petermaerki/puenterswis_heizung_2023_git/README.md

# puenterswis_heizung_2023_git
Puenterswis Heizungsersatz

- [Erfahrungsbericht](./erfahrung_doku/readme.md)
