petermaerki/puenterswis_heizung_2023_git/hardware_zentral/zentral_waermezaehler/readme.txt

https://www.relay.de/produkte/m-bus-master/masterfamilien-w60
