petermaerki/puenterswis_heizung_2023_git/erfahrung_doku/brenner_startzeit/readme.md

# Brenner Startzeit
## Brenner kalt
Puent
12:57 Anforderung an PE1, FA1_TEMP_C ist 24.7C
13:47 PE1 ist warm, die UW Pumpe beginnt zu pumpen.

Vom Moment der Anforderung bis die Pumpe UW anläuft sind 50 Minuten vergangen. Das ist lang.

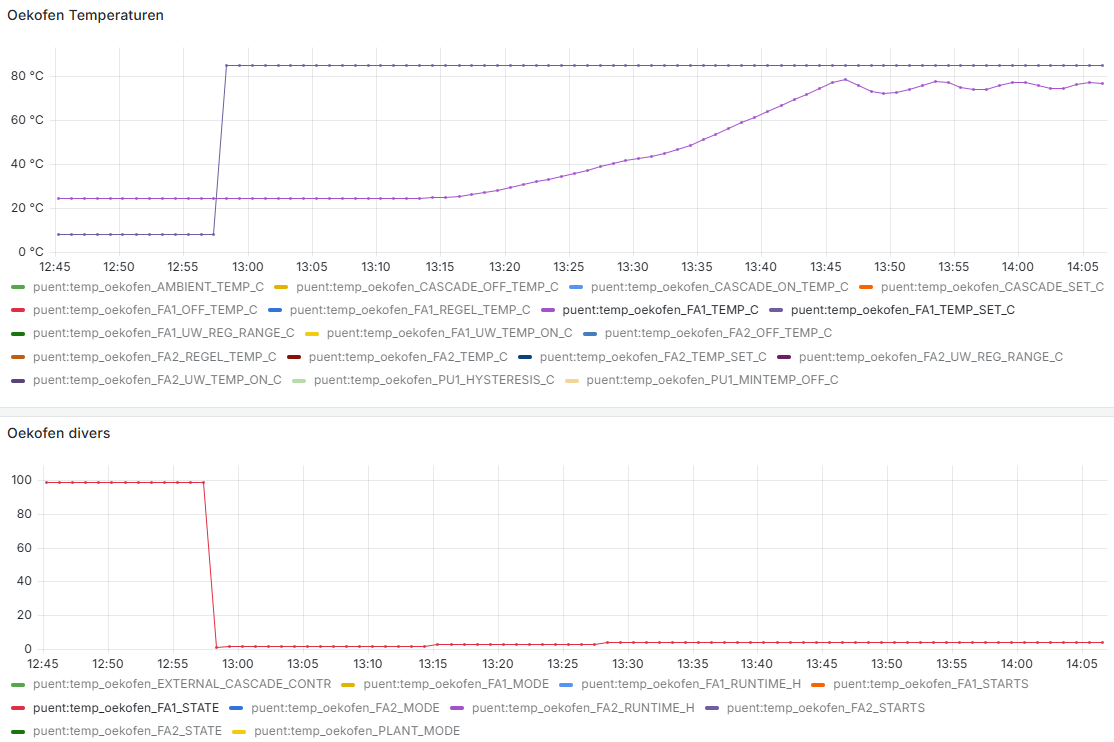
[picture p9: erfahrung_doku/brenner_startzeit/images/brenner_startzeit.png]


http://maerki.com:3000/d/da82d5b6-3fd8-4534-80e5-da1155c11310/uebersicht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

## Brenner bereits warm

Wenn der Brenner bereits warm ist geht es deutlich schneller. z.B. 15 Minuten.
