petermaerki/puenterswis_heizung_2023_git/hardware_zentral/zentral_divers/luefter_ventilator/readme.txt

Luefter klein Bochseln in Loch 150mm

https://cad.onshape.com/documents/6e2a7e5c45c3894bcfb6e976/w/bbece052b184f4fff4f783f4/e/188e28d2e62834fa74d1faa5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

reichelt
Artikel-Nr.: SUN EEC0382B2-0
Axiallüfter, 120x120x38mm, 24V, 197m³/h, 44dBA

grosser Durchmesser 250 mm

https://cad.onshape.com/documents/b72cdd9233a7a05eaaff3341/w/239dae5a9b473663ab37328b/e/b62adbd5fe74eb1d6516e262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
