petermaerki/puenterswis_heizung_2023_git/hardware_dezentral/pcb_kicad/production_v1.0/readme.md

# Upload to JLCPCB

J1: Verschieben
J2: Verschieben
SW1: 90Grad Gegenuhr
U1: 90Grad Uhr
Q1: 180Grad
U2: 180Grad

# Errors to be fixed

C1 ist
alt: C515689, Package 1210
neu: C2897622, Package 1206

Error
The below parts won't be assembled due to data missing.
J1,J2,HOLDER1 designators don't exist in the BOM file.
