petermaerki/puenterswis_heizung_2023_git/hardware_zentral/zentral_steuerung/waveshare/SKU_25739_8-ch_relais_B/README.md

https://www.waveshare.com/modbus-rtu-relay-b.htm

https://www.waveshare.com/wiki/Modbus_RTU_Relay
