petermaerki/puenterswis_heizung_2023_git/software/software-zero/requirements_win.txt

# Auf Windows wird zusätzlich benötigt für zentral\controller_mischventil_test.py

matplotlib
pyqt5
