petermaerki/puenterswis_heizung_2023_git/hardware_dezentral/pcb_kicad/production_v1.0/notes_C7_entfernt.txt

Peter Maerki 2024-03-10_00_15_38

C7 bei allen Leiterplatten ausgeloetet.
Vertraegt sich nicht mit Waveshare Devices welche nur aktiv 1 machen und das 0 passiv mit dem Biasing Network.
