petermaerki/puenterswis_heizung_2023_git/software/software-dezentral/readme_umodbus.md

# MODBUS

| PC | Sensor/Actor | Comment |
| - | - | - |
| Client | Server | new |
| Master | Slave | old |
|  | Host | bad |

## We use these two versions:

* micropython modbus v2.3.7
https://github.com/hmaerki/fork_micropython-modbus/tree/bugfix/on_get_cb-returnvalue-swallowed
https://github.com/hmaerki/fork_micropython-modbus/tree/improve-uart_read_frame
 ->  brainelectronics/micropython-modbus

  * These files have been copied to `micropython/umodbus`

      https://github.com/GimmickNG/pycopy-modbus/tree/mpmodbus-compatibility

      This is a pull request for
https://github.com/brainelectronics/micropython-modbus/pull/56

### Links

* https://www.youtube.com/watch?v=goskYrT9-v4
* https://www.youtube.com/watch?v=BXMauNF7mpU
* https://github.com/brainelectronics/micropython-modbus
* https://pypi.org/project/micropython-modbus/

https://buildmedia.readthedocs.org/media/pdf/pymodbus/latest/pymodbus.pdf

https://www.youtube.com/watch?v=IdTUvQ7X6h8
https://github.com/brainelectronics/micropython-modbus/issues/7

https://de.aliexpress.com/item/1005006139334276.html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

## Documentation

https://micropython-modbus.readthedocs.io/en/latest/umodbus.html#module-umodbus.serial

 * ModbusRTU (client)
   * pins (List[Union[int, Pin], Union[int, Pin]]) – The pins as list [TX, RX]
   * ctrl_pin (int) – The control pin
   * uart_id (int) – The ID of the used UART
 * Serial (server?)

## Hardware

https://micropython-modbus.readthedocs.io/en/latest/EXAMPLES.html#rtu

`RP2 needs "rtu_pins = (Pin(4), Pin(5))" whereas ESP32 can use any pin the following example is for an ESP32`

https://datasheets.raspberrypi.com/pico/Pico-R3-A4-Pinout.pdf
| RX/TX | RP2 | rp2040 | uart_id |
| - | - | - | - |
| TX | Pin(0) | GP0 | 0 |
| RX | Pin(1) | GP1 | 0 |
| TX | Pin(4) | GP2 | 1 |
| RX | Pin(5) | GP3 | 1 |
