petermaerki/puenterswis_heizung_2023_git/software/software-dezentral/rp2_firmware/firmware.md

# Micropython Firmware dezentral

## Actual Firmware

* https://github.com/hmaerki/fork_micropython/blob/hmaerki/XTAL/README_hans.md
* Commit `b18ff701a6b8dee7b2870293053510fd61314032`
* MicroPython v1.22.2-4.gf1d21e75a.dirty on 2024-02-25; Raspberry Pi Pico (slow XTAL) with RP2040
