petermaerki/puenterswis_heizung_2023_git/software/software-zero/doc_collected/pgp.md

# kleopatra

https://github.com/saturneric/GpgFrontend

 * gpg --fingerprint
 * gpg --list-keys
 * gpg --list-secret-keys
