petermaerki/puenterswis_heizung_2023_git/software/software-zero/doc_collected/serial_console.md

# Serial Console

[Enabling Serial Console on Raspberry Pi Zero W](
https://c2plabs.com/blog/2019/04/23/enable-serial-console-on-raspberry-pi-zero-w/)
