petermaerki/puenterswis_heizung_2023_git/hardware_zentral/belimo_waermezaehler_mischer/20240315a_mischventil_abschaetzung.pdf

Belimo Mischventil, Abschätzung

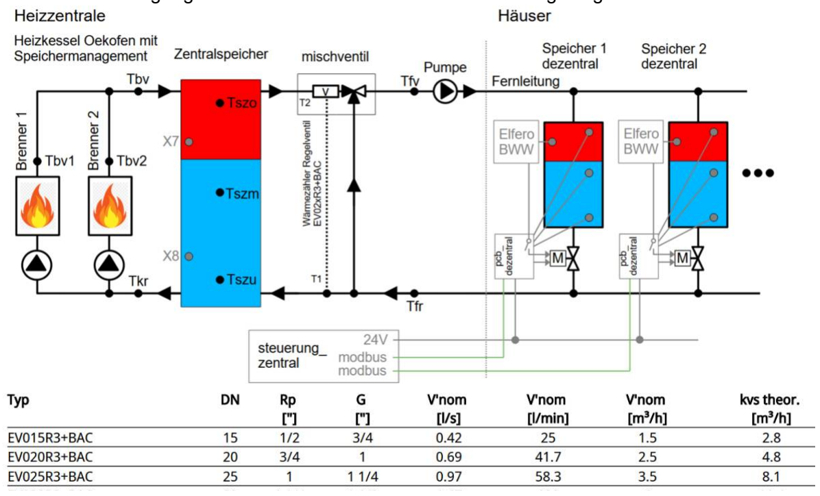
[picture p12: figure]

Pünterswis | Bochslenwis
Typ | EV025R3+BAC EV020R3+BAC
Durchmesser DN25 | DN20
kvs | 8.1 | 4.8 m^3/h
V’nom | 3.5 | 2.5 m^3/h
Fluss beim Laden alle Häuser, Nominalfluss | 2.3 | 1.7 m^3/h
Druckabfall Mischventil @ Nominalfluss | 0.081 | 0.119 bar

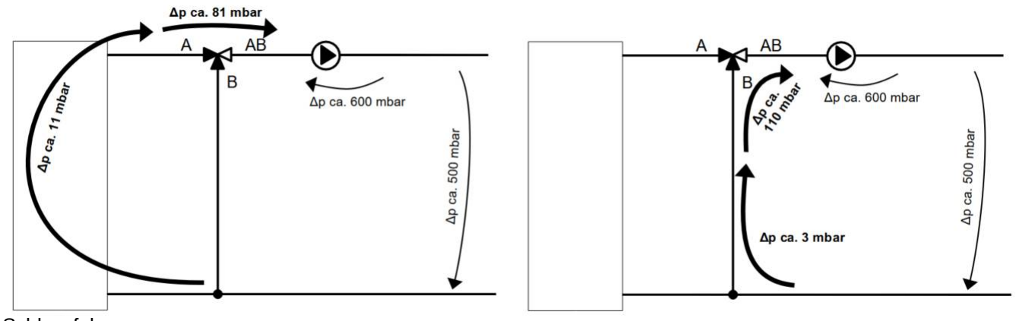
[picture p13: figure]

Dokument | 20240315a_evaluation_typ_gitignore | Peter Märki

Idee: Beimischschaltung für Vorlauftemperaturregelung für die Fernleitung zu den Häusern. Zentrale Steuerung regelt die Position vom EV Ventil: Positionsregelung.

Der Volumenstrom wird durch die Pumpe, die Fernleitung und die Drosseln in den Häusern vorgegeben. Das Mischventil soll lediglich das Mischverhältniss beeinflussen.

Der Druckabfall über den Pufferspeicher und im Bypass-Weg soll deutlich geringer sein als jener über dem Mischventil.

Beispiel Pünterswis
Mischventil A-AB voll offen, Position 90°

Beispiel Pünterswis
Mischventil B-AB voll offen, Position 0°

Schlussfolgerung:
Der Druckabfall über dem Mischer ist mit ca. 0.1 bar deutlich grösser als der Druckabfall in Pufferspeicher oder Bypass-Weg welcher im Bereich 0.01 bar liegt. Das sollte sich gut regeln lassen. Wichtig: grosse Querschnitte und kurze Leitungen zum Speicher.

Falls nur einzelne Häuser geladen werden, so ist der Fluss kleiner. Bei einem einzelnen Haus fliessen noch ca. 0.2 m^3/h. Mit so einem kleinen Fluss könnte die Strömung im Mischventil laminar werden. Allenfalls lässt ich die Temperatur dann nicht mehr sauber regeln.
