petermaerki/puenterswis_heizung_2023_git/hardware_dezentral/dezentral_elfero/20240917a_elfero_schaltpunkte.ods

Sheet: elfero regler dezentral abklaerungen tests
Unterstationen Regler Elfero
2023-08-03 | Entscheid für Umbau
 | Sensor BWW beschriften mit «BWW Warmwasser Klemme 32»
 | Sensor BK entfernen. Fixwiderstand 1100 Ohm auf Klemmen GND und 28.
2023-08-03 | Peter Schär und Peter Märki gehen zu Elfero nach Meisterschwanden.
 | Es hat zwei Testboxen, da kann ein Temperaturregler eingesteckt werden.
 | Teils Trimmer sind marode, teils Kontakte lottern.
 | Nach ca. 5 Stunden kommen wir zur Erkenntnis: Wir verstehen alle nicht
 | wie die beiden Temperatursensoren verknüpft sind.
 | Der Kesselsonsor sollte eigentlich an einen Kessel. Wir haben keinen Kessel und bei uns ist er am Speicher eingesteckt
 | Kessel und Warmwasser Logik sind irgendwie verknüpft
 | Kessellogik spielt mit:
 | Par | 151 | 70 | C
 | Par | 140 | 20 | K
 | wenn BWW kalt so schaltet die Sache bei 70C aus und 70-20C ein. Unklar.
 | Der Warmwassersensor BWW spielt mit:
 | Par | 190 | 45 | C | Warmwasser soll, oberer limit
 | Eingestellte Temperatur für Warmwasser mit der Bedienung vom Endbenutzer
 | Par | 191 | 10 | K
 | Falls der BK Sensor gut gewählt ist, so schaltet es BWW bei 45-10/2 ein und bei 45+10/2 aus.
 | Falls der BK zu hoch oder zu tief ist, schaltet es anders. Wir finden nicht von was das abhängt.
 | Es wäre schön eine einfacher Logik zu haben. Edin experimentiert und schaltet diverses aus und ein, er scheitert.
 | Wir versuchen die Sache einfacher zu machen indem wir den BK Fühler auf eine fixe Temperatur legen.
 | BK |  | BK
 | Festwertwiderstand |  | Angezeigt C
 | 1000 |  | 25 |  | komisch
 | 1050 |  | 31 |  | komisch
 | 1070 |  | 33 |  | hier funktioniert der BW Sensor wie erwartet
 | 1130 |  | 41 |  | hier funktioniert der BW Sensor wie erwartet
 |  |  | 47 |  | komisch
 | 1100 |  | 37 |  | Festwiderstand wahl
 | Wir entscheiden uns: wir ersetzen den BK Sensor durch einen Festwertwiderstand von 1130 Ohm entspricht 41C. Besser 1100 Ohm da Standard.
 | Jetzt verhält sich die Warmwasser BK wir erwartet. Die Sache ist einfacher da nur noch Sensor BWW.
 | Versuche:
 |  | (Par 190) | WW soll | Par 191 | Varieren BW Temperatur
 |  | limite |  |  | ein bei C | aus bei C
 |  | '(55) | 55 | 10 | 50 | 60
 |  | (35) | 35 | 10 | 30 | 40
 |  | '(35) | 35 | 4 | 33 | 37
 | Wir können mit der WW soll und Par 191 die Schaltemperaturen wählen, das ist ok.
 |  |  |  |  |  |  |  |  | Notizen…
 |  |  |  |  | Testgerät |  |  |  | glaube
 |  |  |  |  |  |  |  |  | nicht
 |  |  |  |  |  |  |  |  | alles
2023-07-15
 | Peter Schär und Peter Märki experimentieren mit der Heizung von Peter Schär, Zelglistrasse 48
 | Elfero RDO244?
 | Es gibt zwei Temperatursensoren für den Speicher. Deren Temperatur kann man anschauen:
 | Elfero, «Pfeil nach unten» bis Service, jetzt «Nr» bis 1 oder 21
 |  |  |  |  |  | Elfero |  | Elfero Bezeichnung
 | Sensor oben, etwa dort wo Fernleitung rein kommt |  |  |  |  | Service | 1 | Warmwasser_1 |  | BWW | B58 | Klemme 32
 | Sensor mitte, etwa 20 cm tiefer als sensor oben |  |  |  |  | Service | 21 | Kesseltemperatur |  | BK | B57 | Klemme 28
 |  |  |  |  |  |  |  |  | oben
 |  |  |  |  |  |  |  |  | mitte
 | Experimente, durch Herausziehen der Sensoren
 | Sensor | Sensor
 | oben | mitte | ventil blau | anzeige
 | kalt | kalt | offen | Brenner «1, 2»
 |  | kalt |  |  |  | oben wärmt auf, bei über 50C macht Ventil zu, Anzeige erlischt
 | warm | kalt | zu | -
 |  | kalt |  |  |  | oben raus, kühlt ab, bei unter 40C macht ventil auf
 |  | kalt | offen | Brenner «1, 2»
 | kalt | kalt | offen | Brenner «1, 2»
 | kalt | warm | offen | Brenner «1, 2» |  | mitte rein, passiert nichts
 |  | warm |  |  |  | oben rein, bei über 50C macht Ventil zu, Anzeige erlischt
 | warm | warm | zu | -
 | kalt | warm | zu | - |  | oben raus, passiert nichts
 | kalt |  |  |  |  | mitte raus, bei 21 unter 50C geht ventil auf
 | kalt | kalt | offen | Brenner «1, 2»
 | Schlussfolgerung
 |  | Wenn mitte genügend kalt, so wird mit dem oberen das Ventil auf und zu gemacht und Brenner «1,2» gesteuert.
 |  | Ich verstehe die Logik noch nicht wirklich
 |  | oben unter 40C: ventil auf
 |  | oben über 50C: ventil zu
 | Einstellungen bei Peter Schär
 |  | Par | 140 | Schaltdifferenz der Brennerstufe 1 |  |  |  | 20 | K
 |  | Par | 141 | Schaltdifferenz der Umschaltung Stufe 2 |  |  |  | 10 | K
 |  | Par | 142 | Minimale Einschaltverzögerung STufe 2 |  |  |  | 0 | min
 |  | Par | 190 | Maximalbegrenzung Warmwasser-Solltemperatur |  |  |  | 45 | C
 |  |  | (höher kann der Benutzer nicht gehen?)
 |  | Par | 191 | Schaltdifferenz Warmwasser |  |  |  | 10 | K
 | Warmwasser Solltemperatur Benutzerebene
 |  | (vermutlich auf das bei Par 190 eingestellte maximum eingestellt) |  |  |  |  |  | 45 | C
 |  | Schaltschwellen
 |  |  | Warmwasser Solltemperatur plus ½ Schaltdifferenz Par_191
 |  |  |  |  |  | Heizung ein bei |  | 50 | C
 |  |  | Warmwasser Solltemperatur minus ½ Schaltdifferenz Par_191
 |  |  |  |  |  | Heizung aus bei |  | 40 | C

Sheet: elfero einstellungen 2024
Unterstationen Regler Elfero
2024-06-05 | Einstellungen vorzunehmen bei allen Häusern
 | Parameter 190 legt die maximale Warmwasser Solltemperatur fest.
 | Aktive Schaltschwellen gemäss «Warmwasser Solltemperatur Benutzerebene»
 | Vorgehen
 | Fachmannebene: zu Service mit Pfeil, dann «No» und «+» für 5 s gedrückt halten.
 | Parameter 190 muss auf |  | 55 | sein
 | Parameter 191 muss auf |  | 10 | sein
 | Pfeil nach unten bis |  |  | Solltemperatur Wasser
 | Einstellen der Solltemperaturen mit No und + -
 | Hintergrund: auch in der Nacht und auch bei Frostschutz soll der Speicher für das Brauchwasser warm sein.
 | Info, Bedeutung
 | Hintergrund: Die Ladung soll immer gleich erfolgen.
 | Ausstecken 220V und wieder einstecken (hatte es, dass es erst nach einem Neustart korrekt funktioniert).
 | Standard Raumtemperaturen einstellen |  |  |  |  | Einstellen:
 |  |  |  |  |  | 1 | 5
 |  |  |  |  |  | 2 | 15
 |  |  |  |  |  | 3 | 20
 |  | Diese Temperaturen haben einen Einfluss ab welcher Aussentemperatur die Pumpe zu laufen beginnt.
 | BWW kalt, kleiner 50C |  | BWW heiß, wärmer als 60C
 | Blaues Ventil offen |  | Blaues Ventil zu
Tests mit Ausbaustufe E1
 | Test der Funktion, Start durch Druck auf die Testtaste auf pcb_dezentral |  |  |  |  |  |  | Ohmmeter
 |  |  |  |  |  |  |  | Pin 5 und 6
 | BWW |  |  | Relais Automatik |  | Relais valve_open | blaues ventil soll | soll
 | kalt (< 50) | Taste drücken | 40 Sekunden | 0 | (→ Manuell) | 0 | offen | geschlossen
 | kalt (< 50) |  | 40 Sekunden | 1 | (-> Automatik) | 0 | zu | geschlossen
 | kalt (< 50) |  | 40 Sekunden | 1 | (-> Automatik) | 1 | offen | geschlossen
 | warm(> 60) | Taste drücken | 40 Sekunden | 0 | (→ Manuell) | 0 | zu | offen
 | warm(> 60) |  | 40 Sekunden | 1 | (-> Automatik) | 0 | zu | offen
 | warm(> 60) |  | 40 Sekunden | 1 | (-> Automatik) | 1 | offen | offen
 | Testen ob Anforderung auf Elfero 5 und 6 mit Ohmmeter
