petermaerki/puenterswis_heizung_2023_git/hardware_zentral/zentral_temperatursensoren/20240707a_beschriftung_zentral_temperatursensoren_13.ods

zentral_temperatursensoren Modbus 13: Messung von Temperaturen bei den Brennern. Messung von Temperaturen in der Heizzentrale. pcb_dezentral mit ds18b20 Sensoren. 24V Versorgung von steuerung_zentral Verbindung zu steuerung_zentral über Modbus. LED rot:TX und blau:RX. Nichts ändern! 2024 Peter Märki 0764772290, Peter Schär 0786326934
zentral_temperatursensoren Modbus 13: Messung von Temperaturen bei den Brennern. Messung von Temperaturen in der Heizzentrale. pcb_dezentral mit ds18b20 Sensoren. 24V Versorgung von steuerung_zentral Verbindung zu steuerung_zentral über Modbus. LED rot:TX und blau:RX. Nichts ändern! 2024 Peter Märki 0764772290, Peter Schär 0786326934
