petermaerki/puenterswis_heizung_2023_git/hardware_dezentral/dezentral_beschriftung/20240519a_beschriftung_verteilerboxen_fernleitung.ods

Schlaufbox: Fernleitung zur Heizzentrale 6 Adernpaare, max 24V | Schlaufbox: Fernleitung zur Heizzentrale 6 Adernpaare, max 24V
Schlaufbox: Fernleitung zur Heizzentrale 6 Adernpaare, max 24V | Schlaufbox: Fernleitung zur Heizzentrale 6 Adernpaare, max 24V
Schlaufbox: Fernleitung zur Heizzentrale 6 Adernpaare, max 24V | Schlaufbox: Fernleitung zur Heizzentrale 6 Adernpaare, max 24V
Schlaufbox: Fernleitung zur Heizzentrale 6 Adernpaare, max 24V | Schlaufbox: Fernleitung zur Heizzentrale 6 Adernpaare, max 24V
Schlaufbox: Fernleitung zur Heizzentrale 6 Adernpaare, max 24V | Schlaufbox: Fernleitung zur Heizzentrale 6 Adernpaare, max 24V
Schlaufbox: Fernleitung zur Heizzentrale 6 Adernpaare, max 24V | Schlaufbox: Fernleitung zur Heizzentrale 6 Adernpaare, max 24V
Schlaufbox: Fernleitung zur Heizzentrale 6 Adernpaare, max 24V | Schlaufbox: Fernleitung zur Heizzentrale 6 Adernpaare, max 24V
Schlaufbox: Fernleitung zur Heizzentrale 6 Adernpaare, max 24V | Schlaufbox: Fernleitung zur Heizzentrale 6 Adernpaare, max 24V
Schlaufbox: Fernleitung zur Heizzentrale 6 Adernpaare, max 24V | Schlaufbox: Fernleitung zur Heizzentrale 6 Adernpaare, max 24V
Schlaufbox: Fernleitung zur Heizzentrale 6 Adernpaare, max 24V | Schlaufbox: Fernleitung zur Heizzentrale 6 Adernpaare, max 24V
Schlaufbox: Fernleitung zur Heizzentrale 6 Adernpaare, max 24V | Schlaufbox: Fernleitung zur Heizzentrale 6 Adernpaare, max 24V
Schlaufbox: Fernleitung zur Heizzentrale 6 Adernpaare, max 24V | Schlaufbox: Fernleitung zur Heizzentrale 6 Adernpaare, max 24V
