petermaerki/puenterswis_heizung_2023_git/hardware_zentral/belimo_waermezaehler_mischer/20240506a_spannung_zu_winkel.ods

Belimo Wärmezähler Evaluation, Fluss, Druckabfall, Regelung
Puent | fluss max |  | 2.3 | m^3/h
Bochs | fluss max |  | 1.656 | m^3/h
Puent | Leistung max |  | 67 | kW
Bochs | Leistung max |  | 49 | kW
Belimo BAC
belimo_EV..R3_BAC_datasheet_de-ch
belimo_notes-for-project-planning_3-way-energy-valves_de-ch.pdf
Ich interpretiere «minimaler Druckabfall» als Druckabfall bei Ventil voll offen und gewünschtem Fluss.
 |  |  | Aus Diagramm |  | Gemaess Formel, passt
 |  |  | Druckabfall Mischventil
 | fluss max |  | DN20 | DN25 | DN15 | DN20 | DN25
Puent | 2.3 | m^3/h | 0.20 | 0.07 | 0.67 | 0.23 | 0.08 | bar
Bochs | 1.656 | m^3/h | 0.10 | 0.04 | 0.35 | 0.12 | 0.04 | bar
Ein Haus | 0.15 | m^3/h |  |  | 0.0029 | 0.0010 | 0.0003 | bar
Annahme: Wir belassen die Drosseln und den Volumenstrom wie es ist (2023).
 | Beispiel Pumpe Puent |  | ModulA 40-6 220 RED
 |  |  |  |  | Maximaldruck
 |  |  |  |  | 60000 | Pa
 |  |  |  |  | 0.6 | bar
 |  |  |  |  | Heute eingestellt auf 0.5 bar.
Bei maximalem Heizbedarf muss genügend Wärme transportiert werden.
Die Nominalflusswerte müssen erreicht werden.
 |  | Ist mir unklar. Kann ich minimal 25% von V’nom einstellen?
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
