petermaerki/puenterswis_heizung_2023_git/hardware_dezentral/haeuser_spezial/13/20240707a_vergleich_varianten.ods

 | Variante zusätzliche Pumpe in Haus 13 | Variante zusätzliche Pumpe in Haus 13 | Variante mit Pumpe zentral
 | Pumpe pumpt in reguläre Richtung | Pumpe pumpt gegen reguläre Richtung
Vorteil | Solaranlage überhitzt nicht mehr | Solaranlage überhitzt nicht mehr | Solaranlage überhitzt nicht mehr
Zähler | Wärmezähler funktioniert sicher | Wärmezähler funktioniert verm. nicht | Wärmezähler funktioniert sicher
Installation | Installation Pumpe | Installation Pumpe | keine
 | Ansteuerung Pumpe | Ansteuerung Pumpe
 | Risiko Pumpe läuft mit, Verhalten? | Risiko Pumpe läuft mit, Verhalten?
 | Pumpt vermutlich im wesentlichen nur zur Zentrale | Pumpt vermutlich im wesentlichen nur zur Zentrale
 | Fernleitung wird bis zur Zentrale heiß 2 kW Verlust beim Laden Initial Leitungen wärmen | Fernleitung wird bis zur Zentrale heiß 2 kW Verlust beim Laden Initial Leitungen wärmen | Fernleitung wird bis zur Zentrale heiß 2 kW Verlust beim Laden Initial Leitungen wärmen
Laden zentralen Speicher, unklar ob das geht |  |  | Unklar: Kann oberen Teil (950 Liter) von Zentralen Speicher laden falls dieser nicht schon heiß ist.
Laden dezentrale Speicher |  |  | Regel: falls Haus 13 zu heiß: blaues ventil H13 auf Mischventil zu (klein Fluss zentraler Speicher) Pumpe ein falls TFv grösser 55C: Häuser zuschalten (einfach wäre: gerade alle 7 guten)
 |  |  | allenfalls bringt H13 genügend Wärme weg alleine mit dem Aufwärmen der Fernleitung. Nutzen Haus 13, wenig Nutzen MEG. Unfair Wärmeabrechnung, Korrekturbuchung.
