petermaerki/puenterswis_heizung_2023_git/hardware_dezentral/dezentral_beschriftung/elfero/20240412a_beschriftung_kebeletiketten.ods

Temperatursensor BA Witterungsfühler Aussenwand, Elfero | Temperatursensor BV Vorlauffühler Bodenheizung, Elfero | Temp.sensor BWW Warmwasserfühler Speicher, Elfero | zur Fernleitung zur Heizzentrale max 24V | Wärmezähler Techem Fernleitung | steuerung_dezentral zu elfero 230V | elfero zu ventil blau 230V | Fernleitung zur Heizzentrale 6 Adernpaare, max 24V
Temperatursensor BA Witterungsfühler Aussenwand, Elfero | Temperatursensor BV Vorlauffühler Bodenheizung, Elfero | Temp.sensor BWW Warmwasserfühler Speicher, Elfero | zur Fernleitung zur Heizzentrale max 24V | Wärmezähler Techem Fernleitung | steuerung_dezentral zu elfero 230V | elfero zu ventil blau 230V | Fernleitung zur Heizzentrale 6 Adernpaare, max 24V
Temperatursensor BA Witterungsfühler Aussenwand, Elfero | Temperatursensor BV Vorlauffühler Bodenheizung, Elfero | Temp.sensor BWW Warmwasserfühler Speicher, Elfero | zur Fernleitung zur Heizzentrale max 24V | Wärmezähler Techem Fernleitung | steuerung_dezentral zu elfero 230V | elfero zu ventil blau 230V | Fernleitung zur Heizzentrale 6 Adernpaare, max 24V
Temperatursensor BA Witterungsfühler Aussenwand, Elfero | Temperatursensor BV Vorlauffühler Bodenheizung, Elfero | Temp.sensor BWW Warmwasserfühler Speicher, Elfero | zur Fernleitung zur Heizzentrale max 24V | Wärmezähler Techem Fernleitung | steuerung_dezentral zu elfero 230V | elfero zu ventil blau 230V | Fernleitung zur Heizzentrale 6 Adernpaare, max 24V
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
Temperatursensor BA Witterungsfühler Aussenwand, Elfero | Temperatursensor BV Vorlauffühler Bodenheizung, Elfero | Temp.sensor BWW Warmwasserfühler Speicher, Elfero | zur Fernleitung zur Heizzentrale max 24V | Wärmezähler Techem Fernleitung | steuerung_dezentral zu elfero 230V | elfero zu ventil blau 230V | Fernleitung zur Heizzentrale 6 Adernpaare, max 24V
Temperatursensor BA Witterungsfühler Aussenwand, Elfero | Temperatursensor BV Vorlauffühler Bodenheizung, Elfero | Temp.sensor BWW Warmwasserfühler Speicher, Elfero | zur Fernleitung zur Heizzentrale max 24V | Wärmezähler Techem Fernleitung | steuerung_dezentral zu elfero 230V | elfero zu ventil blau 230V | Fernleitung zur Heizzentrale 6 Adernpaare, max 24V
Temperatursensor BA Witterungsfühler Aussenwand, Elfero | Temperatursensor BV Vorlauffühler Bodenheizung, Elfero | Temp.sensor BWW Warmwasserfühler Speicher, Elfero | zur Fernleitung zur Heizzentrale max 24V | Wärmezähler Techem Fernleitung | steuerung_dezentral zu elfero 230V | elfero zu ventil blau 230V | Fernleitung zur Heizzentrale 6 Adernpaare, max 24V
Temperatursensor BA Witterungsfühler Aussenwand, Elfero | Temperatursensor BV Vorlauffühler Bodenheizung, Elfero | Temp.sensor BWW Warmwasserfühler Speicher, Elfero | zur Fernleitung zur Heizzentrale max 24V | Wärmezähler Techem Fernleitung | steuerung_dezentral zu elfero 230V | elfero zu ventil blau 230V | Fernleitung zur Heizzentrale 6 Adernpaare, max 24V
