petermaerki/puenterswis_heizung_2023_git/hardware_zentral/zentral_steuerung/raspberry_pi_4_b_pinout_configuration/pinout.ods

https://www.raspberrypi.com/documentation/computers/raspberry-pi.html
Pin 40 | GPIO |  | Function | I2C | SPI0 | SPI1 | Serial | PWM
1 |  |  | 3.3V power
2 |  |  | 5V power
3 | GPIO_2 | pull-up fix |  | SDA |  |  |  |  | GPIO4 als onewire
4 |  |  | 5V power
5 | GPIO_3 | pull-up fix |  | SCL
6 |  |  | 0V
7 | GPIO_4 | GPCLK0
8 | GPIO_14 |  |  |  |  |  | TXD
9 |  |  | 0V
10 | GPIO_15 |  |  |  |  |  | RXD
11 | GPIO_17 |  |  |  |  | CE1
12 | GPIO_18 | PCM_CLK |  |  |  | CE0 |  | hardware PWM possible
13 | GPIO_27
14 |  |  | 0V
15 | GPIO_22
16 | GPIO_23
17 |  |  | 3.3V power
18 | GPIO_24
19 | GPIO_10 |  |  |  | MOSI
20 |  |  | 0V
21 | GPIO_9 |  |  |  | MISO
22 | GPIO_25
23 | GPIO_11 |  |  |  | SCLK
24 | GPIO_8 |  |  |  | CE0
25 |  |  | 0V
26 | GPIO_7 |  |  |  | CE1
27 | GPIO_0 | ID_SD
28 | GPIO_1 | ID_SC
29 | GPIO_5
30 |  |  | 0V
31 | GPIO_6
32 | GPIO_12 | PWM0 |  |  |  |  |  | hardware PWM possible
33 | GPIO_13 | PWM1 |  |  |  |  |  | hardware PWM possible
34 |  |  | 0V
35 | GPIO_19 | PCM_FS |  |  |  | MISO |  | hardware PWM possible
36 | GPIO_16 |  |  |  |  | CE2
37 | GPIO_26
38 | GPIO_20 | PCM_DIN |  |  |  | MOSI
39 |  |  | 0V
40 | GPIO_21 | PCM_DOUT |  |  |  | SCLK
GPIO | 3.3V logik
 | pull_up or pull_down per sw
 | Software PWM on all pins
