petermaerki/puenterswis_heizung_2023_git/hardware_zentral/zentral_steuerung/stromverbrauch/20231119a_stromverbrauch.ods

 |  | ganz grob |  |  | A | V | W | W
pcb_dezentral
 |  | pico |  |  | 0.03 | 5 | 0.15
 |  | RS485 |  |  | 0.0416666666666667 | 6 | 0.25
 |  | Schaltregler | 0.7 |  | 0.0238095238095238 | 24 |  | 0.571428571428572
 |  | Relais
 |  | Finder 46.61.9.024.0040 |  | automatik | 0.02 | 24 |  | 0.48
 |  | Finder 46.61.9.024.0040 |  | valve | 0.02 | 24 |  | 0.48
 |  |  |  |  |  |  | Total | 1.53142857142857
 |  | Total Strom pro Haus |  |  | 0.0638095238095238 | 24
Häuser pro Kabel |  | 4 |  |  |  |  |  | 6.12571428571429
 |  | Strom |  |  | 0.255238095238095 | 24
 |  |  |  | Sicherung dimmensionieren auf 0.5 A, das Brennt noch nicht.
Häuser |  | 16 |  |  | 1.021 |  | Beispiel 1. Etappe da groesser
Zentrale | pcb_dezentral | 4 |  |  | 0.0952380952380953
Regelkugelhahn |  |  |  |  | 0.190
Relaimodul, unklar Daumen in Luft |  |  |  |  | 0.1
Switch Ethernet, unklar Daumen in Luft |  |  |  |  | 0.03
pi 2 w |  |  |  |  | 0.0416666666666667
 |  |  |  | Total | 1.478 | A
RP pi 2w auch ab 24V? |  | https://www.pidramble.com/wiki/benchmarks/power-consumption
 |  | braucht ca 1W, könnte also auch locker an 24v laufen.
Braucht Zentral Netzgerät mit doppeltem Strom, wahl |  |  |  | Faktor | 1.5
 |  |  |  |  | A | V |  | W
 | Vorschlag Strom Netzgerät |  |  |  | 2.21678571428571 | 24 |  | 53.2028571428571
