petermaerki/puenterswis_heizung_2023_git/erfahrung_doku/impressionen/readme.md

# Impressionen

Ein Teil der Steuerung: pcb_dezentral (Eigenentwicklung) mit RP2040 und Micropython. Erfassen von Temperaturen, Steuern von Relais und kommunizieren per Modbus.

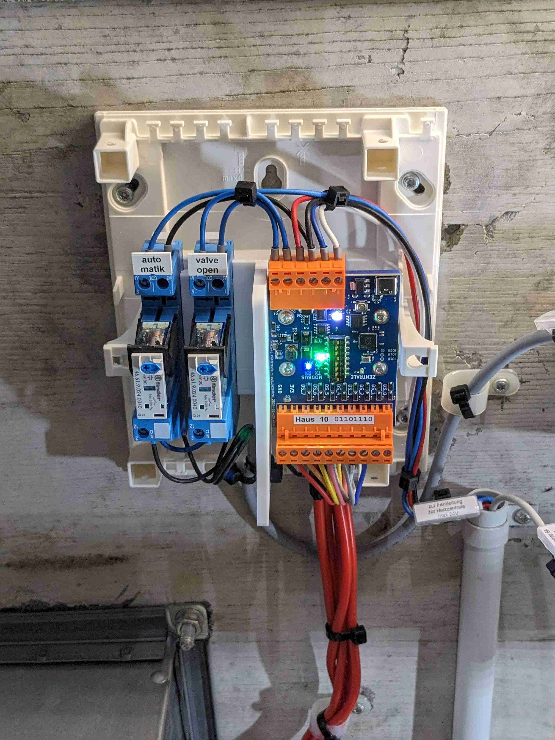
[picture p41: erfahrung_doku/impressionen/images/20240605_155812.jpg]


Bestehende Heizregler dezentral.

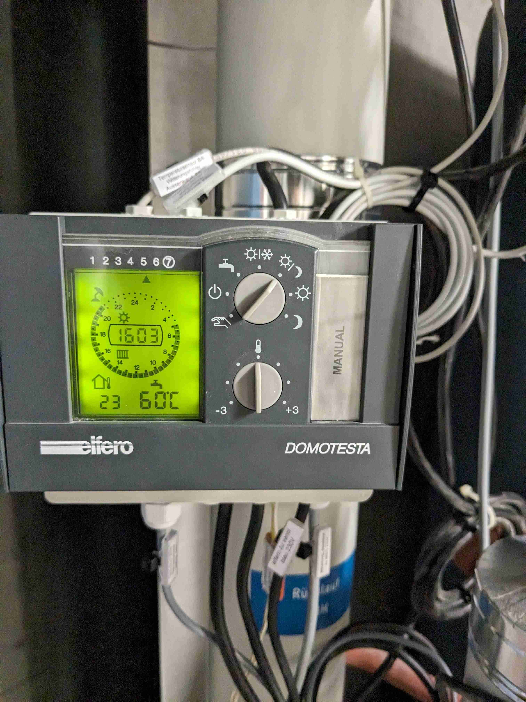
[picture p42: erfahrung_doku/impressionen/images/20240614_155023.jpg]

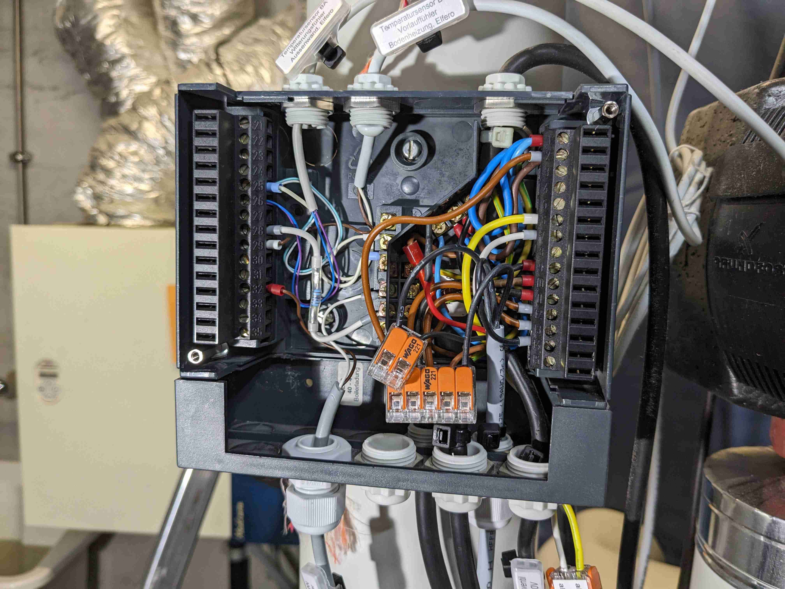
[picture p43: erfahrung_doku/impressionen/images/20240607_101846.jpg]


Verkabelung der Siedlung, viele Kabel, viele Verbindungen

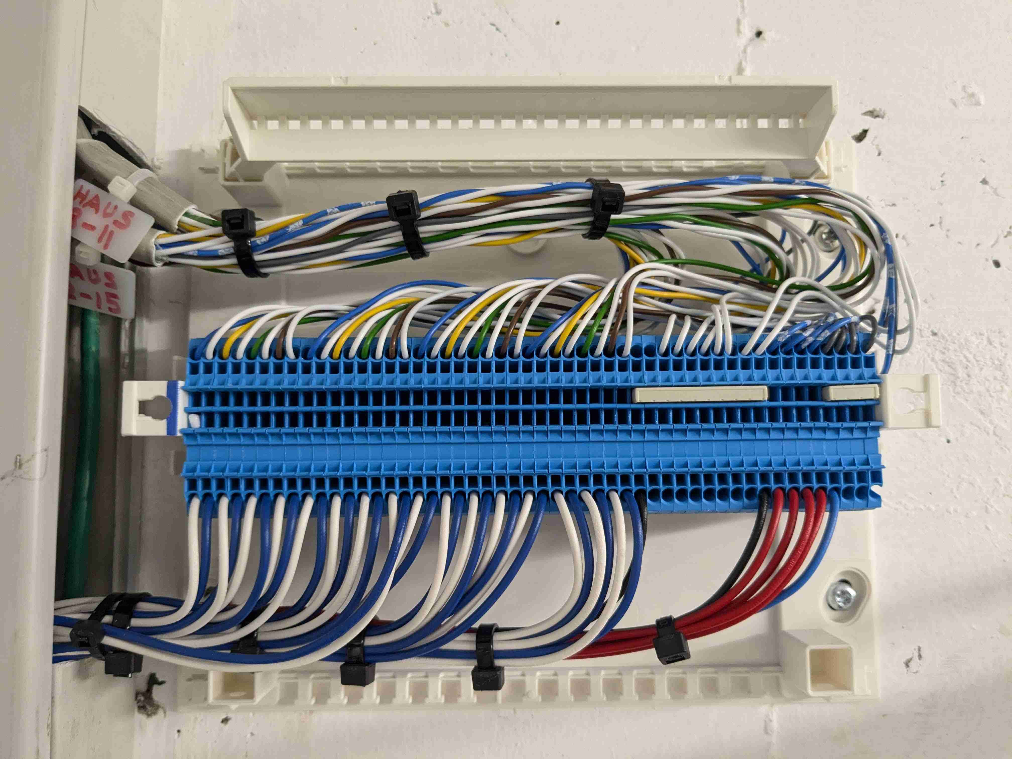
[picture p44: erfahrung_doku/impressionen/images/20240907_103643.jpg]


Dezentrale Speicher mit zusätzlichen Sensoren DS18B20

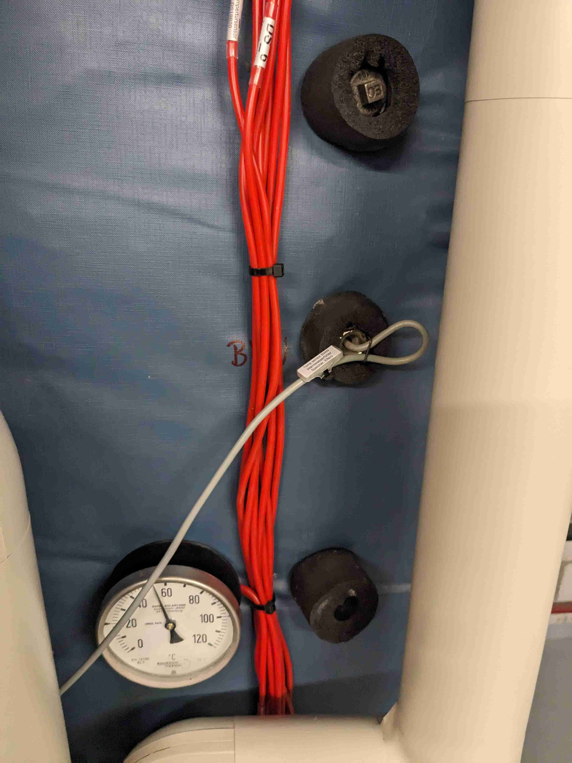
[picture p45: erfahrung_doku/impressionen/images/20240612_170802.jpg]


Sensoren geklebt am zentralen Pufferspeicher

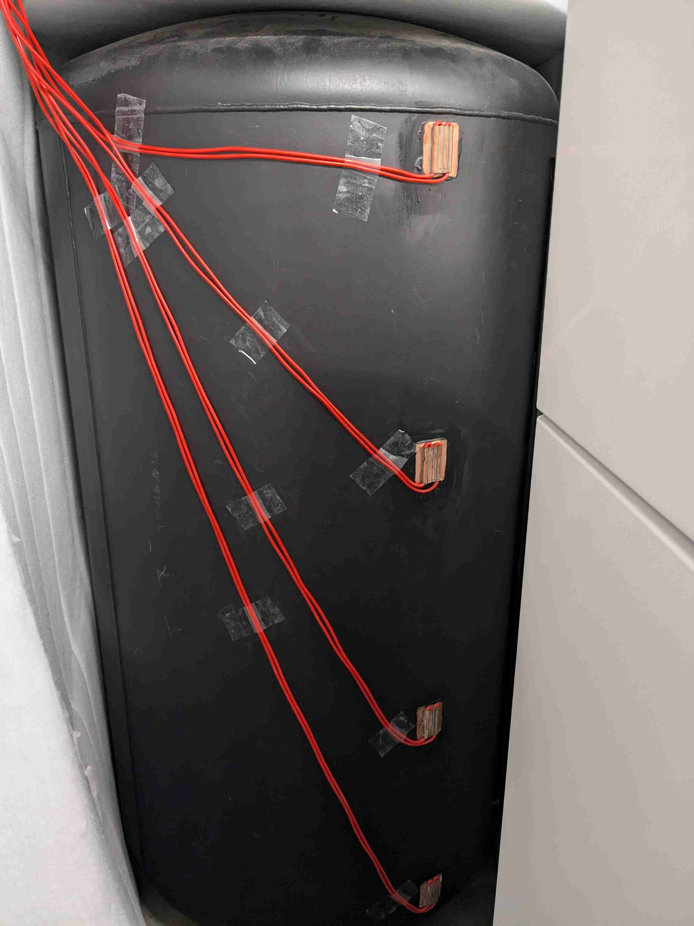
[picture p46: erfahrung_doku/impressionen/images/20240825_102801.jpg]

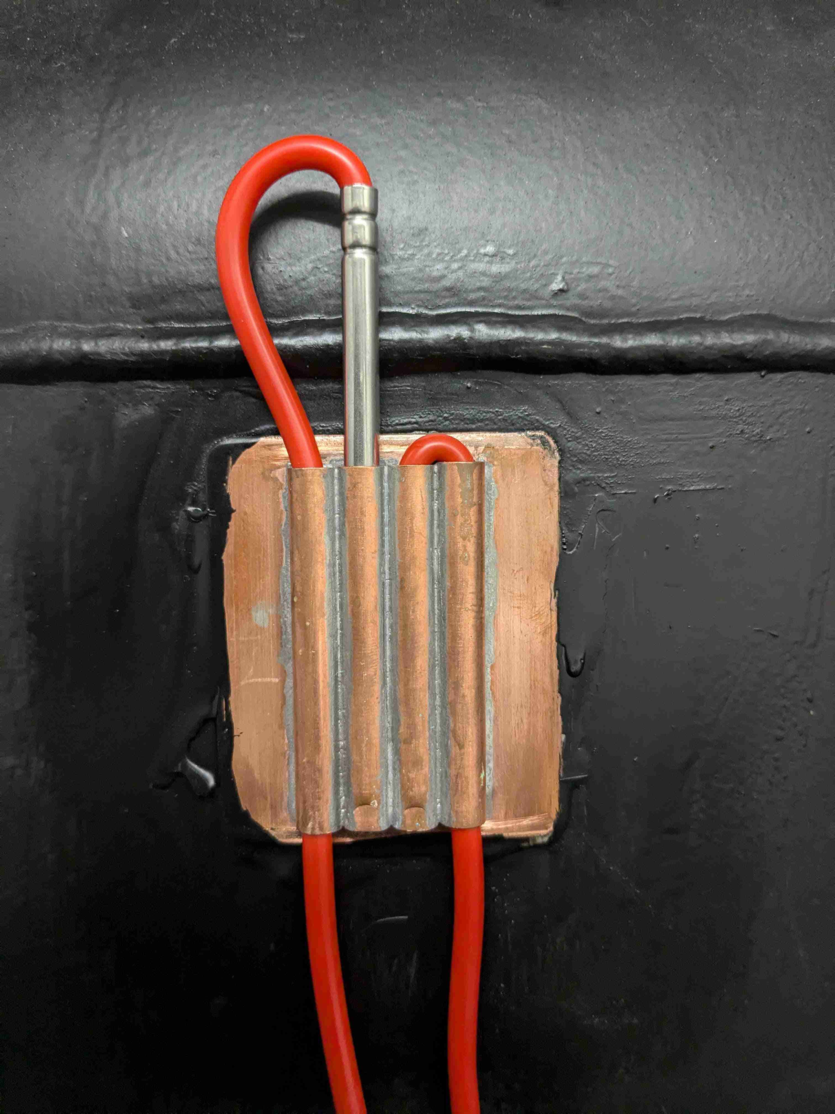
[picture p47: erfahrung_doku/impressionen/images/20240825_101207.jpg]


Notheizung, Mischventil, Wärmezähler, Fernleitungspumpe im Bau, noch nicht isoliert.

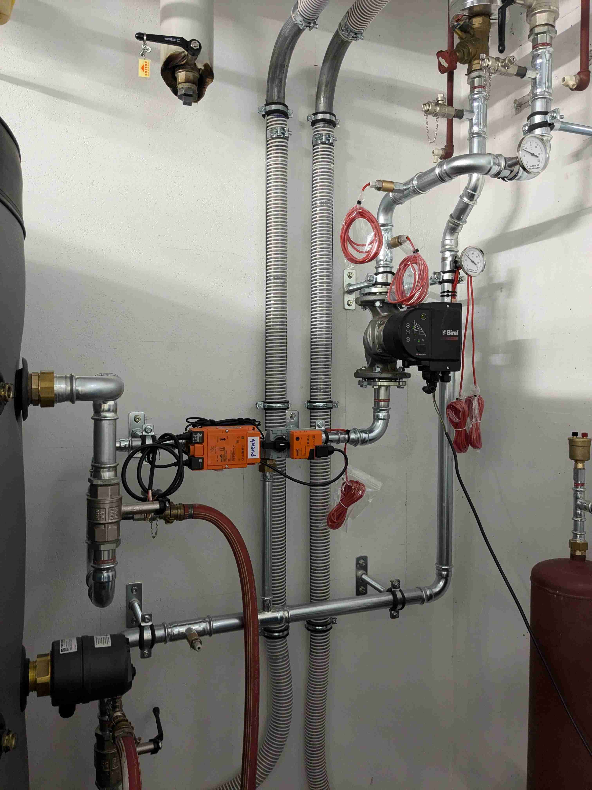
[picture p48: erfahrung_doku/impressionen/images/20240901_174543.jpg]


Brennteller neu

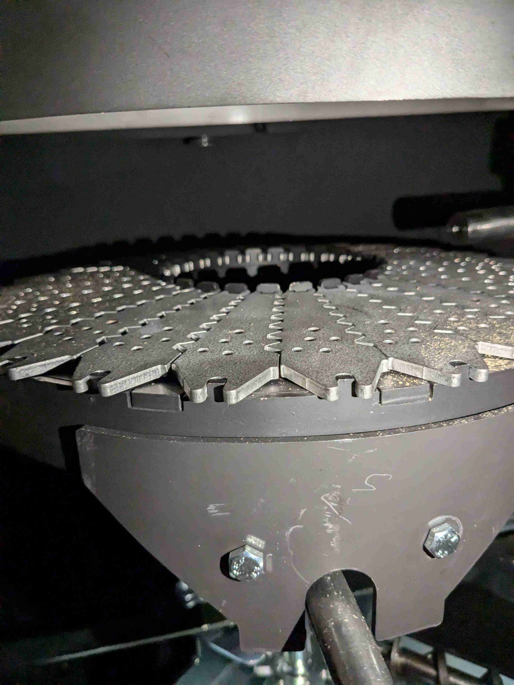
[picture p49: erfahrung_doku/impressionen/images/20240901_180650.jpg]

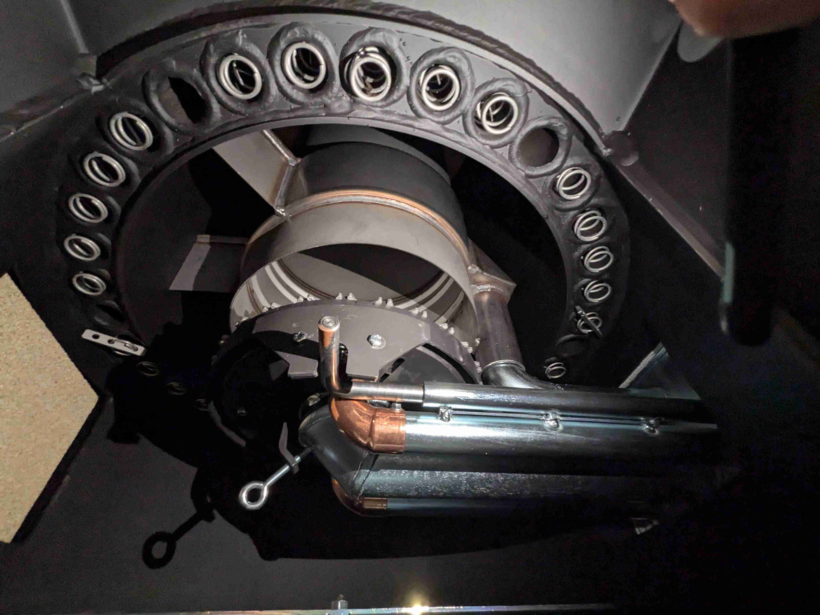
[picture p50: erfahrung_doku/impressionen/images/20240901_180716.jpg]


Erster Brand (initial etwas viel Pellets auf dem Brennteller)

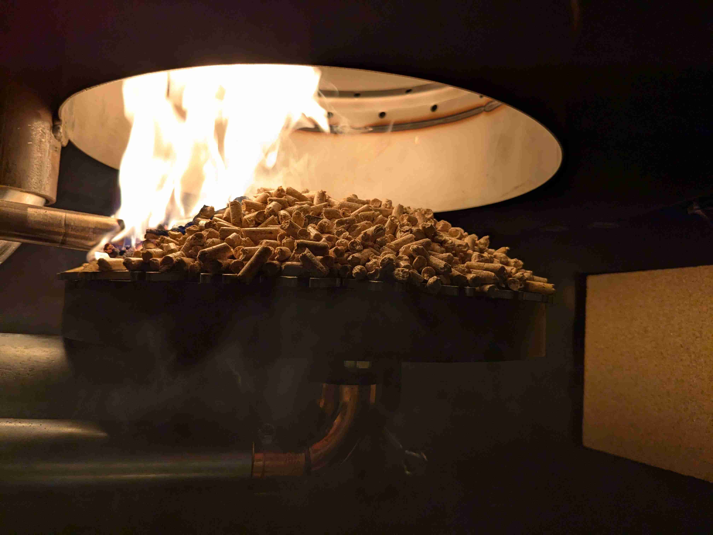
[picture p51: erfahrung_doku/impressionen/images/20240923_094151138.jpg]

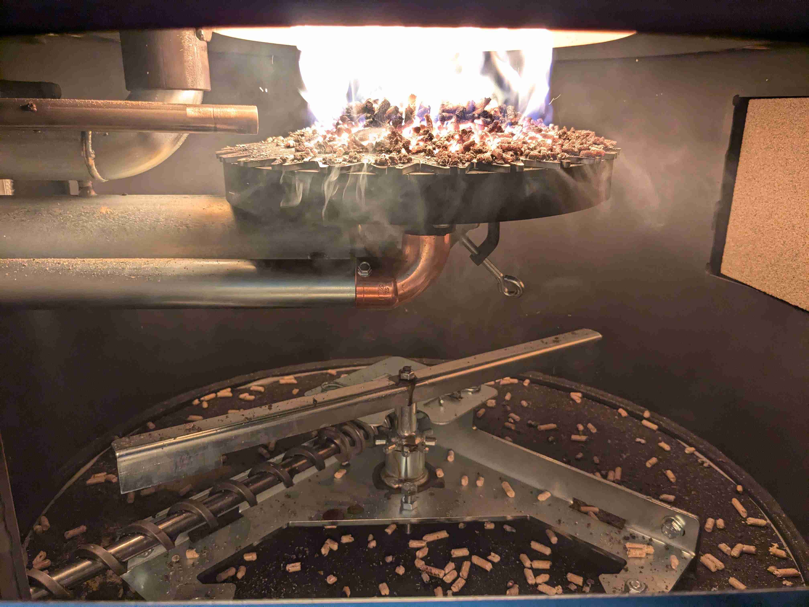
[picture p52: erfahrung_doku/impressionen/images/20240923_100241590.jpg]


Pelletsbunker

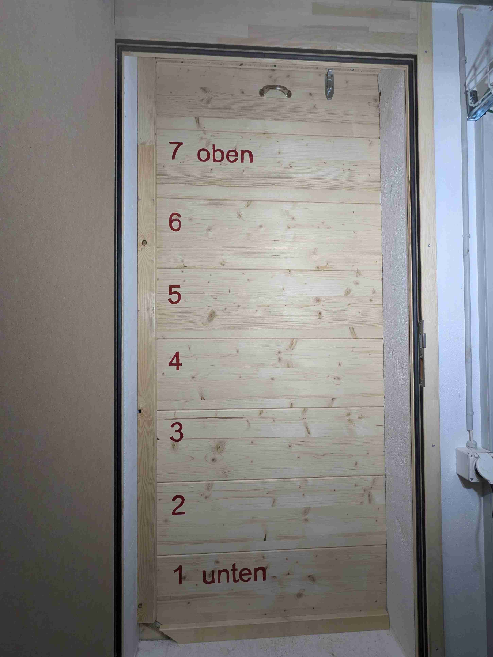
[picture p53: erfahrung_doku/impressionen/images/20240920_142544.jpg]

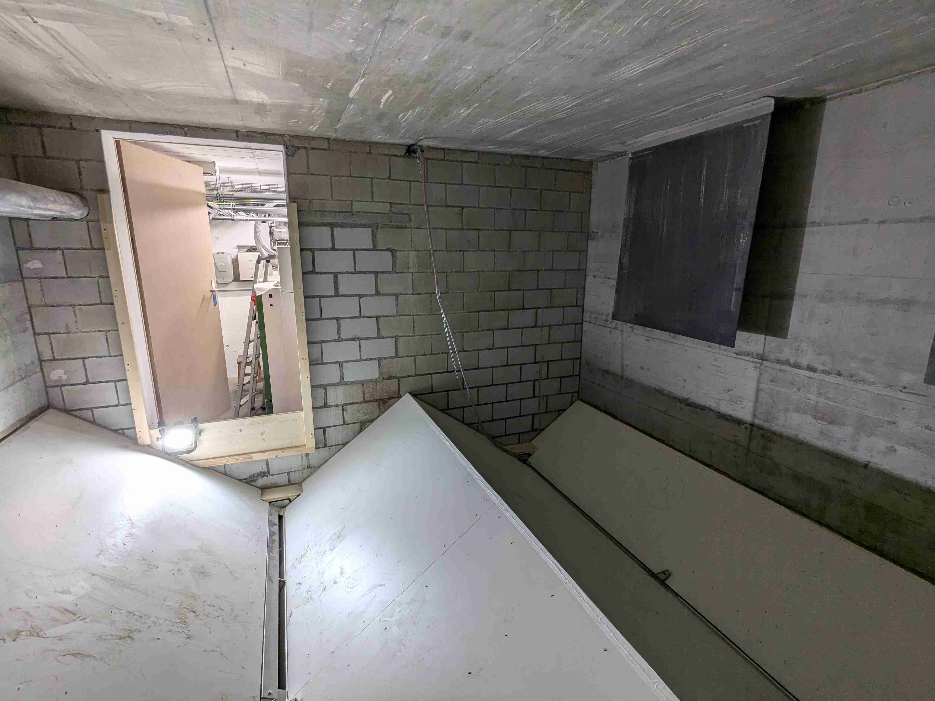
[picture p54: erfahrung_doku/impressionen/images/20240920_180817.jpg]

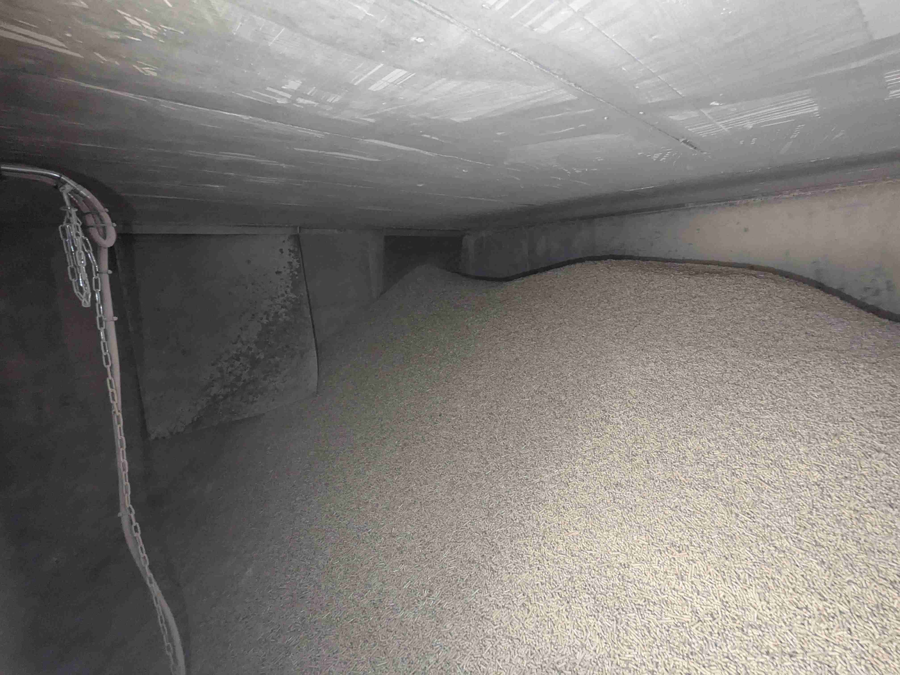
[picture p55: erfahrung_doku/impressionen/images/20240926_082835350.jpg]

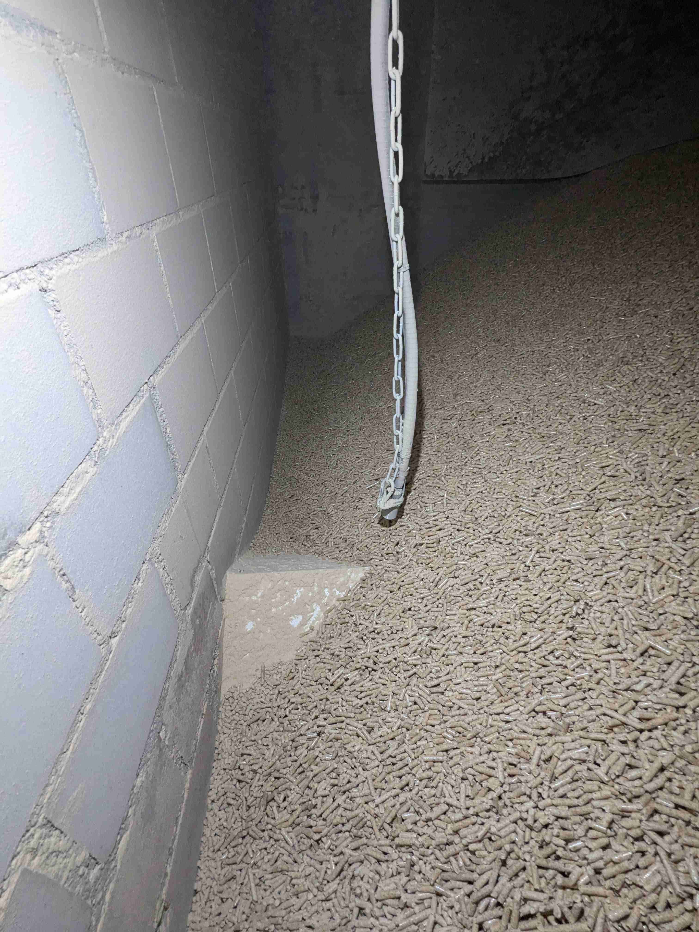
[picture p56: erfahrung_doku/impressionen/images/pellets.jpg]


Fernleitungspumpe und Mischventil

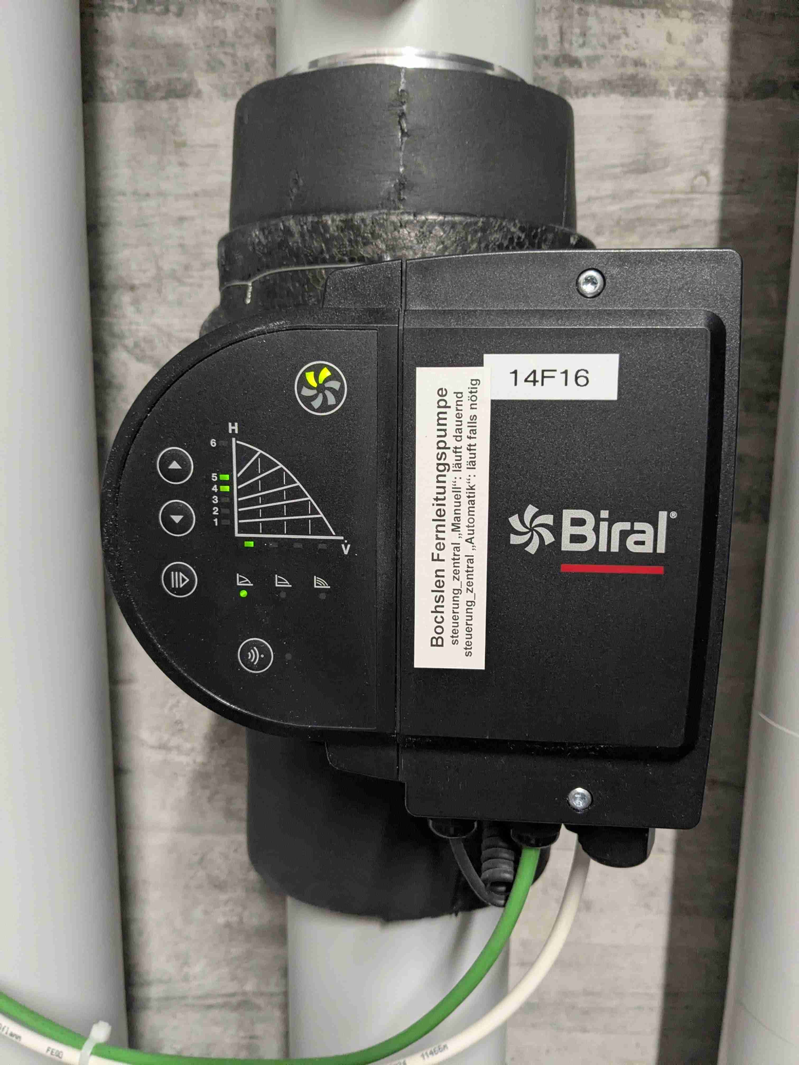
[picture p57: erfahrung_doku/impressionen/images/20241025_173034.jpg]

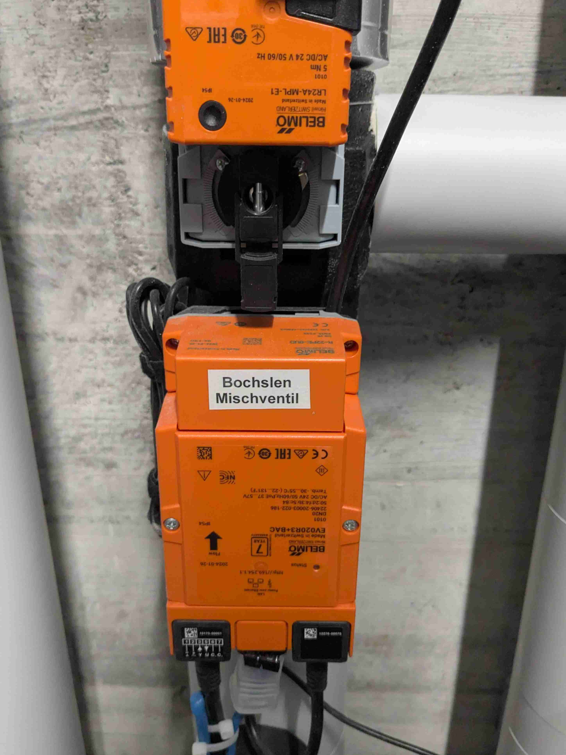
[picture p58: erfahrung_doku/impressionen/images/20241025_173037.jpg]


Isolation

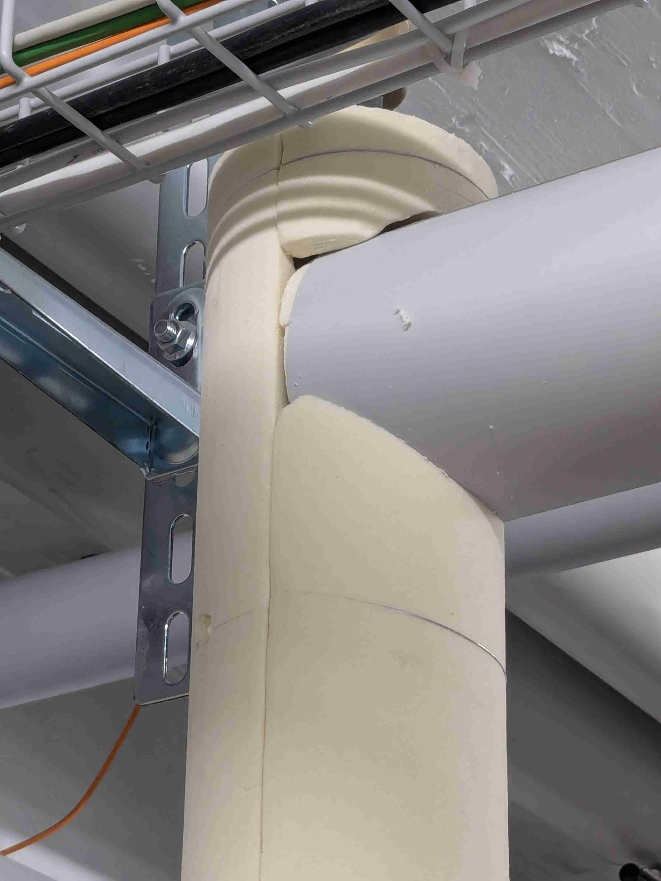
[picture p59: erfahrung_doku/impressionen/images/20240924_220246561.jpg]


Heizzentrale

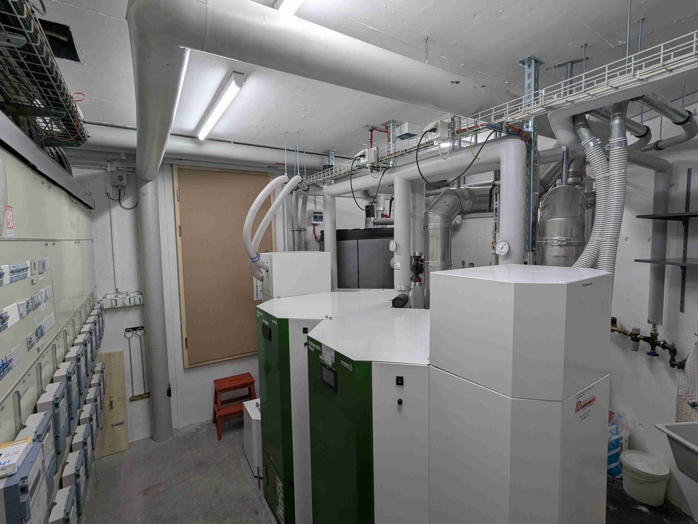
[picture p60: erfahrung_doku/impressionen/images/20241025_170356.jpg]


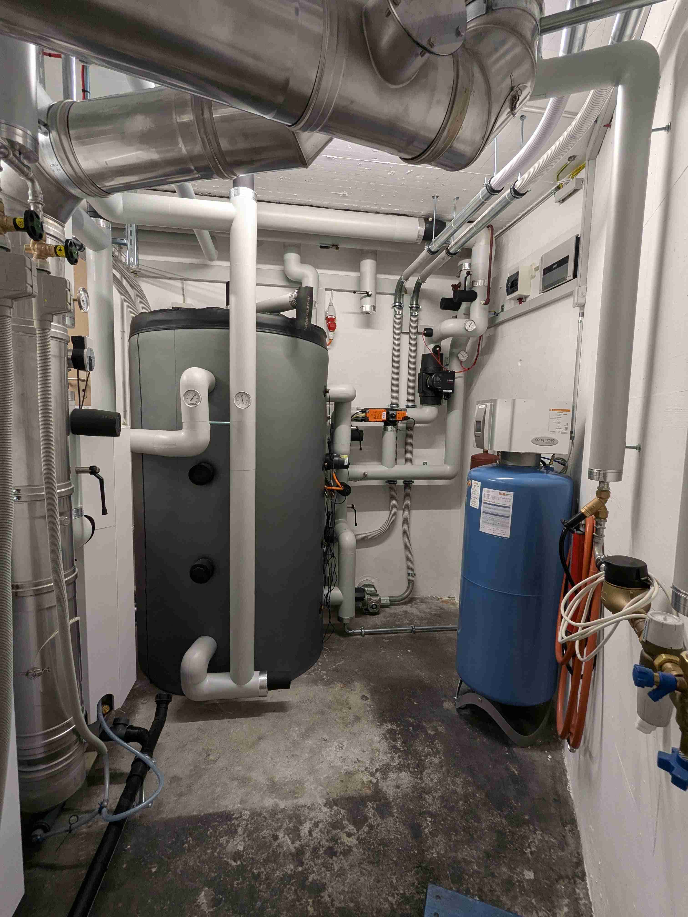
[picture p61: erfahrung_doku/impressionen/images/20241003_203341.jpg]


Kamin, ein Brenner auf 100%

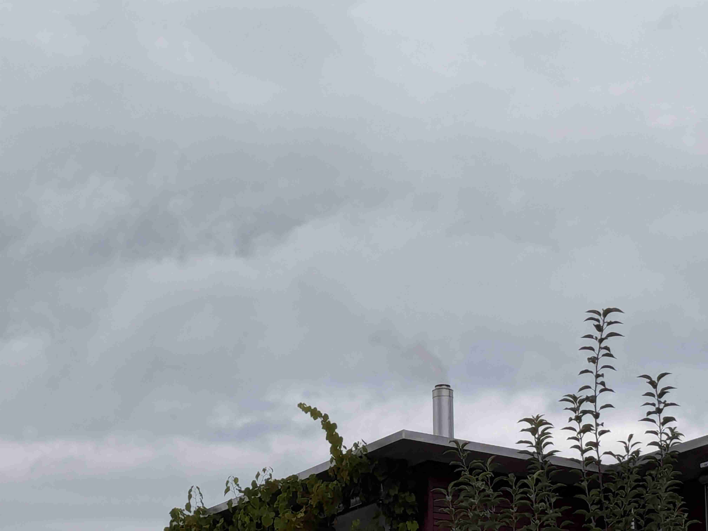
[picture p62: erfahrung_doku/impressionen/images/20240924_110531425.jpg]

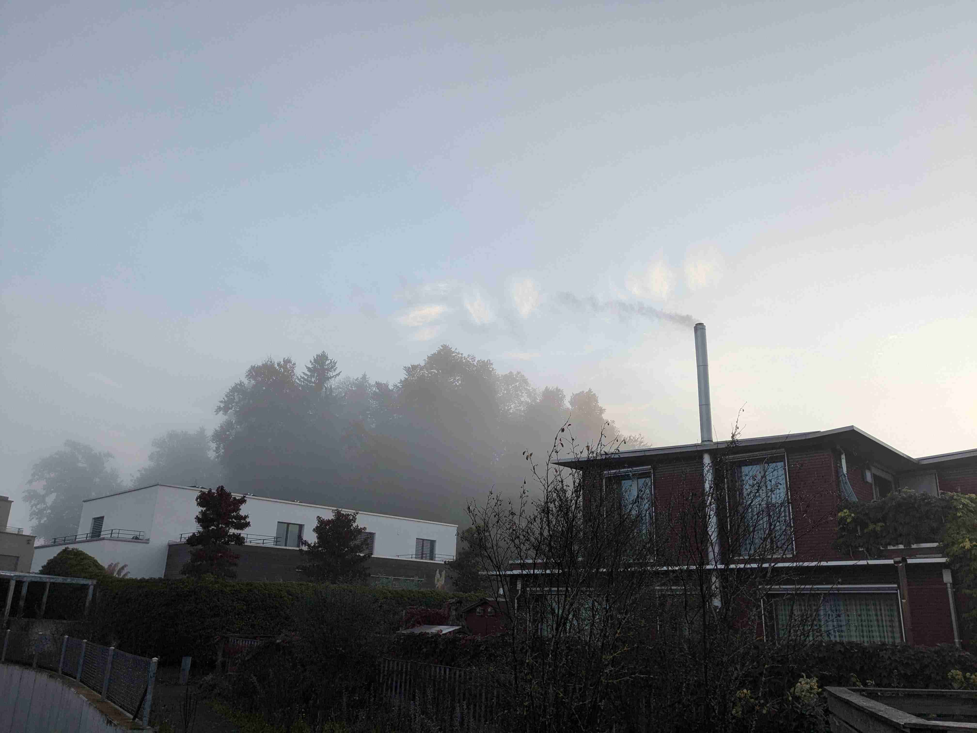
[picture p63: erfahrung_doku/impressionen/images/20241014_075807.jpg]
