petermaerki/puenterswis_heizung_2023_git/erfahrung_doku/betrieb_manuell/readme.md

# Mode Manuell für zwei Tage

Puent und Bochs laufen für zwei Tage auf Manuell.
Sensor TPO ist ganz oben im Speicher, TPM ganz unten.

Oekofen Puffer1
- Daueranforderung Puffertemp min Ein 65C
- Daueranforderung Puffertemp min Aus 65C

Brennerstarts
- Puent 3 pro Tag
- Bochs 2.5 pro Tag

Leistung Wärmezähler ca.
- Puent 9 kW
- Bochs 7 kW

## Diskussion
Alles wie erwartet. Obwohl TPM ganz unten montiert ist, wird nie ein dezentraler Speicher zu kalt, immer über 20% Ladung individuell.

Es braucht dann einige Stunden bis der zentrale Speicher an Ladung zunimmt. In dieser Zeit wird aber immer Energie an die dezentralen Speicher geliefert, deren Ladung sinkt in dieser Zeit nicht. Perfekt.

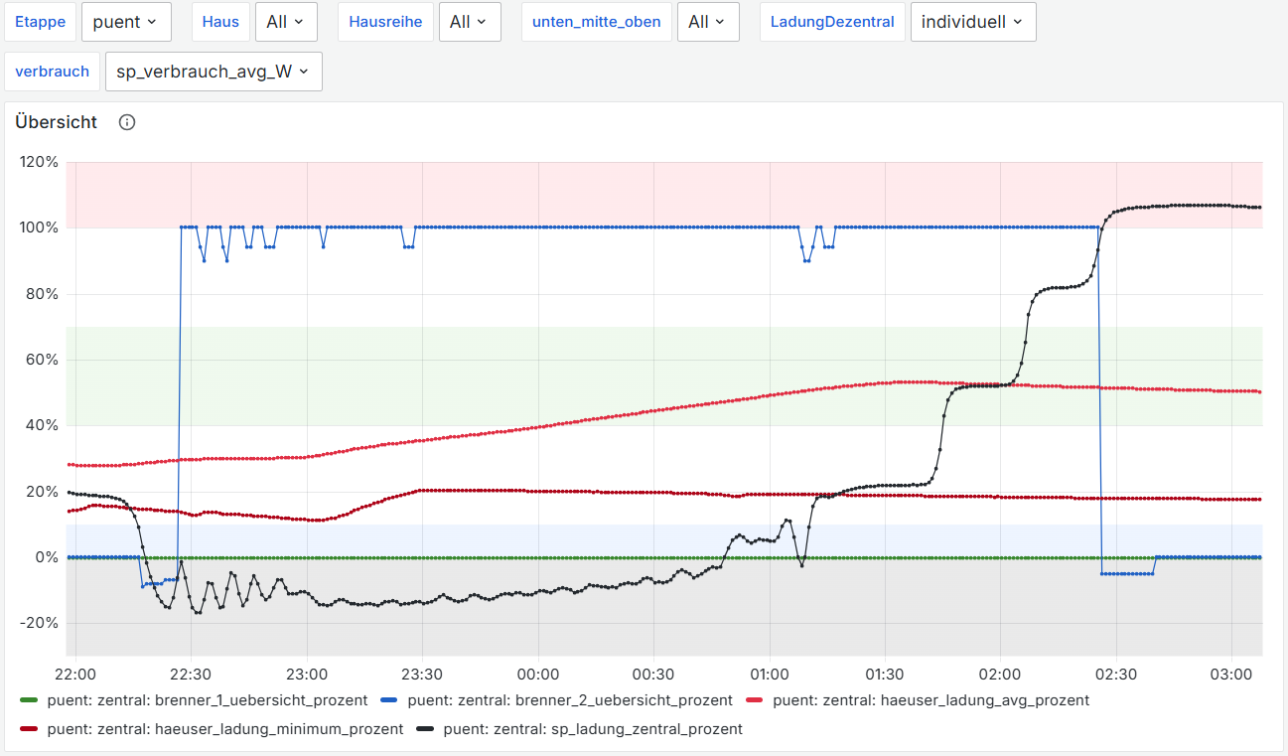
[picture p68: erfahrung_doku/betrieb_manuell/images/puent_zentaler_speicher_leer_uebersicht.png]


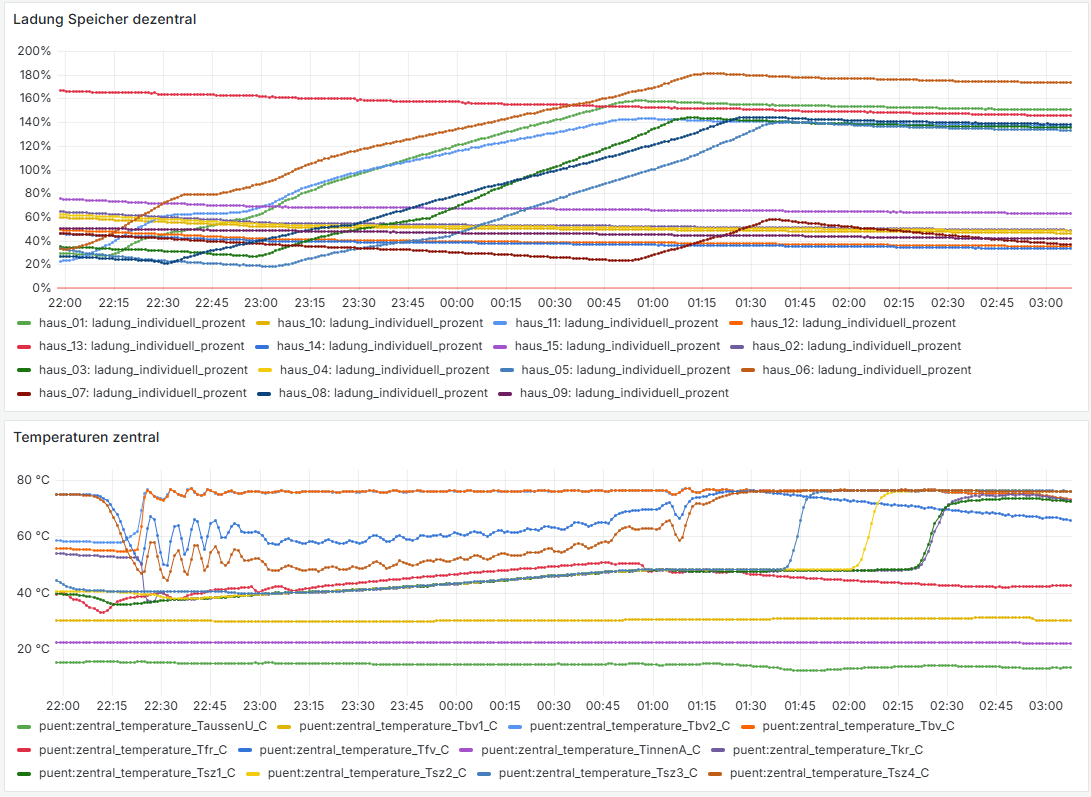
[picture p69: erfahrung_doku/betrieb_manuell/images/puent_dezentral.png]


Link auf Grafana

http://maerki.com:3000/d/da82d5b6-3fd8-4534-80e5-da1155c11310/uebersicht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

Screenshots Grafana

Puent

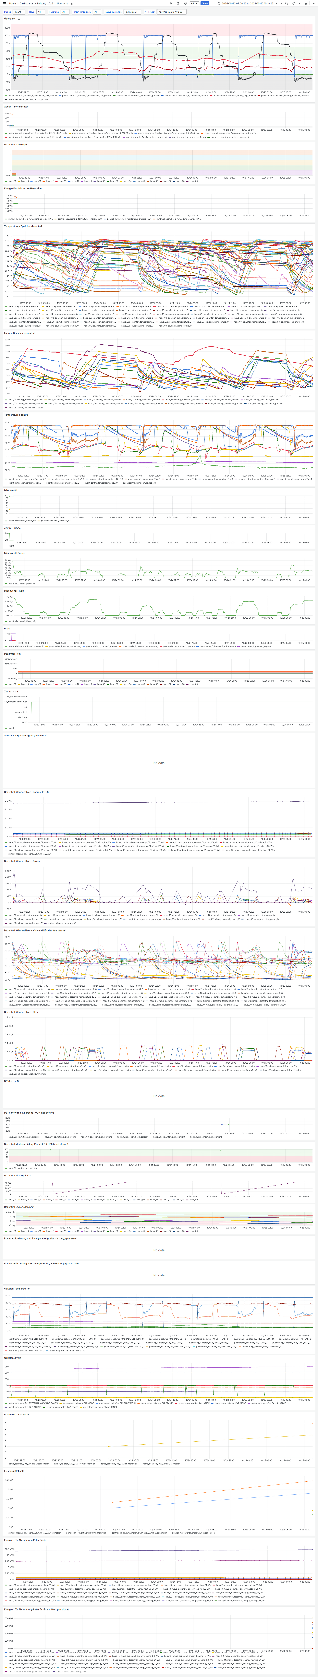
[picture p70: erfahrung_doku/betrieb_manuell/images/puent_manuell_2_tage_20241025.png]


Bochs
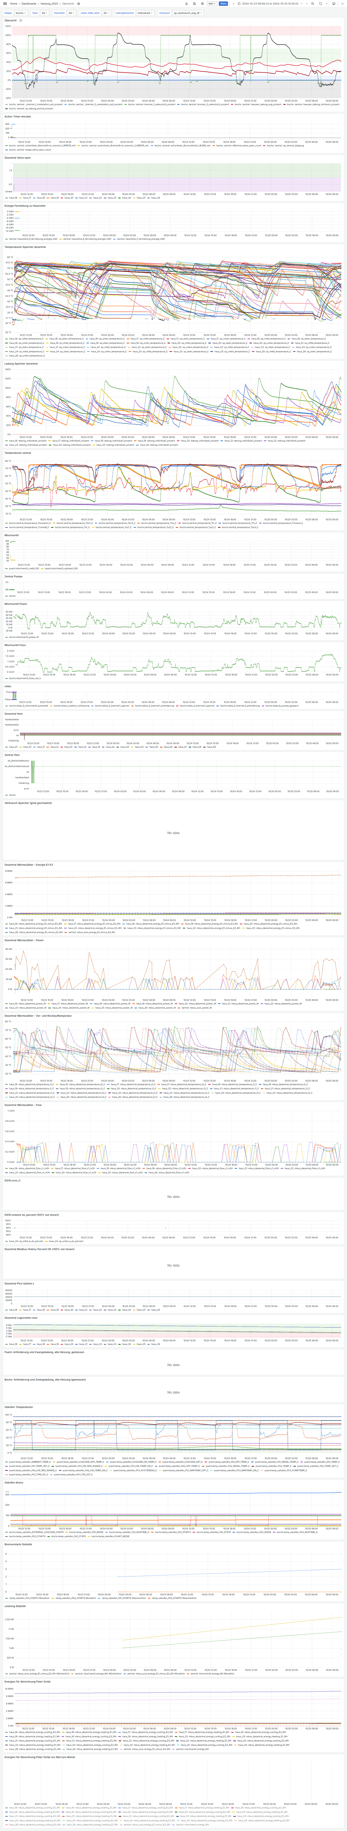
[picture p71: erfahrung_doku/betrieb_manuell/images/bochs_manuell_2_tage_20241025.png]


Die Leistung eines Brenners ist nominal 36 kW (gedrosselt durch Verschliessen von Rohren im Kessel? PESK41 könnte ohne Drosselung 41 kW). Es gibt Zeiten wo der zentrale Speicher längere Zeit leer ist, die Leistung kann dann beim Mischventil abgelesen werden. Hier finde ich Werte von:
- 31 kW
- 33 kW

Passt recht gut.
