petermaerki/puenterswis_heizung_2023_git/hardware_zentral/zentral_hydraulik/pufferspeicher/20240929a_zentral_pufferspeicher.pdf

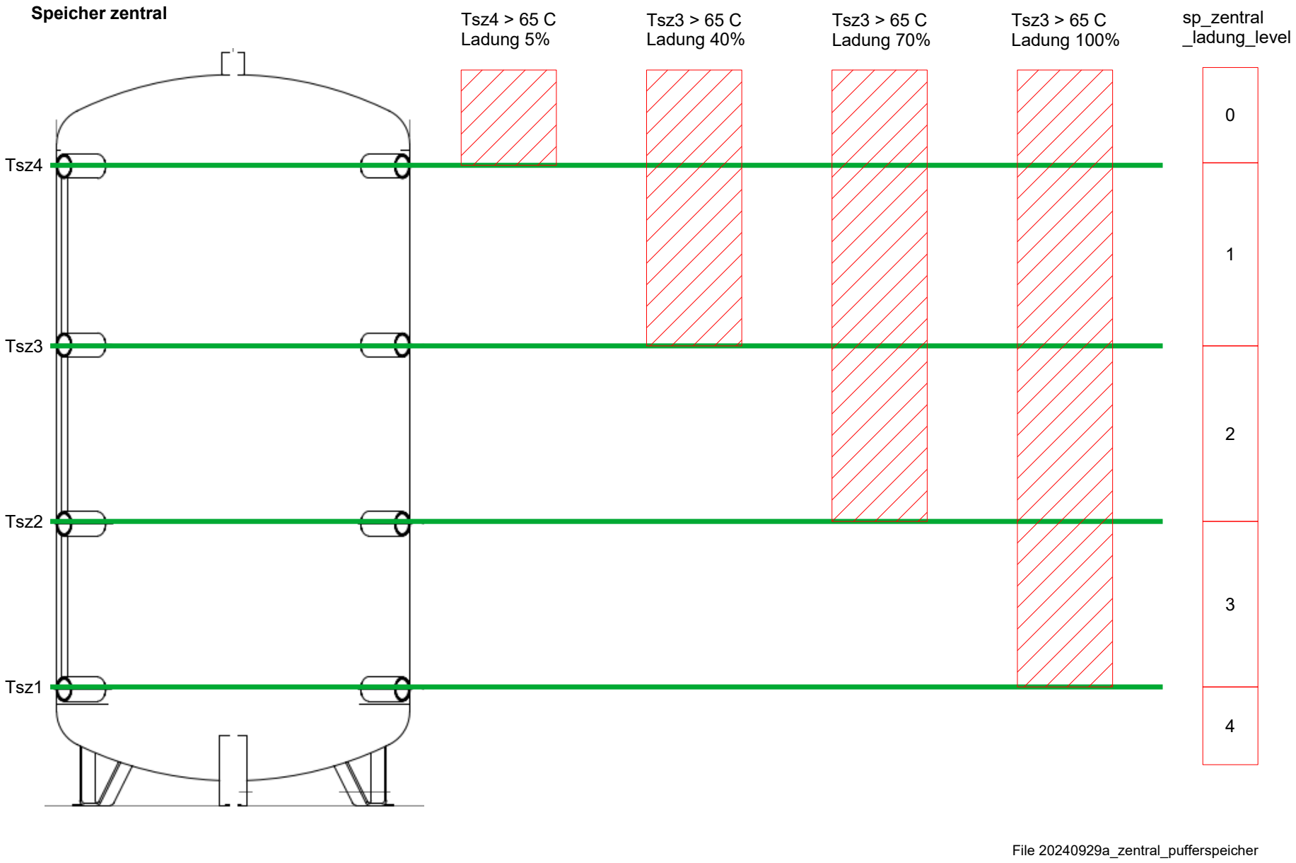
[picture p72: figure]
File 20240929a_zentral_pufferspeicher; Speicher zentral; Tsz4; Tsz3; Tsz2; Tsz1; Tsz4 > 65 C Ladung 5%; Tsz3 > 65 C Ladung 40%; Tsz3 > 65 C Ladung 70%; Tsz3 > 65 C Ladung 100%; sp_zentral _ladung_level
