petermaerki/puenterswis_heizung_2023_git/hardware_zentral/zentral_kabelverteiler/20240910a_wago_durchgangsklemen_beschriftung.ods

Hausreihe | Kabel | Signal | (Ader) |  | Brücke | Haus | Haus | Klemme | puent | bochs
D | R | 485_D+ | 1 | el_bl_ws_blau |  | 1 | 16 | K 1 | DR485_D+_haus_1_el_bl_ws_blau | DR485_D+_haus_16_el_bl_ws_blau
D | R | 485_D- | 2 | el_bl_ws_weiss |  | 1 | 16 | K 2 | DR485_D-_haus_1_el_bl_ws_weiss | DR485_D-_haus_16_el_bl_ws_weiss
D | S | 485_D+ | 3 | el_ge_ws_gelb |  | 2 | 17 | K 3 | DS485_D+_haus_2_el_ge_ws_gelb | DS485_D+_haus_17_el_ge_ws_gelb
D | S | 485_D- | 4 | el_ge_ws_weiss |  | 2 | 17 | K 4 | DS485_D-_haus_2_el_ge_ws_weiss | DS485_D-_haus_17_el_ge_ws_weiss
D | T | 485_D+ | 5 | el_gn_ws_gruen |  | 3 | 18 | K 5 | DT485_D+_haus_3_el_gn_ws_gruen | DT485_D+_haus_18_el_gn_ws_gruen
D | T | 485_D- | 6 | el_gn_ws_weiss |  | 3 | 18 | K 6 | DT485_D-_haus_3_el_gn_ws_weiss | DT485_D-_haus_18_el_gn_ws_weiss
D | U | 485_D+ | 7 | el_bn_ws_braun |  | 4 | 19 | K 7 | DU485_D+_haus_4_el_bn_ws_braun | DU485_D+_haus_19_el_bn_ws_braun
D | U | 485_D- | 8 | el_bn_ws_weiss |  | 4 | 19 | K 8 | DU485_D-_haus_4_el_bn_ws_weiss | DU485_D-_haus_19_el_bn_ws_weiss
E | R | 485_D+ | 1 | el_bl_ws_blau |  | 5 | 20 | K 9 | ER485_D+_haus_5_el_bl_ws_blau | ER485_D+_haus_20_el_bl_ws_blau
E | R | 485_D- | 2 | el_bl_ws_weiss |  | 5 | 20 | K 10 | ER485_D-_haus_5_el_bl_ws_weiss | ER485_D-_haus_20_el_bl_ws_weiss
E | S | 485_D+ | 3 | el_ge_ws_gelb |  | 6 | 21 | K 11 | ES485_D+_haus_6_el_ge_ws_gelb | ES485_D+_haus_21_el_ge_ws_gelb
E | S | 485_D- | 4 | el_ge_ws_weiss |  | 6 | 21 | K 12 | ES485_D-_haus_6_el_ge_ws_weiss | ES485_D-_haus_21_el_ge_ws_weiss
E | T | 485_D+ | 5 | el_gn_ws_gruen |  | 7 | 22 | K 13 | ET485_D+_haus_7_el_gn_ws_gruen | ET485_D+_haus_22_el_gn_ws_gruen
E | T | 485_D- | 6 | el_gn_ws_weiss |  | 7 | 22 | K 14 | ET485_D-_haus_7_el_gn_ws_weiss | ET485_D-_haus_22_el_gn_ws_weiss
E | U | 485_D+ | 7 | el_bn_ws_braun |  | x |  | K 15 | EU485_D+_haus_x_el_bn_ws_braun | EU485_D+_haus_x_el_bn_ws_braun
E | U | 485_D- | 8 | el_bn_ws_weiss |  | x |  | K 16 | EU485_D-_haus_x_el_bn_ws_weiss | EU485_D-_haus_x_el_bn_ws_weiss
F | R | 485_D+ | 1 | el_bl_ws_blau |  | 8 | 23 | K 17 | FR485_D+_haus_8_el_bl_ws_blau | FR485_D+_haus_23_el_bl_ws_blau
F | R | 485_D- | 2 | el_bl_ws_weiss |  | 8 | 23 | K 18 | FR485_D-_haus_8_el_bl_ws_weiss | FR485_D-_haus_23_el_bl_ws_weiss
F | S | 485_D+ | 3 | el_ge_ws_gelb |  | 9 | 24 | K 19 | FS485_D+_haus_9_el_ge_ws_gelb | FS485_D+_haus_24_el_ge_ws_gelb
F | S | 485_D- | 4 | el_ge_ws_weiss |  | 9 | 24 | K 20 | FS485_D-_haus_9_el_ge_ws_weiss | FS485_D-_haus_24_el_ge_ws_weiss
F | T | 485_D+ | 5 | el_gn_ws_gruen |  | 10 | 25 | K 21 | FT485_D+_haus_10_el_gn_ws_gruen | FT485_D+_haus_25_el_gn_ws_gruen
F | T | 485_D- | 6 | el_gn_ws_weiss |  | 10 | 25 | K 22 | FT485_D-_haus_10_el_gn_ws_weiss | FT485_D-_haus_25_el_gn_ws_weiss
F | U | 485_D+ | 7 | el_bn_ws_braun |  | 11 | 26 | K 23 | FU485_D+_haus_11_el_bn_ws_braun | FU485_D+_haus_26_el_bn_ws_braun
F | U | 485_D- | 8 | el_bn_ws_weiss |  | 11 | 26 | K 24 | FU485_D-_haus_11_el_bn_ws_weiss | FU485_D-_haus_26_el_bn_ws_weiss
G | R | 485_D+ | 1 | el_bl_ws_blau |  | 12 |  | K 25 | GR485_D+_haus_12_el_bl_ws_blau | nicht belegt
G | R | 485_D- | 2 | el_bl_ws_weiss |  | 12 |  | K 26 | GR485_D-_haus_12_el_bl_ws_weiss | nicht belegt
G | S | 485_D+ | 3 | el_ge_ws_gelb |  | 13 |  | K 27 | GS485_D+_haus_13_el_ge_ws_gelb | nicht belegt
G | S | 485_D- | 4 | el_ge_ws_weiss |  | 13 |  | K 28 | GS485_D-_haus_13_el_ge_ws_weiss | nicht belegt
G | T | 485_D+ | 5 | el_gn_ws_gruen |  | 14 |  | K 29 | GT485_D+_haus_14_el_gn_ws_gruen | nicht belegt
G | T | 485_D- | 6 | el_gn_ws_weiss |  | 14 |  | K 30 | GT485_D-_haus_14_el_gn_ws_weiss | nicht belegt
G | U | 485_D+ | 7 | el_bn_ws_braun |  | 15 |  | K 31 | GU485_D+_haus_15_el_bn_ws_braun | nicht belegt
G | U | 485_D- | 8 | el_bn_ws_weiss |  | 15 |  | K 32 | GU485_D-_haus_15_el_bn_ws_weiss | nicht belegt
 |  |  |  |  |  |  |  | K 33 | D485_0V reserve | D485_0V reserve
 |  |  |  |  |  |  |  | K 34 | D485_0V reserve | D485_0V reserve
D |  | 485_0V | 10 | el_gr_ws_weiss | 8 | x | x | K 35 | D485_0V_haus_x_el_gr_ws_weiss | D485_0V_haus_x_el_gr_ws_weiss
D |  | 485_0V | 12 | el_blws_ws_weiss | 8 | x | x | K 36 | D485_0V_haus_x_el_blws_ws_weiss | D485_0V_haus_x_el_blws_ws_weiss
E |  | 485_0V | 10 | el_gr_ws_weiss | 8 | x | x | K 37 | E485_0V_haus_x_el_gr_ws_weiss | E485_0V_haus_x_el_gr_ws_weiss
E |  | 485_0V | 12 | el_blws_ws_weiss | 8 | x | x | K 38 | E485_0V_haus_x_el_blws_ws_weiss | E485_0V_haus_x_el_blws_ws_weiss
F |  | 485_0V | 10 | el_gr_ws_weiss | 8 | x | x | K 39 | F485_0V_haus_x_el_gr_ws_weiss | F485_0V_haus_x_el_gr_ws_weiss
F |  | 485_0V | 12 | el_blws_ws_weiss | 8 | x | x | K 40 | F485_0V_haus_x_el_blws_ws_weiss | F485_0V_haus_x_el_blws_ws_weiss
G |  | 485_0V | 10 | el_gr_ws_weiss | 8 | x |  | K 41 | G485_0V_haus_x_el_gr_ws_weiss | nicht belegt 0V
G |  | 485_0V | 12 | el_blws_ws_weiss | 8 | x |  | K 42 | G485_0V_haus_x_el_blws_ws_weiss | nicht belegt 0V
D |  | 486_24V | 11 | el_blws_ws_blauws |  | x | x | K 43 | D486_24V_haus_x_el_blws_ws_blauws | D486_24V_haus_x_el_blws_ws_blauws
E |  | 486_24V | 11 | el_blws_ws_blauws |  | x | x | K 44 | E486_24V_haus_x_el_blws_ws_blauws | E486_24V_haus_x_el_blws_ws_blauws
F |  | 486_24V | 11 | el_blws_ws_blauws |  | x | x | K 45 | F486_24V_haus_x_el_blws_ws_blauws | F486_24V_haus_x_el_blws_ws_blauws
G |  | 486_24V | 11 | el_blws_ws_blauws |  | x |  | K 46 | G486_24V_haus_x_el_blws_ws_blauws | nicht belegt
D |  | automatik | 9 | el_gr_ws_grau | 4 | x | x | K 47 | Dautomatik_haus_x_el_gr_ws_grau | Dautomatik_haus_x_el_gr_ws_grau
E |  | automatik | 9 | el_gr_ws_grau | 4 | x | x | K 48 | Eautomatik_haus_x_el_gr_ws_grau | Eautomatik_haus_x_el_gr_ws_grau
F |  | automatik | 9 | el_gr_ws_grau | 4 | x | x | K 49 | Fautomatik_haus_x_el_gr_ws_grau | Fautomatik_haus_x_el_gr_ws_grau
G |  | automatik | 9 | el_gr_ws_grau | 4 | x |  | K 50 | Gautomatik_haus_x_el_gr_ws_grau | nicht belegt
