petermaerki/puenterswis_heizung_2023_git/hardware_zentral/zentral_temperatursensoren/20240825a_beschriftung_temperatursensoren_zentral.ods

Tsz1 Tempertursensor DS18B20 | Tsz1 Tempertursensor DS18B20 | Tsz1 Tempertursensor DS18B20 | Tsz1 Tempertursensor DS18B20 | Tsz1 Tempertursensor DS18B20 | Tsz1 Tempertursensor DS18B20
Tsz2 Tempertursensor DS18B20 | Tsz2 Tempertursensor DS18B20 | Tsz2 Tempertursensor DS18B20 | Tsz2 Tempertursensor DS18B20 | Tsz2 Tempertursensor DS18B20 | Tsz2 Tempertursensor DS18B20
Tsz3 Tempertursensor DS18B20 | Tsz3 Tempertursensor DS18B20 | Tsz3 Tempertursensor DS18B20 | Tsz3 Tempertursensor DS18B20 | Tsz3 Tempertursensor DS18B20 | Tsz3 Tempertursensor DS18B20
Tsz4 Tempertursensor DS18B20 | Tsz4 Tempertursensor DS18B20 | Tsz4 Tempertursensor DS18B20 | Tsz4 Tempertursensor DS18B20 | Tsz4 Tempertursensor DS18B20 | Tsz4 Tempertursensor DS18B20
Tfv Tempertursensor DS18B20 | Tfv Tempertursensor DS18B20 | Tfv Tempertursensor DS18B20 | Tfv Tempertursensor DS18B20 | Tfv Tempertursensor DS18B20 | Tfv Tempertursensor DS18B20
Tfr Tempertursensor DS18B20 | Tfr Tempertursensor DS18B20 | Tfr Tempertursensor DS18B20 | Tfr Tempertursensor DS18B20 | Tfr Tempertursensor DS18B20 | Tfr Tempertursensor DS18B20
TaussenE Tempertursensor DS18B20 | TaussenE Tempertursensor DS18B20 | TaussenE Tempertursensor DS18B20 | TaussenE Tempertursensor DS18B20 | TaussenE Tempertursensor DS18B20 | TaussenE Tempertursensor DS18B20
TaussenU Tempertursensor DS18B20 | TaussenU Tempertursensor DS18B20 | TaussenU Tempertursensor DS18B20 | TaussenU Tempertursensor DS18B20 | TaussenU Tempertursensor DS18B20 | TaussenU Tempertursensor DS18B20
TinnenA Tempertursensor DS18B20 | TinnenA Tempertursensor DS18B20 | TinnenA Tempertursensor DS18B20 | TinnenA Tempertursensor DS18B20 | TinnenA Tempertursensor DS18B20 | TinnenA Tempertursensor DS18B20
TinnenB Tempertursensor DS18B20 | TinnenB Tempertursensor DS18B20 | TinnenB Tempertursensor DS18B20 | TinnenB Tempertursensor DS18B20 | TinnenB Tempertursensor DS18B20 | TinnenB Tempertursensor DS18B20
Tkr Tempertursensor DS18B20 | Tkr Tempertursensor DS18B20 | Tkr Tempertursensor DS18B20 | Tkr Tempertursensor DS18B20 | Tkr Tempertursensor DS18B20 | Tkr Tempertursensor DS18B20
Tbv1 Tempertursensor DS18B20 | Tbv1 Tempertursensor DS18B20 | Tbv1 Tempertursensor DS18B20 | Tbv1 Tempertursensor DS18B20 | Tbv1 Tempertursensor DS18B20 | Tbv1 Tempertursensor DS18B20
Tbv2 Tempertursensor DS18B20 | Tbv2 Tempertursensor DS18B20 | Tbv2 Tempertursensor DS18B20 | Tbv2 Tempertursensor DS18B20 | Tbv2 Tempertursensor DS18B20 | Tbv2 Tempertursensor DS18B20
Tbv Tempertursensor DS18B20 | Tbv Tempertursensor DS18B20 | Tbv Tempertursensor DS18B20 | Tbv Tempertursensor DS18B20 | Tbv Tempertursensor DS18B20 | Tbv Tempertursensor DS18B20
