petermaerki/puenterswis_heizung_2023_git/hardware_zentral/belimo_waermezaehler_mischer/20240414a_reaktionszeit_temperatur_abschaetzung.ods

Beispiel | nur ein Haus |  |  | 150 | l/h
 |  |  |  | 0.15 | m^3/h
 |  |  |  | 4.17E-5 | m^3/s
 | Rohrdurchmesser |  |  | 0.025 | m
 |  |  | Querschnitt | 4.91E-4 | m^2
 | Fliessgeschwindigkeit |  |  | 8.49E-2 | m/s
 | Distanz Kugelventil zu Tauchhülse |  |  | 0.1 | m
 |  | Totzeit |  | 0.85 | s
Laufzeit vom Moto vom Kugelventil
 |  |  | Winkel | 90 | °
 |  |  | Laufzeit | 90 | s
Reaktionszeit Tauchhülse mit Wärmeleitpaste |  |  |  | 10 | s
 | Zeitkonstante Temperaturfühler |  |  | 4 | s
