petermaerki/puenterswis_heizung_2023_git/hardware_dezentral/dezentral_beschriftung/20240225a_beschriftung_steuerung_dezentral_kleber_adressen.ods

Pünterswis | Haus | 1 | Waffenplatztrasse 14
Pünterswis | Haus | 2 | Waffenplatztrasse 16
Pünterswis | Haus | 3 | Waffenplatztrasse 18
Pünterswis | Haus | 4 | Waffenplatztrasse 20
Pünterswis | Haus | 5 | Waffenplatztrasse 22
Pünterswis | Haus | 6 | Waffenplatztrasse 24
Pünterswis | Haus | 7 | Waffenplatztrasse 26
Pünterswis | Haus | 8 | Zelglistrasse 40
Pünterswis | Haus | 9 | Zelglistrasse 42
Pünterswis | Haus | 10 | Zelglistrasse 44
Pünterswis | Haus | 11 | Zelglistrasse 46
Pünterswis | Haus | 12 | Zelglistrasse 47
Pünterswis | Haus | 13 | Zelglistrasse 49
Pünterswis | Haus | 14 | Zelglistrasse 51
Pünterswis | Haus | 15 | Zelglistrasse 53
Bochslen | Haus | 16 | Zelglistrasse 32
Bochslen | Haus | 17 | Zelglistrasse 34
Bochslen | Haus | 18 | Zelglistrasse 36
Bochslen | Haus | 19 | Zelglistrasse 38
Bochslen | Haus | 20 | Zelglistrasse 33
Bochslen | Haus | 21 | Zelglistrasse 35
Bochslen | Haus | 22 | Zelglistrasse 37
Bochslen | Haus | 23 | Zelglistrasse 39
Bochslen | Haus | 24 | Zelglistrasse 41
Bochslen | Haus | 25 | Zelglistrasse 43
Bochslen | Haus | 26 | Zelglistrasse 45
