petermaerki/puenterswis_heizung_2023_git/hardware_zentral/oekofen/verbrennung_nicht_sauber/20241015a_schlechte_verbrennung_versuche_modulation.ods

 | Die Brenner sind jetzt einige Wochen auf meistens 30% gelaufen. Kamin Schwarz, Ofentürchen Schwarz, Asche Braun Schwarz, krümelig. Lässt sich mit den Fingern fein zerreiben.
 | Kamintürchen: feiner, schwarzer Belag.
 | Stinkt beim Öffnen der Ofentüre.
2024-10-15
 |  | Puent | MIN | % | 60 | Bochs | MIN | % | 45
 |  | Asche im Brenner unten etwas weg gedrückt. |  |  |  | Asche im Brenner unten etwas weg gedrückt.
 |  | PE1 Kamin Türchen gewaschen
 |  | ging nicht mit modulieren, zuwarten
