petermaerki/puenterswis_heizung_2023_git/hardware_zentral/belimo_waermezaehler_mischer/totzeit/20240915a_messung_totzeit.ods

Sheet: Diskussion
Vor der Pumpe ist es nicht wesentlich schneller. Entscheid: Nach der Pumpe belassen.

Sheet: Tfv Tauchhuelse
s | s | stellwert 100 | Tfv_C
16085.8
16085.8 | 0 | 60 | 43.1
16088.6 | 2.80000000000109 | 60 | 42
16091.4 | 5.60000000000036 | 60 | 41.4
16094.2 | 8.40000000000146 | 60 | 40.5
16097 | 11.2000000000007 | 60 | 40.1
16099.8 | 14 | 60 | 40.1
16102.5 | 16.7000000000007 | 60 | 40.1
16105.3 | 19.5 | 60 | 40.1
16108.1 | 22.3000000000011 | 60 | 40.8
16110.9 | 25.1000000000004 | 60 | 41.2
16113.7 | 27.9000000000015 | 60 | 41.4
16116.4 | 30.6000000000004 | 60 | 41.8
16119.2 | 33.4000000000015 | 60 | 42
16122 | 36.2000000000007 | 60 | 42.2
16124.7 | 38.9000000000015 | 60 | 42.5
16127.5 | 41.7000000000007 | 60 | 42.7
16130.3 | 44.5 | 60 | 43.1
16133.1 | 47.3000000000011 | 60 | 43.6
16135.9 | 50.1000000000004 | 60 | 43.8
16138.6 | 52.8000000000011 | 60 | 44.2
16141.4 | 55.6000000000004 | 60 | 44.7
16144.2 | 58.4000000000015 | 60 | 44.9
16147 | 61.2000000000007 | 60 | 45.2
16149.7 | 63.9000000000015 | 60 | 45.4
16152.5 | 66.7000000000007 | 60 | 45.7
16155.3 | 69.5 | 60 | 45.9
16158.1 | 72.3000000000011 | 60 | 46.1
16160.9 | 75.1000000000004 | 60 | 46.3
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
