petermaerki/puenterswis_heizung_2023_git/hardware_dezentral/haeuser_spezial/13/20240707a_verluste_fernleitung_einspeisung.ods

Verlustleistung Fernleitung bei Einspeisung Solarwärme von Haus 13
Ganz grobe Abschätzung
 | Leitung | DN25
 | Wasser | 70 | C
 | Luft | 20 | C
 | Delta | 50 | C
 |  | 10.4 | W/m | 20230526_Rohrisolierung berechnen mit Wärmestrom und Temperaturverlauf.pdf
 | Rohrlänge Haus 1 zu Haus 13 |  |  | 200 | m | Daumenpeil
 | Verlust |  |  | 2080 | W
Leistung Solaranlage
 | Fläche |  | 8.5 | m²
 | Einstrahlung max |  | 1000 | W/m2
 | Wirkungsgrad |  | 0.75 |  | Daumenpeil
 |  |  | 6375 | W
Leistungsabgabe Beispiel
 | Haus 13 unten |  | 75 | C
 | Haus 13 Fernleitung |  | 55 | C
 | Fluss |  | 0.18 | m3/h
 |  |  | 0.00005 | m3/s
 |  |  | 0.05 | l/s
 | Wärmekap Wasser |  | 4190 | J / kg / K
 | Abgegebene Leistung |  | 4190 | W
 |  |  | Fluss ist eher zu klein. Drossel voll öffnen?
Sommer Wärmeverbrauch Beispiel
 | Anhand Abschätzung 20240707 Mittelwert |  |  | W
 |  |  | Haus | Verbrauch
 |  |  |  | W
 |  |  | 1 | 281
 |  |  | 2 | 433
 |  |  | 3 | 540
 |  |  | 4 | 323
 |  |  | 5 | 467
 |  |  | 6 | 305
 |  |  | 7 | 621
 |  |  | 8 | 780
 |  |  | 9 | 352
 |  |  | 10 | 418
 |  |  | 11 | 499
 |  |  | 12 | 476
 |  |  | 13 | 0
 |  |  | 14 | 406
 |  |  | 15 | 280
 | puent |  | Total | 6181 | W
