petermaerki/puenterswis_heizung_2023_git/hardware_dezentral/haeuser_spezial/18/20240418_pulsieren.ods

Verbrauch pulsiert. Was könnte das sein?
 |  | Start | 2024-04-17 22:36:00 |  | Delta
Peaks |  | Periode | 00:31:00
 | Delta |  | Faktor
2024-04-17 22:36:00 |  |  | 0 | 2024-04-17 22:36:00 | 00:00:00
2024-04-17 23:11:00 | 00:35:00 |  | 1 | 2024-04-17 23:07:00 | -00:04:00
2024-04-17 23:45:00 | 00:34:00 |  | 2 | 2024-04-17 23:38:00 | -00:07:00
2024-04-18 00:15:00 | 00:30:00 |  | 3 | 2024-04-18 00:09:00 | -00:06:00
2024-04-18 00:46:00 | 00:31:00 |  | 4 | 2024-04-18 00:40:00 | -00:06:00
2024-04-18 01:12:00 | 00:26:00 |  | 5 | 2024-04-18 01:11:00 | -00:01:00
2024-04-18 01:40:00 | 00:28:00 |  | 6 | 2024-04-18 01:42:00 | 00:02:00
2024-04-18 02:06:00 | 00:26:00 |  | 7 | 2024-04-18 02:13:00 | 00:07:00
2024-04-18 02:35:00 | 00:29:00 |  | 8 | 2024-04-18 02:44:00 | 00:09:00
2024-04-18 03:02:00 | 00:27:00 |  | 9 | 2024-04-18 03:15:00 | 00:13:00
2024-04-18 03:31:00 | 00:29:00 |  | 10 | 2024-04-18 03:46:00 | 00:15:00
2024-04-18 03:53:00 | 00:22:00 |  | 11 | 2024-04-18 04:17:00 | 00:24:00
2024-04-18 05:47:00 | 01:54:00 |  | 14 | 2024-04-18 05:50:00 | 00:03:00
2024-04-18 06:39:00 | 00:52:00 |  | 16 | 2024-04-18 06:52:00 | 00:13:00
2024-04-18 07:06:00 | 00:27:00 |  | 17 | 2024-04-18 07:23:00 | 00:17:00
2024-04-18 07:40:00 | 00:34:00 |  | 18 | 2024-04-18 07:54:00 | 00:14:00
2024-04-18 09:10:00 | 01:30:00 |  | 21 | 2024-04-18 09:27:00 | 00:17:00
 | -1089609:10:00
 | 00:00:00
 | 00:00:00
 |  | Mir scheint das ist nicht perfekt periodisch.
