petermaerki/puenterswis_heizung_2023_git/hardware_dezentral/dezentral_beschriftung/netzstecker/20240329a_beschriftung_netzstecker.ods

Nicht ausstecken! Bitte diesen Netzstecker nicht ausstecken, auch nicht während der Ferien. Für Service-Arbeiten, kürzer als eine Stunde, ist ein Unterbruch kein Problem. 2024 Peter Märki | Nicht ausstecken! Bitte diesen Netzstecker nicht ausstecken, auch nicht während der Ferien. Für Service-Arbeiten, kürzer als eine Stunde, ist ein Unterbruch kein Problem. 2024 Peter Märki | Nicht ausstecken! Bitte diesen Netzstecker nicht ausstecken, auch nicht während der Ferien. Für Service-Arbeiten, kürzer als eine Stunde, ist ein Unterbruch kein Problem. 2024 Peter Märki
Nicht ausstecken! Bitte diesen Netzstecker nicht ausstecken, auch nicht während der Ferien. Für Service-Arbeiten, kürzer als eine Stunde, ist ein Unterbruch kein Problem. 2024 Peter Märki | Nicht ausstecken! Bitte diesen Netzstecker nicht ausstecken, auch nicht während der Ferien. Für Service-Arbeiten, kürzer als eine Stunde, ist ein Unterbruch kein Problem. 2024 Peter Märki | Nicht ausstecken! Bitte diesen Netzstecker nicht ausstecken, auch nicht während der Ferien. Für Service-Arbeiten, kürzer als eine Stunde, ist ein Unterbruch kein Problem. 2024 Peter Märki
Nicht ausstecken! Bitte diesen Netzstecker nicht ausstecken, auch nicht während der Ferien. Für Service-Arbeiten, kürzer als eine Stunde, ist ein Unterbruch kein Problem. 2024 Peter Märki | Nicht ausstecken! Bitte diesen Netzstecker nicht ausstecken, auch nicht während der Ferien. Für Service-Arbeiten, kürzer als eine Stunde, ist ein Unterbruch kein Problem. 2024 Peter Märki | Nicht ausstecken! Bitte diesen Netzstecker nicht ausstecken, auch nicht während der Ferien. Für Service-Arbeiten, kürzer als eine Stunde, ist ein Unterbruch kein Problem. 2024 Peter Märki
Nicht ausstecken! Bitte diesen Netzstecker nicht ausstecken, auch nicht während der Ferien. Für Service-Arbeiten, kürzer als eine Stunde, ist ein Unterbruch kein Problem. 2024 Peter Märki | Nicht ausstecken! Bitte diesen Netzstecker nicht ausstecken, auch nicht während der Ferien. Für Service-Arbeiten, kürzer als eine Stunde, ist ein Unterbruch kein Problem. 2024 Peter Märki | Nicht ausstecken! Bitte diesen Netzstecker nicht ausstecken, auch nicht während der Ferien. Für Service-Arbeiten, kürzer als eine Stunde, ist ein Unterbruch kein Problem. 2024 Peter Märki
Nicht ausstecken! Bitte diesen Netzstecker nicht ausstecken, auch nicht während der Ferien. Für Service-Arbeiten, kürzer als eine Stunde, ist ein Unterbruch kein Problem. 2024 Peter Märki | Nicht ausstecken! Bitte diesen Netzstecker nicht ausstecken, auch nicht während der Ferien. Für Service-Arbeiten, kürzer als eine Stunde, ist ein Unterbruch kein Problem. 2024 Peter Märki | Nicht ausstecken! Bitte diesen Netzstecker nicht ausstecken, auch nicht während der Ferien. Für Service-Arbeiten, kürzer als eine Stunde, ist ein Unterbruch kein Problem. 2024 Peter Märki
