petermaerki/puenterswis_heizung_2023_git/hardware_zentral/zentral_steuerung/modbus/20240210a_modbus_adressen.ods

Modbus Adressen |  |  |  |  | ON | 0 1
Siedlung | Adresse |  | Hausreihe | Modbus | Modbus Bin
puent | Waffenplatzstr. | 14 | D | 101 | 01100101 | 1
puent | Waffenplatzstr. | 16 | D | 102 | 01100110 | 2
puent | Waffenplatzstr. | 18 | D | 103 | 01100111 | 3
puent | Waffenplatzstr. | 20 | D | 104 | 01101000 | 4
puent | Waffenplatzstr. | 22 | E | 105 | 01101001 | 5
puent | Waffenplatzstr. | 24 | E | 106 | 01101010 | 6
puent | Waffenplatzstr. | 26 | E | 107 | 01101011 | 7
puent | Zelglistrasse | 40 | F | 108 | 01101100 | 8
puent | Zelglistrasse | 42 | F | 109 | 01101101 | 9
puent | Zelglistrasse | 44 | F | 110 | 01101110 | 10
puent | Zelglistrasse | 46 | F | 111 | 01101111 | 11
puent | Zelglistrasse | 47 | G | 112 | 01110000 | 12
puent | Zelglistrasse | 49 | G | 113 | 01110001 | 13
puent | Zelglistrasse | 51 | G | 114 | 01110010 | 14
puent | Zelglistrasse | 53 | G | 115 | 01110011 | 15
bochs | Zelglistrasse | 32 | D | 116 | 01110100 | 16
bochs | Zelglistrasse | 34 | D | 117 | 01110101 | 17
bochs | Zelglistrasse | 36 | D | 118 | 01110110 | 18
bochs | Zelglistrasse | 38 | D | 119 | 01110111 | 19
bochs | Zelglistrasse | 33 | E | 120 | 01111000 | 20
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
