petermaerki/puenterswis_heizung_2023_git/hardware_dezentral/temperature_sensor/konfektion/20231229a_beschriftung_temperatursensoren.ods

DS_2 Tempertursensor DS18B20 | DS_3 Tempertursensor DS18B20 | DS_4 Tempertursensor DS18B20 | DS_5 Tempertursensor DS18B20 | DS_6 Tempertursensor DS18B20 | DS_7 Tempertursensor DS18B20
DS_2 Tempertursensor DS18B20 | DS_3 Tempertursensor DS18B20 | DS_4 Tempertursensor DS18B20 | DS_5 Tempertursensor DS18B20 | DS_6 Tempertursensor DS18B20 | DS_7 Tempertursensor DS18B20
DS_2 Tempertursensor DS18B20 | DS_3 Tempertursensor DS18B20 | DS_4 Tempertursensor DS18B20 | DS_5 Tempertursensor DS18B20 | DS_6 Tempertursensor DS18B20 | DS_7 Tempertursensor DS18B20
DS_2 Tempertursensor DS18B20 | DS_3 Tempertursensor DS18B20 | DS_4 Tempertursensor DS18B20 | DS_5 Tempertursensor DS18B20 | DS_6 Tempertursensor DS18B20 | DS_7 Tempertursensor DS18B20
DS_2 Tempertursensor DS18B20 | DS_3 Tempertursensor DS18B20 | DS_4 Tempertursensor DS18B20 | DS_5 Tempertursensor DS18B20 | DS_6 Tempertursensor DS18B20 | DS_7 Tempertursensor DS18B20
DS_2 Tempertursensor DS18B20 | DS_3 Tempertursensor DS18B20 | DS_4 Tempertursensor DS18B20 | DS_5 Tempertursensor DS18B20 | DS_6 Tempertursensor DS18B20 | DS_7 Tempertursensor DS18B20
DS_2 Tempertursensor DS18B20 | DS_3 Tempertursensor DS18B20 | DS_4 Tempertursensor DS18B20 | DS_5 Tempertursensor DS18B20 | DS_6 Tempertursensor DS18B20 | DS_7 Tempertursensor DS18B20
DS_2 Tempertursensor DS18B20 | DS_3 Tempertursensor DS18B20 | DS_4 Tempertursensor DS18B20 | DS_5 Tempertursensor DS18B20 | DS_6 Tempertursensor DS18B20 | DS_7 Tempertursensor DS18B20
DS_2 Tempertursensor DS18B20 | DS_3 Tempertursensor DS18B20 | DS_4 Tempertursensor DS18B20 | DS_5 Tempertursensor DS18B20 | DS_6 Tempertursensor DS18B20 | DS_7 Tempertursensor DS18B20
DS_2 Tempertursensor DS18B20 | DS_3 Tempertursensor DS18B20 | DS_4 Tempertursensor DS18B20 | DS_5 Tempertursensor DS18B20 | DS_6 Tempertursensor DS18B20 | DS_7 Tempertursensor DS18B20
DS_2 Tempertursensor DS18B20 | DS_3 Tempertursensor DS18B20 | DS_4 Tempertursensor DS18B20 | DS_5 Tempertursensor DS18B20 | DS_6 Tempertursensor DS18B20 | DS_7 Tempertursensor DS18B20
DS_2 Tempertursensor DS18B20 | DS_3 Tempertursensor DS18B20 | DS_4 Tempertursensor DS18B20 | DS_5 Tempertursensor DS18B20 | DS_6 Tempertursensor DS18B20 | DS_7 Tempertursensor DS18B20
DS_2 Tempertursensor DS18B20 | DS_3 Tempertursensor DS18B20 | DS_4 Tempertursensor DS18B20 | DS_5 Tempertursensor DS18B20 | DS_6 Tempertursensor DS18B20 | DS_7 Tempertursensor DS18B20
DS_2 Tempertursensor DS18B20 | DS_3 Tempertursensor DS18B20 | DS_4 Tempertursensor DS18B20 | DS_5 Tempertursensor DS18B20 | DS_6 Tempertursensor DS18B20 | DS_7 Tempertursensor DS18B20
DS_2 Tempertursensor DS18B20 | DS_3 Tempertursensor DS18B20 | DS_4 Tempertursensor DS18B20 | DS_5 Tempertursensor DS18B20 | DS_6 Tempertursensor DS18B20 | DS_7 Tempertursensor DS18B20
DS_2 Tempertursensor DS18B20 | DS_3 Tempertursensor DS18B20 | DS_4 Tempertursensor DS18B20 | DS_5 Tempertursensor DS18B20 | DS_6 Tempertursensor DS18B20 | DS_7 Tempertursensor DS18B20
