petermaerki/puenterswis_heizung_2023_git/hardware_dezentral/haeuser_spezial/18/20240419_periode_variabel.png

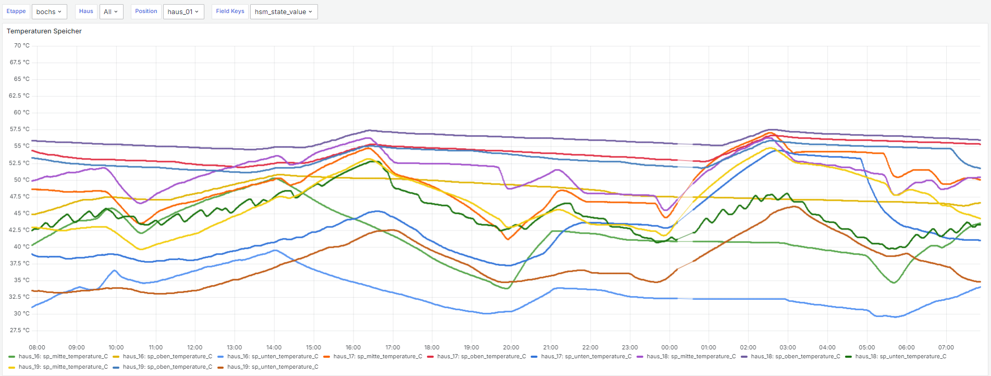
hardware_dezentral/haeuser_spezial/18/20240419_periode_variabel.png
