petermaerki/puenterswis_heizung_2023_git/hardware_dezentral/pcb_kicad/production_v1.0/doku/pcb_dezentral_layout_v1.0.png

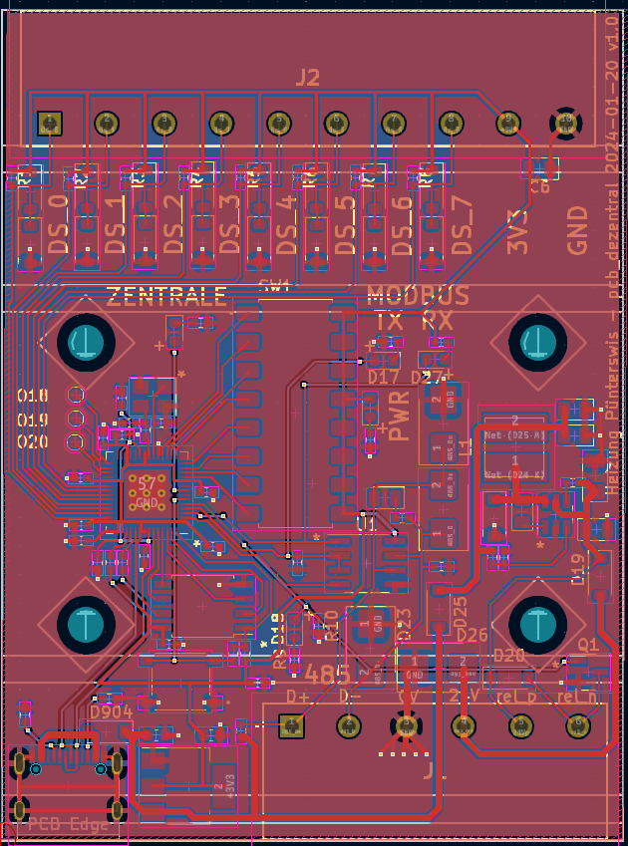
hardware_dezentral/pcb_kicad/production_v1.0/doku/pcb_dezentral_layout_v1.0.png
