petermaerki/puenterswis_heizung_2023_git/hardware_zentral/belimo_waermezaehler_mischer/20240310b_modbus_signals_example_ok.jpg

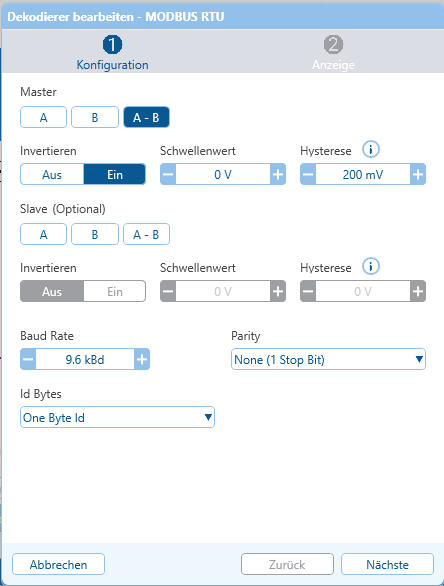
hardware_zentral/belimo_waermezaehler_mischer/20240310b_modbus_signals_example_ok.jpg
