petermaerki/puenterswis_heizung_2023_git/hardware_zentral/belimo_waermezaehler_mischer/20240705_inbetriebnahme_neue/sw version bochs neu cloud produkteinfo.png

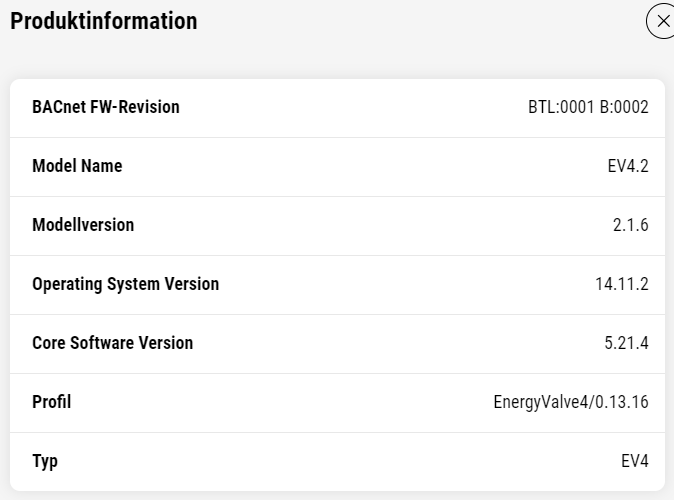
hardware_zentral/belimo_waermezaehler_mischer/20240705_inbetriebnahme_neue/sw version bochs neu cloud produkteinfo.png
