petermaerki/puenterswis_heizung_2023_git/hardware_zentral/oekofen/20241009_suction_original.png

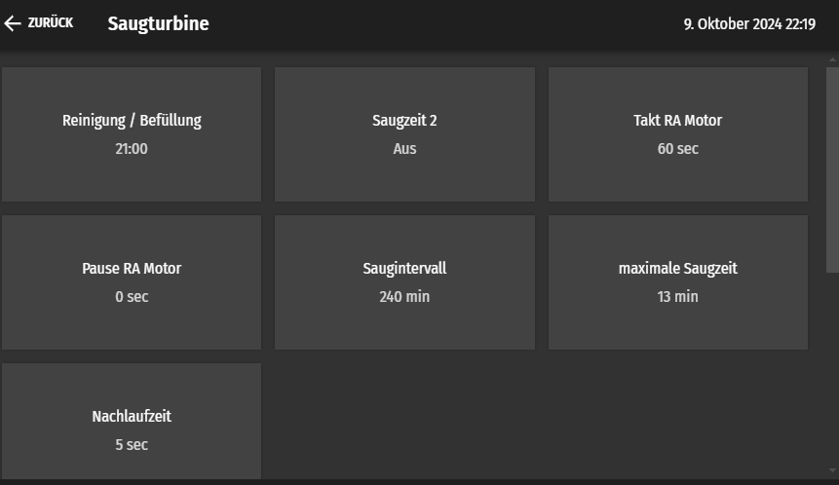
hardware_zentral/oekofen/20241009_suction_original.png
