petermaerki/puenterswis_heizung_2023_git/hardware_zentral/zentral_elektroheizeinsatz/abdeckung/Snap5.png

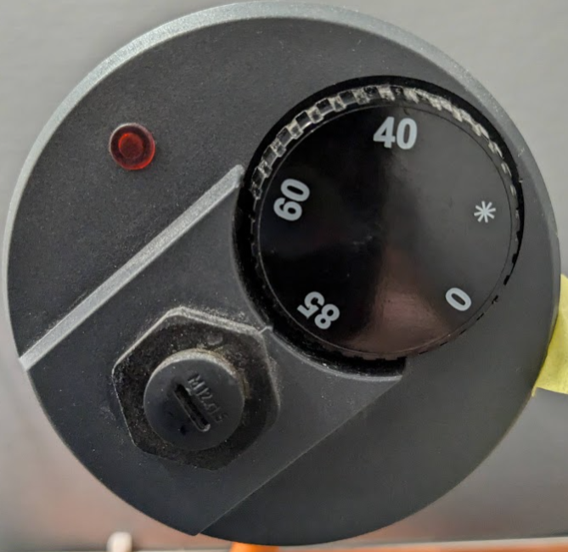
hardware_zentral/zentral_elektroheizeinsatz/abdeckung/Snap5.png
