petermaerki/puenterswis_heizung_2023_git/hardware_zentral/zentral_hydraulik/fluss_messung/20240920_bochs_grafana_beispiel_fluss.png

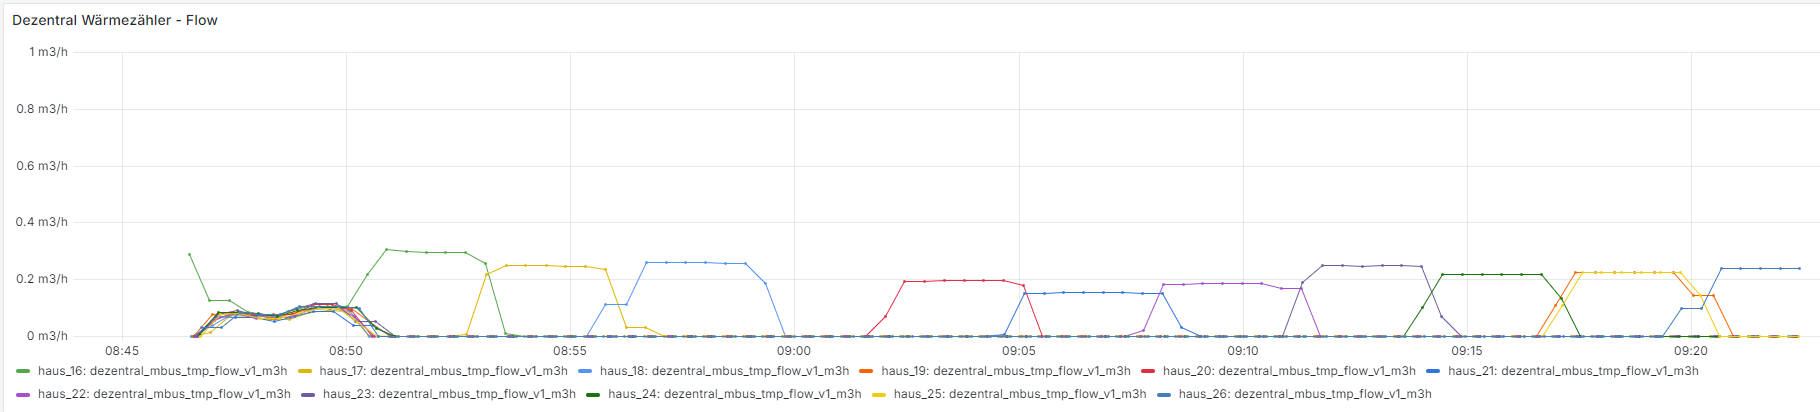
hardware_zentral/zentral_hydraulik/fluss_messung/20240920_bochs_grafana_beispiel_fluss.png
