petermaerki/puenterswis_heizung_2023_git/hardware_zentral/zentral_steuerung/waveshare/SKU_25739_8-ch_relais_B/20240310b_waiting_time_between_frames_to_short.jpg

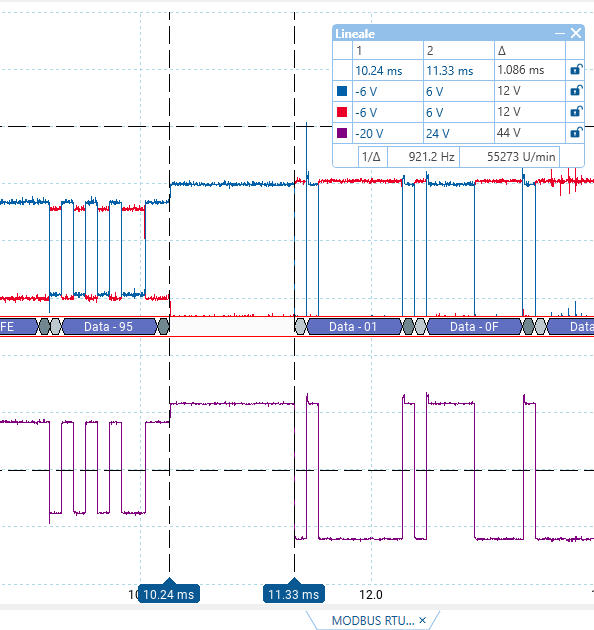
hardware_zentral/zentral_steuerung/waveshare/SKU_25739_8-ch_relais_B/20240310b_waiting_time_between_frames_to_short.jpg
