petermaerki/puenterswis_heizung_2023_git/hardware_zentral/zentral_steuerung/waveshare/SKU_26211_analog_0_10V_output_8CH/03_read_adress_control.png

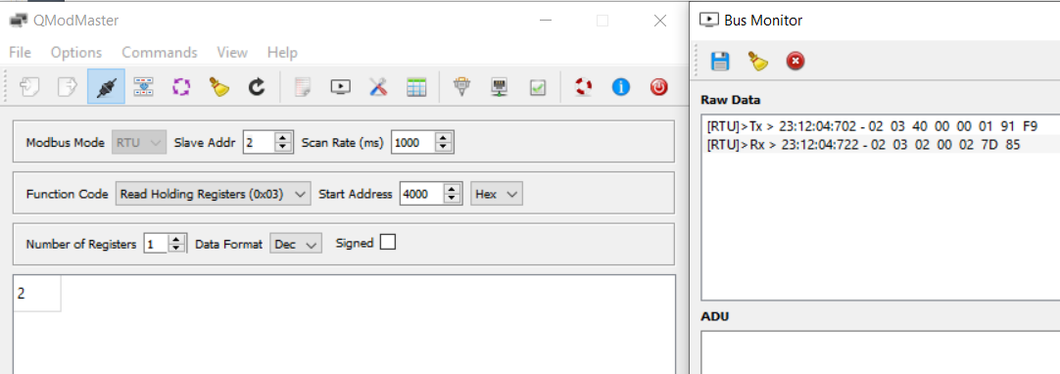
hardware_zentral/zentral_steuerung/waveshare/SKU_26211_analog_0_10V_output_8CH/03_read_adress_control.png
