petermaerki/puenterswis_heizung_2023_git/hardware_zentral/zentral_steuerung/waveshare/SKU_26211_analog_0_10V_output_8CH/20240310a_waiting_time_between_frames_to_short.jpg

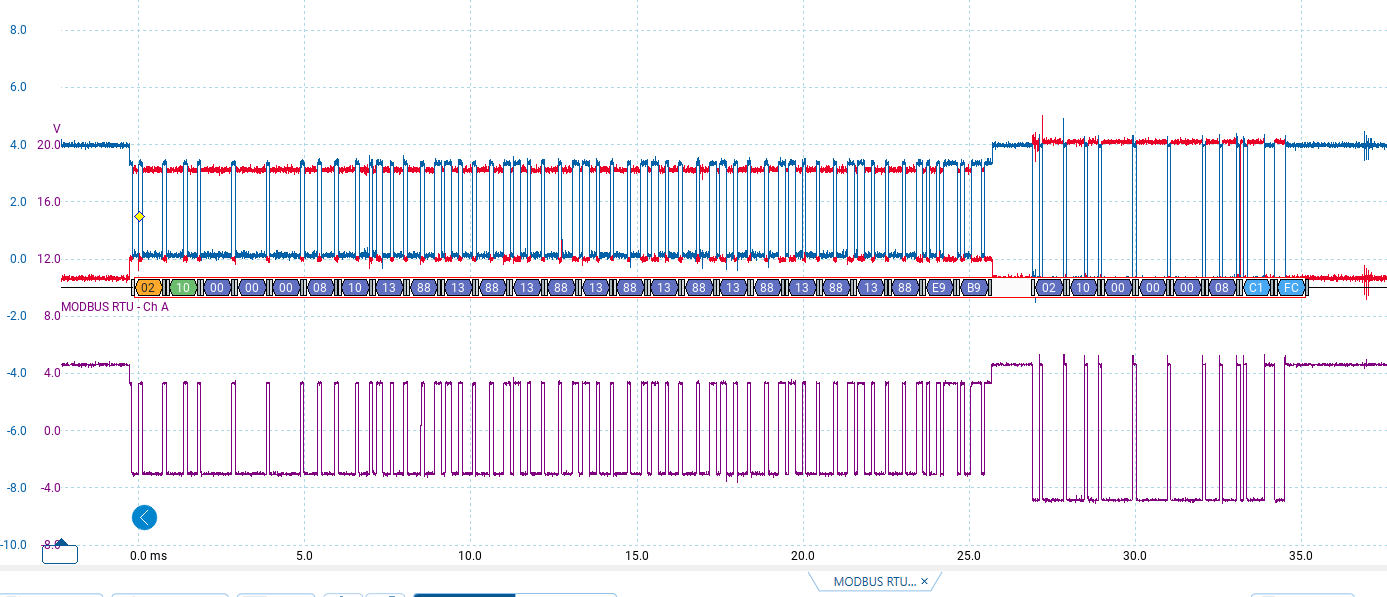
hardware_zentral/zentral_steuerung/waveshare/SKU_26211_analog_0_10V_output_8CH/20240310a_waiting_time_between_frames_to_short.jpg
