petermaerki/puenterswis_heizung_2023_git/hardware_zentral/zentral_waermezaehler/17253064795950.jpg

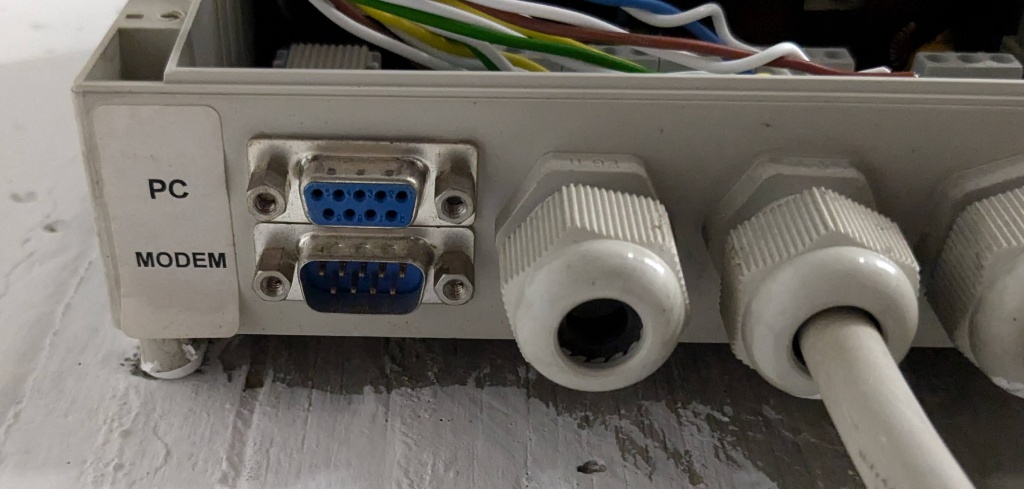
hardware_zentral/zentral_waermezaehler/17253064795950.jpg
