petermaerki/puenterswis_heizung_2023_git/siedlung/fernleitung_kabel/haus_bau_nummern.png

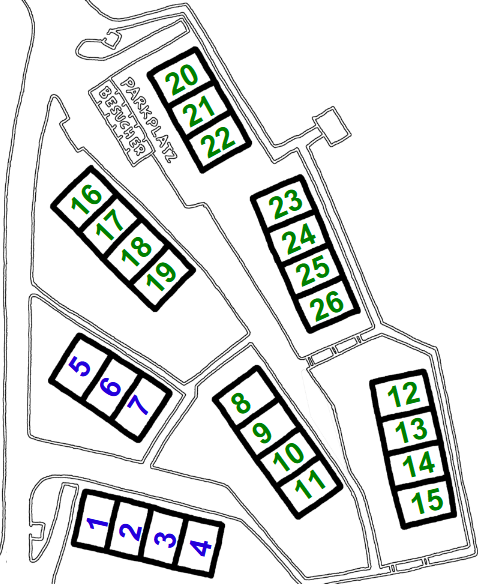
siedlung/fernleitung_kabel/haus_bau_nummern.png
