petermaerki/puenterswis_heizung_2023_git/siedlung/fernleitung_kabel/haus_bau_nummern_mit_leitungen.png

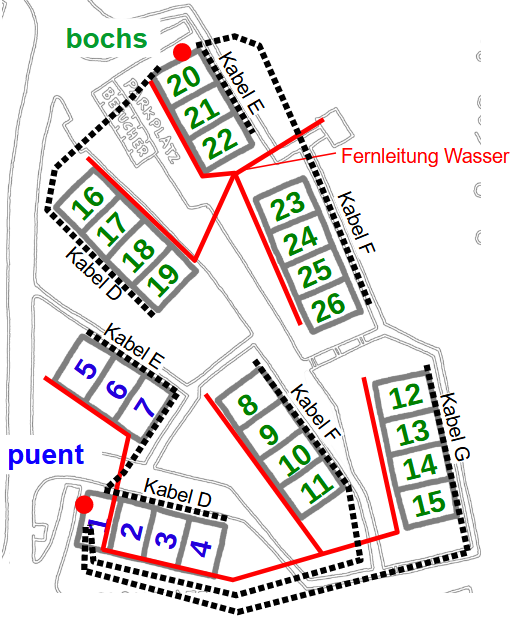
siedlung/fernleitung_kabel/haus_bau_nummern_mit_leitungen.png
