petermaerki/puenterswis_heizung_2023_git/siedlung/fernleitung_kabel/haus_bau_nummern_mit_leitungen_bochs.png

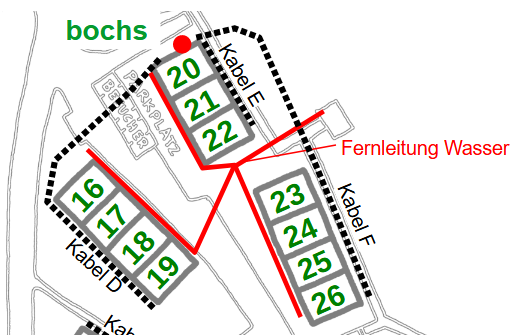
siedlung/fernleitung_kabel/haus_bau_nummern_mit_leitungen_bochs.png
