petermaerki/puenterswis_heizung_2023_git/siedlung/fernleitung_kabel/haus_bau_nummern_mit_leitungen_puent.png

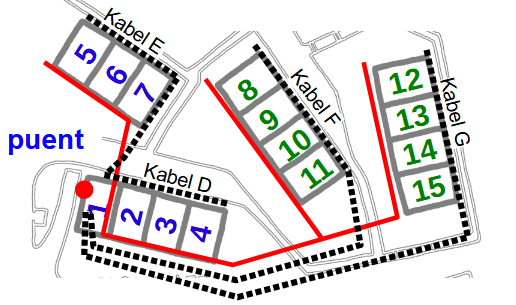
siedlung/fernleitung_kabel/haus_bau_nummern_mit_leitungen_puent.png
