petermaerki/puenterswis_heizung_2023_git/hardware_zentral/zentral_steuerung/modbus/20240117a_rs485_resistance_series_bias.ods

Abklaerungen zu Modbus
 | Ziel: ich möchte nicht, dass ein einzelner Kurzschluss bei einer Unterstation bei RS485 das ganze System zum erliegen bringt.
 | SP3485EN-L/TR |  | in der Unterstation
 |  | https://www.mouser.ch/datasheet/2/146/sp3485-1816391.pdf
 |  | Diff output voltage |  | 1.5 | V | @ 27 Ohm |  | 54 | Ohm | Datenblatt Parameters
 |  |  |  | 0.0277777777777778 | A
 | Beispiel: In serie zu jeder Leitung, also A und B, je ein Widerstand |  |  |  |  |  |  | 56 | Ohm
 |  |  | Beispiel am Ende Terminiert |  |  |  |  | 120 | Ohm
 |  |  | Wäre Spannung an der Terminierung |  |  |  |  | 0.775862068965517 | V | was weit über der 200mV Schwelle ist.
 | Waveshare | SKU: 24271 |  | ist mir unklar wie der genau funktioniert.
 |  | Part Number: RS485-HUB-8P |  | Sind SP485EE drin |  | hat auch 1.5V bei 54 Ohm Last
 | Bei einem Kabelkurzschluss bei einer Unterstation: |  |  |  |  |  |  | 1.55555555555556 | V | also deutlich über 200mV Schwelle. Vermutlich stört ein KS dann nicht.
 | Bei einer Verbingung von A oder B zu GND |  |  |  |  |  |  | 0.75 | V | auch ok
 | Ist mir alles nicht so klar. Ich denke aber ein 56 Ohm Widertand in Serie zu jeder Leitung sollte nicht stören.
 | Das Kuperkabel macht nur noch einige Ohm aus. Stört also auch nicht.
Abschlusswiderstand wegen Reflexion
 | Reflexion ist kein Problem weil die Baudrate so gering ist. Keine Abschlusswiderstände.
 | Variante AC termination |  |  |  | 1.00E-07 | As/V
 |  | R |  |  | 4700 | Ohm
 |  |  |  | Teilnehmer | 32 | Stück
 |  |  |  | Last | 146.875 | Ohm | wäre ok
Biasing | Definition vom Pegel falls niemand aktiv treibt. Hier sollte der Pegel nicht flattern.
 | Mir ist nicht klar was der Hub macht weil von Waveshare keine rechte Spezifikation.
 | Unit Load |  |  | 21000 | Ohm | unit Load
 | Hier sollte eine Spannungs grösser |  |  | 0.2 | V | mit Biasing erzeugt werden.
 | Spannungsabfall Biasing R Beispiel |  |  | 1 | V
 | maximaler Biaswiderstand grob |  |  | 105000 | Ohm
 | Wahl Biasing Widerstand |  |  | 10000 | Ohm
 | Falls alle Teilnehmer ein solches Biasing haben, dann gäbe das eine zu treibende Last von
 |  |  | Teilnehmer | 32 | Stück
 |  |  | Last | 312.5 | Ohm | und das ist kein Problem zu treiben. |  |  | Also auch wenn ich die Sache ohne Hub laufen lassen würde, so könnte die Last aller parallelen Teilnehmer getrieben werden.
 |  |  | https://www.st.com/resource/en/application_note/an1690-failsafe-biasing-for-st485eb-stmicroelectronics.pdf
 |  |  |  |  |  |  |  |  | Failsafe AC termination |  | 22 kOhm
Was hat es im Waveshare Hub:
Was hat es im Waveshare USB to RS485 4fach
Bei beiden gibt es ein Biasing mit 1k Ohm Widerständen. Es ist daher nicht nötig das auch beim pcb_dezentral zu machen.
Idee |  | Ich mache ein Netzwerk welches gut funktioniert falls alle Teilbnehmer hinter einem Hub sind oder auch falls alle parallel an einem Master sind.
 |  | Ra, A zu Supply |  |  |  | 10000 | Ohm
 |  | Rb, B zu GND |  |  |  | 10000 | Ohm
 |  | Zwischen A und B |  |  |  | 1.00E-07 | F
 |  |  |  |  |  | 4700 | Ohm
 |  |  |  | Zeitkonstante |  | 0.00047 | s
 |  | Beispiel alle parallel |  |  | Stück | 30
 |  |  |  |  | Impedanz ca. | 157 | Ohm | ok
 |  | Erhöht etwas die Störfestigkeit.
 |  | Würde auch funktionieren falls der Master gar kein Biasing hätte.
 |  | Würde auch funktionieren falls kein Hub verwendet würde.
 |  | Reduziert die Reflexionen im Vergleich zu gar keiner Terminierung.
Entscheid: Alle pcb_dezentral werden mit so einem Netzwerk versehen.
Keine zusätzliche 120 Ohm Terminierung.
