petermaerki/puenterswis_heizung_2023_git/hardware_dezentral/pcb_kicad/00_project_parts/bizcard/footprints/TS-1187A-B-A-B.step

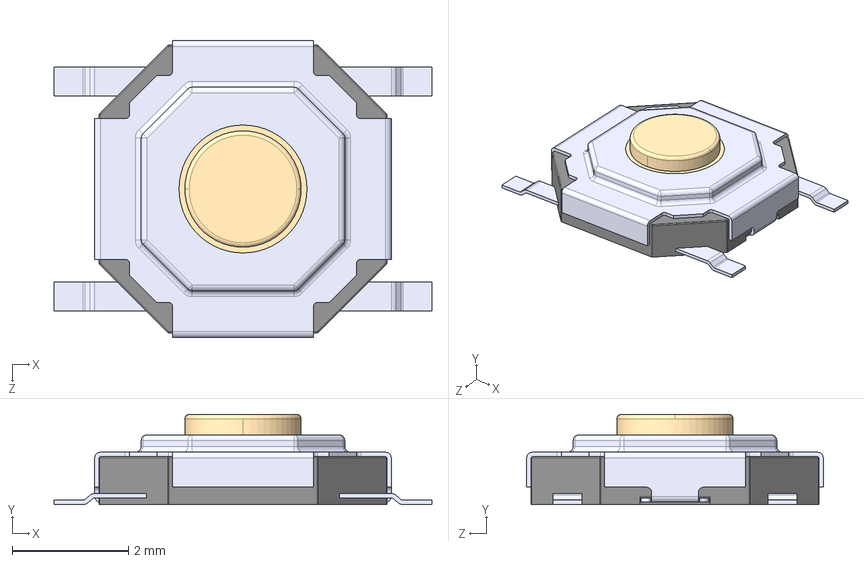
[picture p101: CAD file, 2023-11-20]
hardware_dezentral/pcb_kicad/00_project_parts/bizcard/footprints/TS-1187A-B-A-B.step
6.50 x 1.55 x 5.10 mm
