petermaerki/puenterswis_heizung_2023_git/hardware_dezentral/pcb_kicad/00_project_parts/din_rail_pcb_holder-DIN-rail-clip-adjustable.step

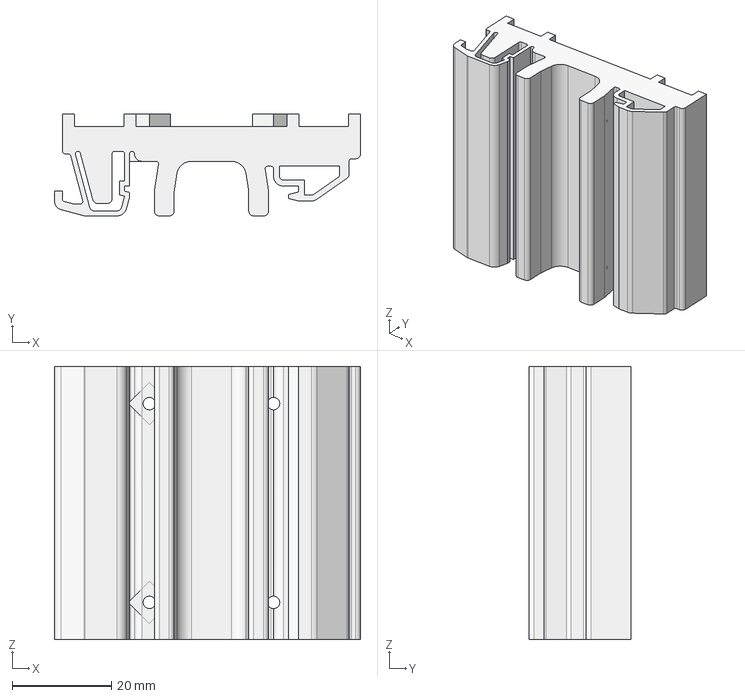
[picture p102: CAD file, 2023-11-22]
hardware_dezentral/pcb_kicad/00_project_parts/din_rail_pcb_holder-DIN-rail-clip-adjustable.step
61.6 x 20.5 x 55.0 mm
