petermaerki/puenterswis_heizung_2023_git/hardware_dezentral/pcb_kicad/00_project_parts/dip_switch/dip_switch_SPST16/dip_switch_SPST16.step

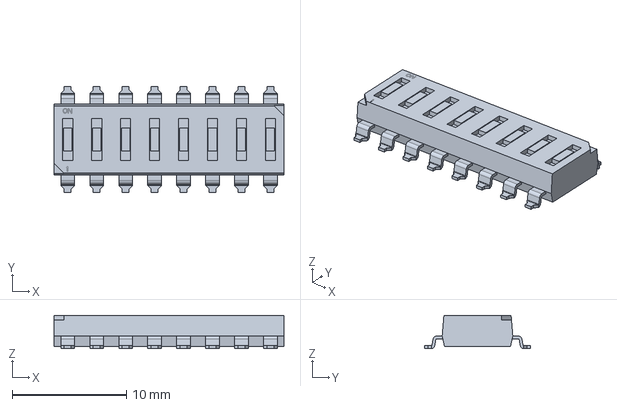
[picture p103: CAD file, 2023-11-25]
hardware_dezentral/pcb_kicad/00_project_parts/dip_switch/dip_switch_SPST16/dip_switch_SPST16.step
20.2 x 9.30 x 2.91 mm
