petermaerki/puenterswis_heizung_2023_git/hardware_dezentral/pcb_kicad/00_project_parts/pi_zero/AchimPieters/3D Models/Raspberry Pi Zero W.step

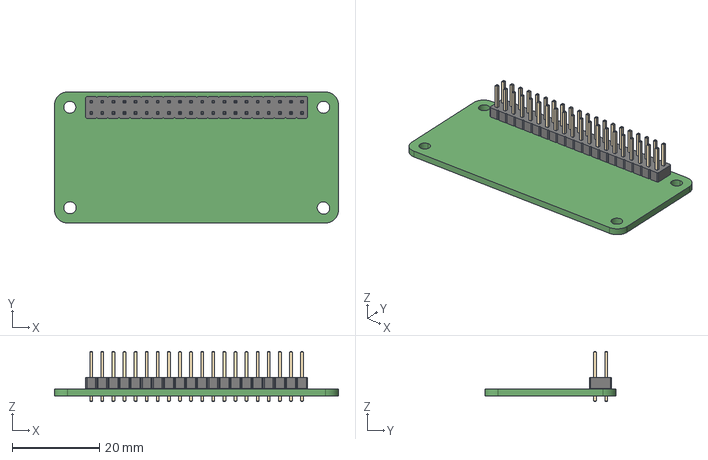
[picture p104: CAD file, 2023-11-20]
hardware_dezentral/pcb_kicad/00_project_parts/pi_zero/AchimPieters/3D Models/Raspberry Pi Zero W.step
65.0 x 30.0 x 11.5 mm
