petermaerki/puenterswis_heizung_2023_git/hardware_dezentral/pcb_kicad/00_project_parts/bizcard/footprints/TYPE-C-31-M-12--3DModel-STEP-56544.STEP

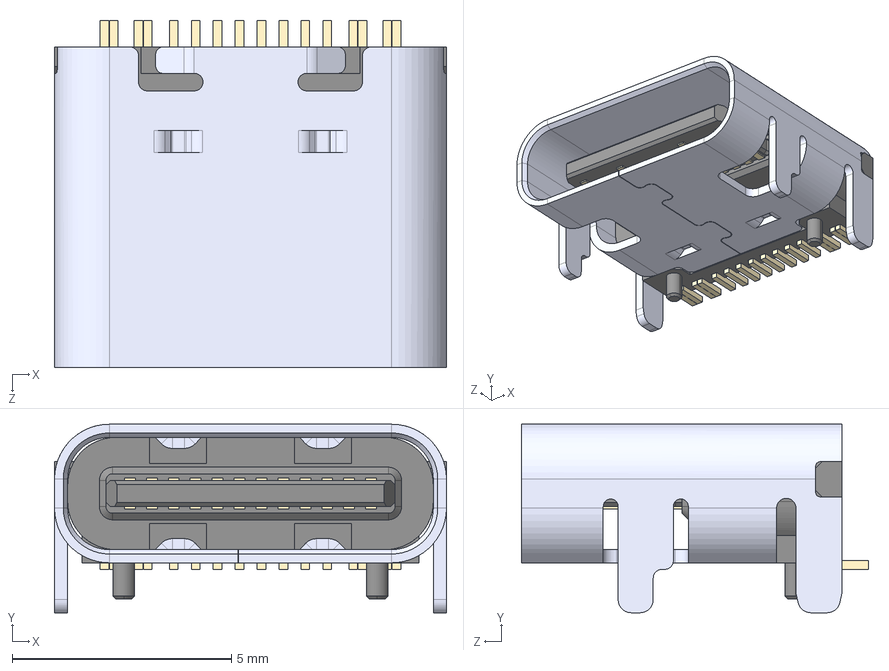
[picture p105: CAD file, 2023-11-20]
hardware_dezentral/pcb_kicad/00_project_parts/bizcard/footprints/TYPE-C-31-M-12--3DModel-STEP-56544.STEP
8.94 x 4.30 x 7.90 mm
