petermaerki/puenterswis_heizung_2023_git/hardware_dezentral/dezentral_beschriftung/netzstecker/20240218a_netzstecker_beschriftung.FCStd

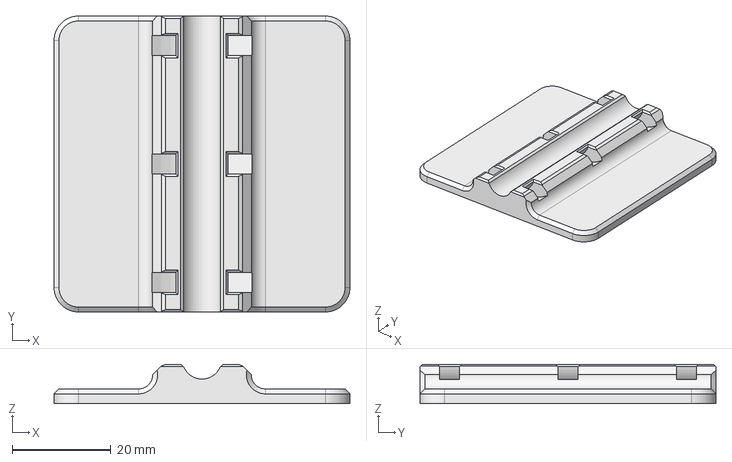
[picture p106: CAD file, 2024-03-10]
hardware_dezentral/dezentral_beschriftung/netzstecker/20240218a_netzstecker_beschriftung.FCStd
60.0 x 60.0 x 8.00 mm
