petermaerki/puenterswis_heizung_2023_git/hardware_dezentral/dezentral_din_rail_3d/din_rail_pcb_holder/20240212a_din_rail_pcb_holder.FCStd

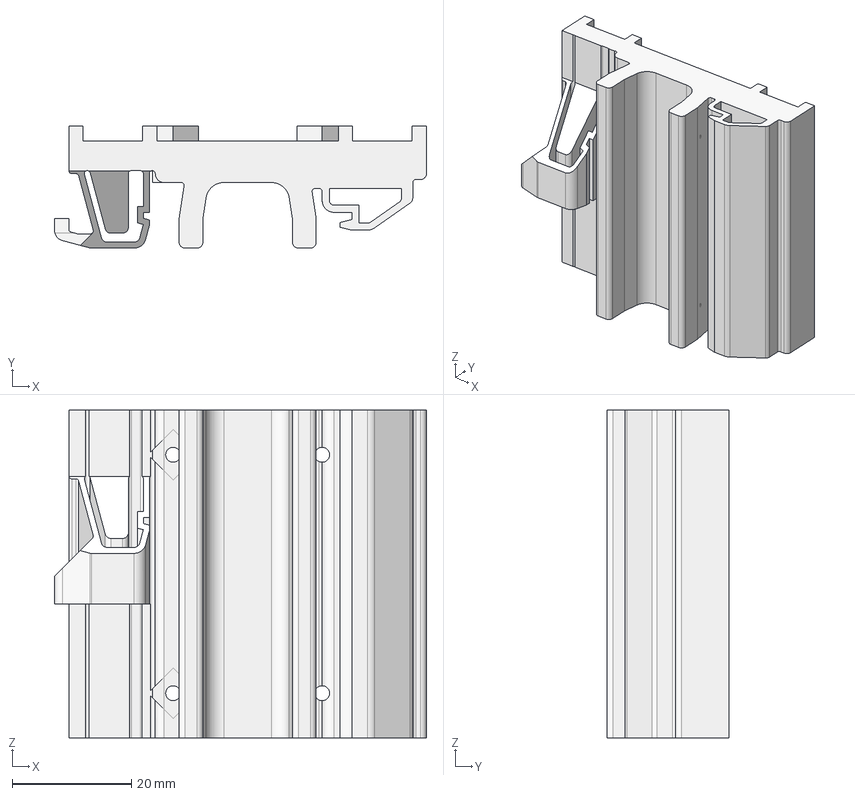
[picture p107: CAD file, 2023-11-25]
hardware_dezentral/dezentral_din_rail_3d/din_rail_pcb_holder/20240212a_din_rail_pcb_holder.FCStd
62.4 x 20.5 x 55.0 mm
