petermaerki/puenterswis_heizung_2023_git/hardware_dezentral/dezentral_din_rail_3d/din_rail_spacer_big_15/20240212a_din_rail_spacer_big_15.FCStd

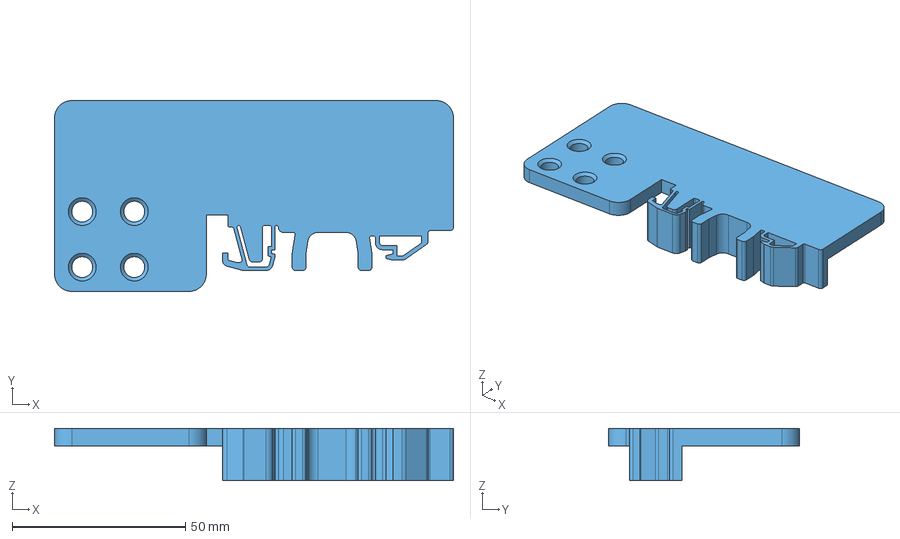
[picture p108: CAD file, 2024-02-13]
hardware_dezentral/dezentral_din_rail_3d/din_rail_spacer_big_15/20240212a_din_rail_spacer_big_15.FCStd
115.0 x 55.0 x 15.0 mm
