petermaerki/puenterswis_heizung_2023_git/hardware_dezentral/dezentral_din_rail_3d/din_rail_spacer_small_6/20240212a_din_rail_spacer_small_6.FCStd

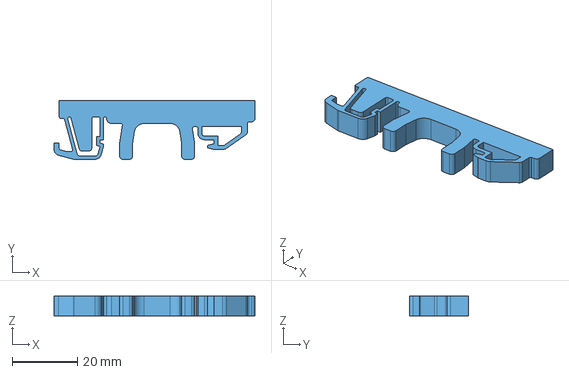
[picture p109: CAD file, 2024-02-13]
hardware_dezentral/dezentral_din_rail_3d/din_rail_spacer_small_6/20240212a_din_rail_spacer_small_6.FCStd
61.6 x 18.0 x 6.00 mm
