petermaerki/puenterswis_heizung_2023_git/hardware_dezentral/dezentral_drossel/schluessel_3d/20240812b_taco_setter_ronto_schluessel-body.3mf

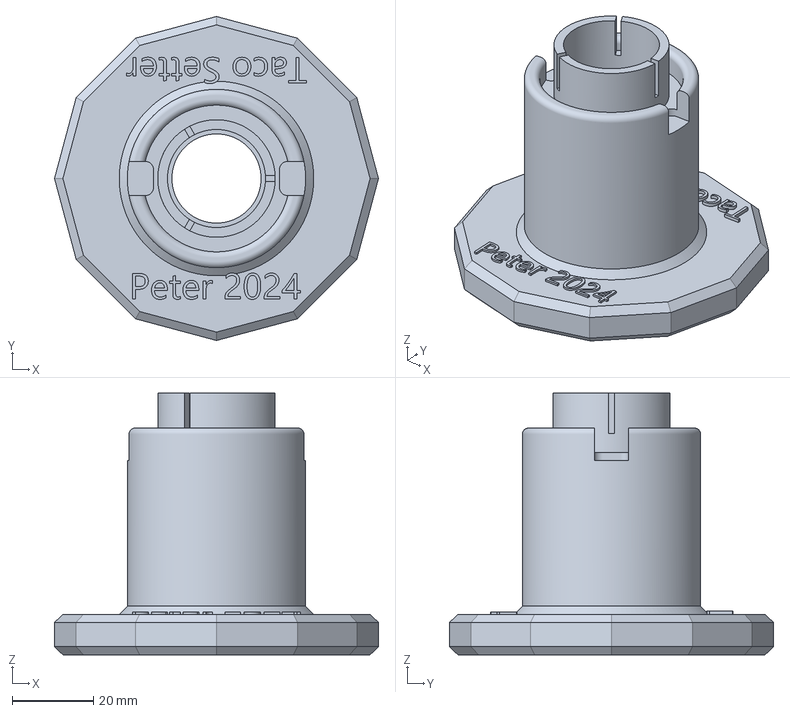
[picture p110: CAD file, 2024-08-17]
hardware_dezentral/dezentral_drossel/schluessel_3d/20240812b_taco_setter_ronto_schluessel-body.3mf
80.0 x 80.0 x 64.6 mm
