petermaerki/puenterswis_heizung_2023_git/hardware_dezentral/dezentral_elfero/ersatzschraubenfassung/20240522c_elfero_schraubenfassung_hinten.FCStd

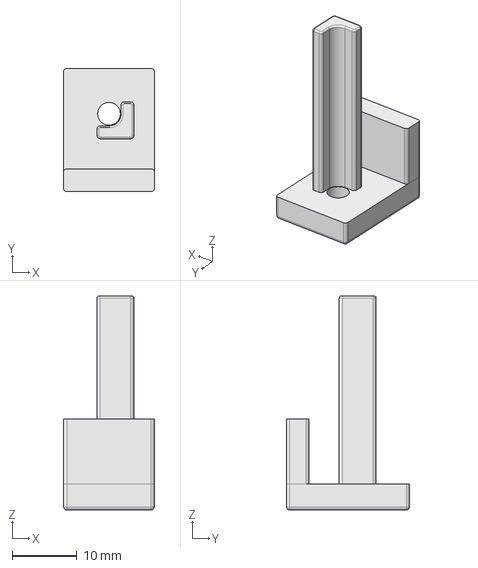
[picture p111: CAD file, 2024-05-27]
hardware_dezentral/dezentral_elfero/ersatzschraubenfassung/20240522c_elfero_schraubenfassung_hinten.FCStd
14.0 x 19.0 x 33.0 mm
