petermaerki/puenterswis_heizung_2023_git/hardware_dezentral/dezentral_entlueftungsventil/entlueftungsventil_schluessel/20240625b_entlueftungsventil_schluessel.FCStd

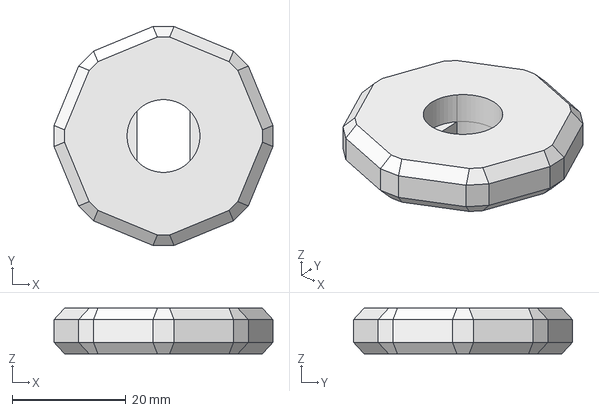
[picture p112: CAD file, 2024-07-06]
hardware_dezentral/dezentral_entlueftungsventil/entlueftungsventil_schluessel/20240625b_entlueftungsventil_schluessel.FCStd
38.5 x 38.5 x 8.00 mm
