petermaerki/puenterswis_heizung_2023_git/hardware_dezentral/dezentral_schlaufkasten/20240401h_abdeckung.FCStd

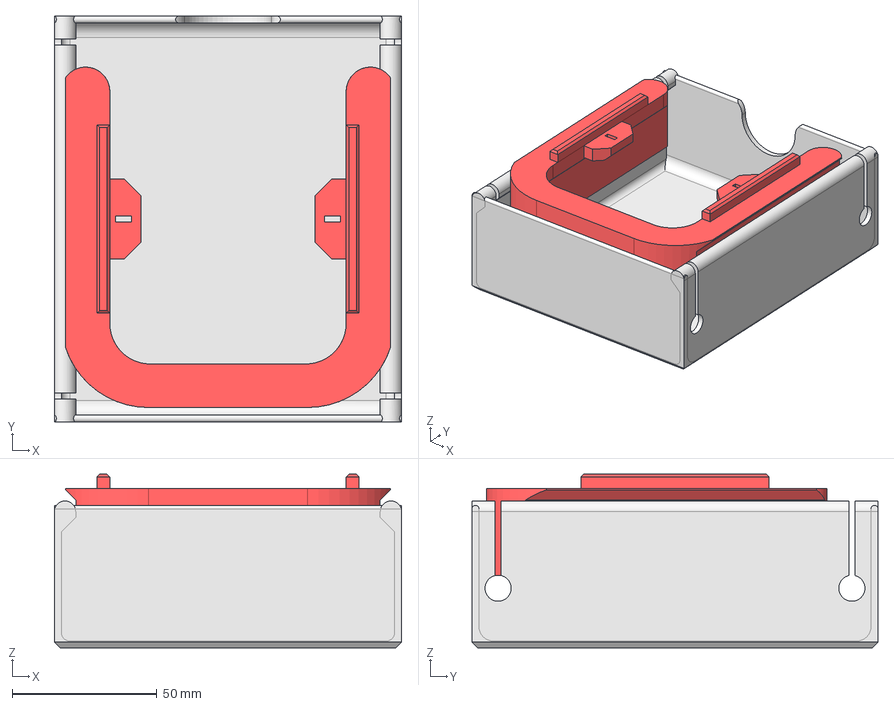
[picture p113: CAD file, 2024-04-12]
hardware_dezentral/dezentral_schlaufkasten/20240401h_abdeckung.FCStd
119.8 x 140.0 x 60.0 mm
halter
deckel
