petermaerki/puenterswis_heizung_2023_git/hardware_dezentral/haeuser_spezial/12/20240615a_elfero_winkel_halter_haus_12.FCStd

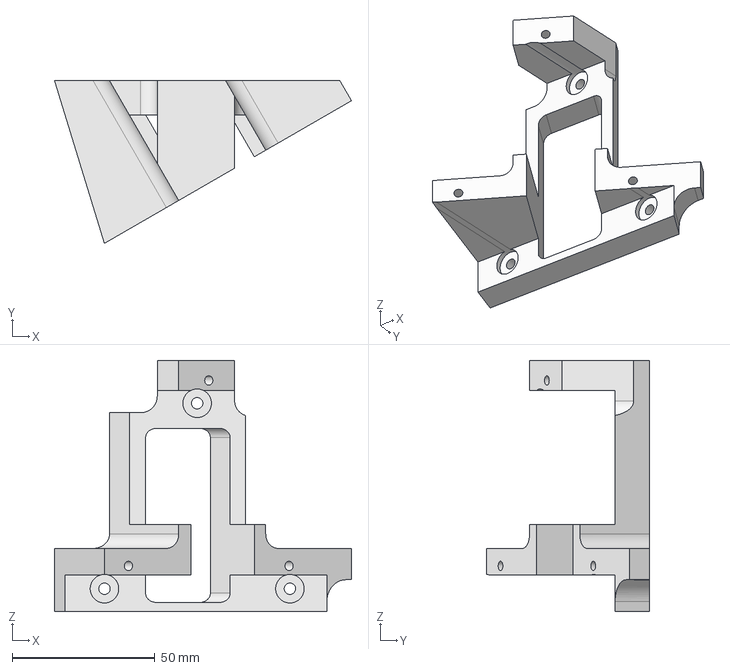
[picture p114: CAD file, 2024-07-07]
hardware_dezentral/haeuser_spezial/12/20240615a_elfero_winkel_halter_haus_12.FCStd
104.1 x 57.0 x 88.0 mm
