petermaerki/puenterswis_heizung_2023_git/hardware_dezentral/haeuser_spezial/17/20240614c_elfero_winkel_halter.FCStd

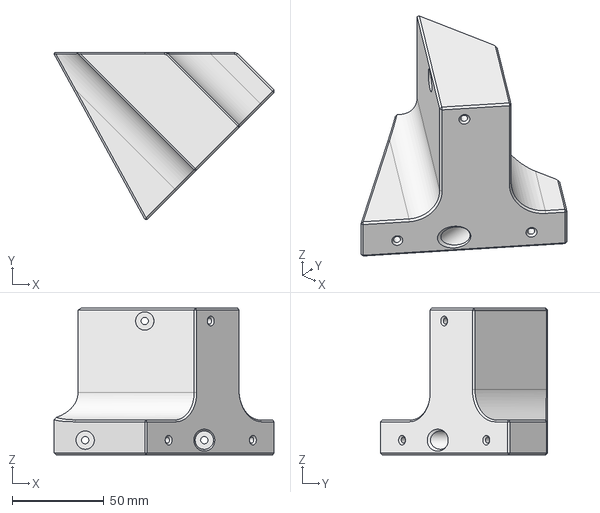
[picture p115: CAD file, 2024-07-07]
hardware_dezentral/haeuser_spezial/17/20240614c_elfero_winkel_halter.FCStd
120.0 x 91.2 x 80.0 mm
