petermaerki/puenterswis_heizung_2023_git/hardware_dezentral/pcb_kicad/00_project_parts/weidmueller/1146380000/3D/1146380000.stp

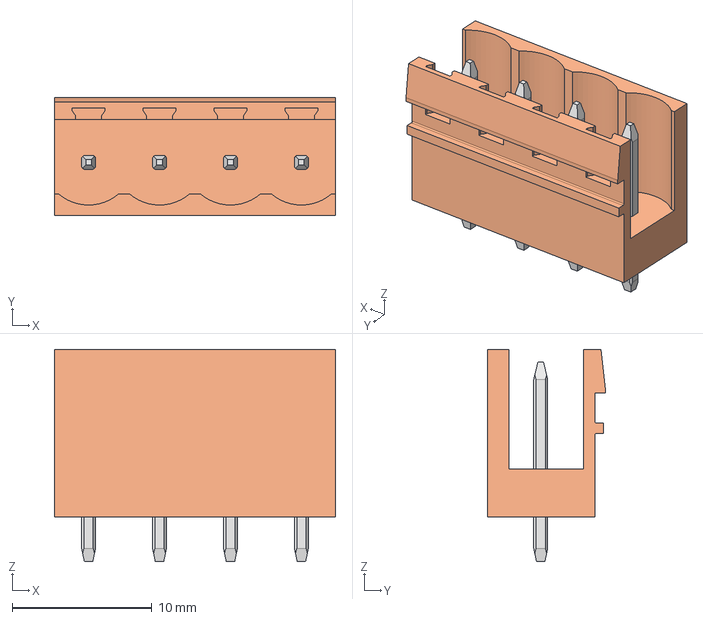
[picture p116: CAD file, 2023-11-20]
hardware_dezentral/pcb_kicad/00_project_parts/weidmueller/1146380000/3D/1146380000.stp
20.1 x 8.43 x 15.2 mm
