petermaerki/puenterswis_heizung_2023_git/hardware_dezentral/pcb_kicad/00_project_parts/weidmueller/1146570000/3D/1146570000.stp

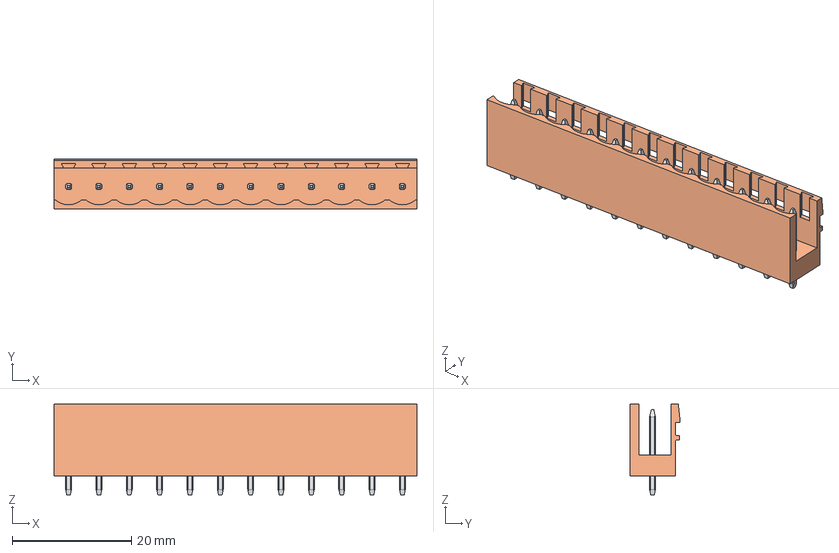
[picture p117: CAD file, 2023-11-20]
hardware_dezentral/pcb_kicad/00_project_parts/weidmueller/1146570000/3D/1146570000.stp
60.8 x 8.43 x 15.2 mm
