petermaerki/puenterswis_heizung_2023_git/hardware_dezentral/pcb_kicad/00_project_parts/weidmueller/1146770000/3D/1146770000.stp

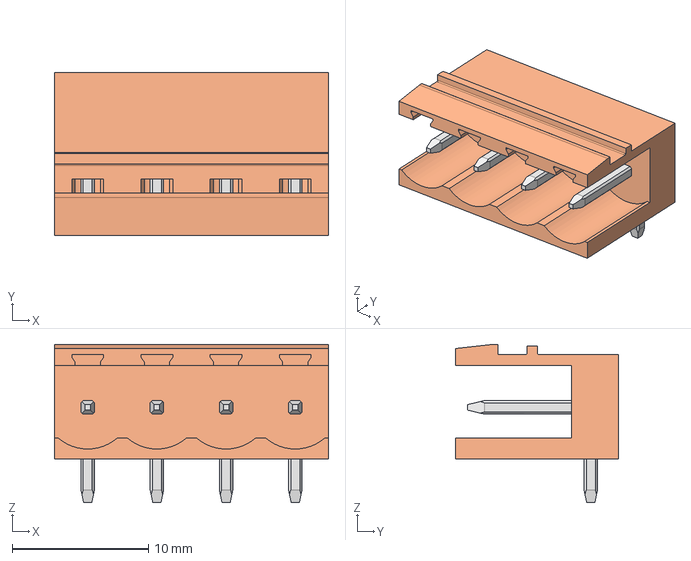
[picture p118: CAD file, 2023-11-20]
hardware_dezentral/pcb_kicad/00_project_parts/weidmueller/1146770000/3D/1146770000.stp
20.1 x 12.0 x 11.6 mm
