petermaerki/puenterswis_heizung_2023_git/(list of files, cad)

Other CAD files:
hardware_dezentral/dezentral_drossel/schluessel_3d/20240812a_taco_setter_ronto_schluessel.FCStd
hardware_dezentral/dezentral_drossel/schluessel_3d/20240812b_taco_setter_ronto_schluessel.FCStd
hardware_dezentral/dezentral_elfero/ersatzschraubenfassung/20240520b_elfero_bohrlehre_schraube_distanzbolzen_15.FCStd
hardware_dezentral/pcb_kicad/00_project_parts/weidmueller/1146810000/3D/1146810000.stp
hardware_dezentral/pcb_kicad/00_project_parts/weidmueller/1146900000/3D/1146900000.stp
hardware_dezentral/pcb_kicad/00_project_parts/weidmueller/1146940000/3D/1146940000.stp
hardware_zentral/zentral_divers/seifenhalter/20240804a_seifenhalter_wand.FCStd
hardware_zentral/zentral_elektroheizeinsatz/abdeckung/20241013a_notheizung_abdeckung-body.3mf
hardware_zentral/zentral_elektroheizeinsatz/abdeckung/20241013a_notheizung_abdeckung.FCStd
hardware_zentral/zentral_elektroheizeinsatz/beschriftung/20240907a_schild.FCStd
hardware_zentral/zentral_temperatursensoren/din_rail_spacer_9/20240715a_din_rail_spacer_9.FCStd
hardware_zentral/zentral_temperatursensoren/temperatur_sensor_aussenfuehler/20240713d_aussenfuehler.FCStd
hardware_zentral/zentral_temperatursensoren/temperatur_sensor_aussenfuehler/20240807a_innenfuehler.FCStd
