petermaerki/puenterswis_heizung_2023_git/hardware_zentral/oekofen/manuals/notes.txt

Peter Maerki 2024-08-04_08_05_50

https://www.oekofen.com/de-ch/downloads/
Wir haben zwei Stück PESK-41 in Kaskade.
