petermaerki/puenterswis_heizung_2023_git/software/software-zero/install/822_pc-win_mobaxterm_images/session_zero_puent.png

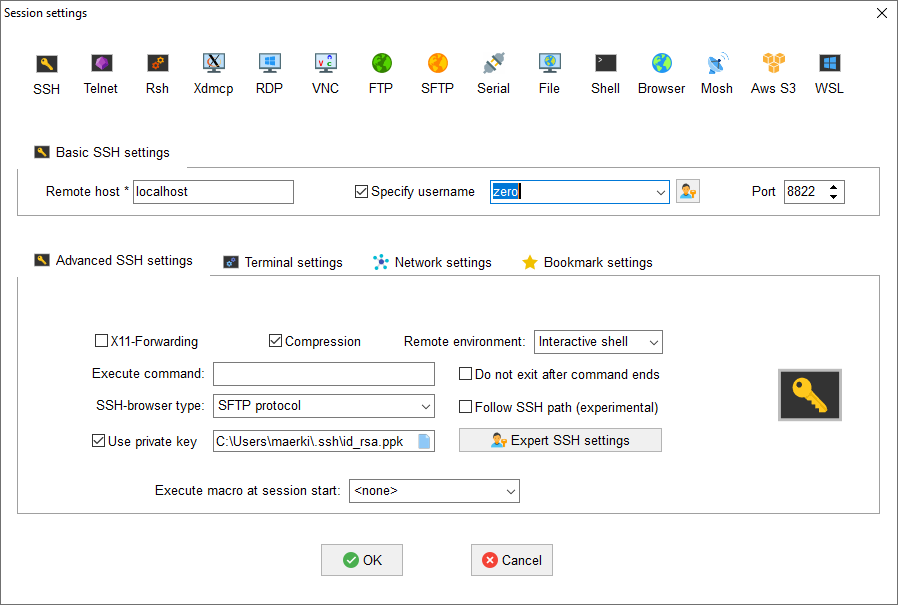
software/software-zero/install/822_pc-win_mobaxterm_images/session_zero_puent.png
