petermaerki/puenterswis_heizung_2023_git/software/software-zentral/zentral/controller_mischventil_testresults/controller_mischventil_test_scenario_normal.png

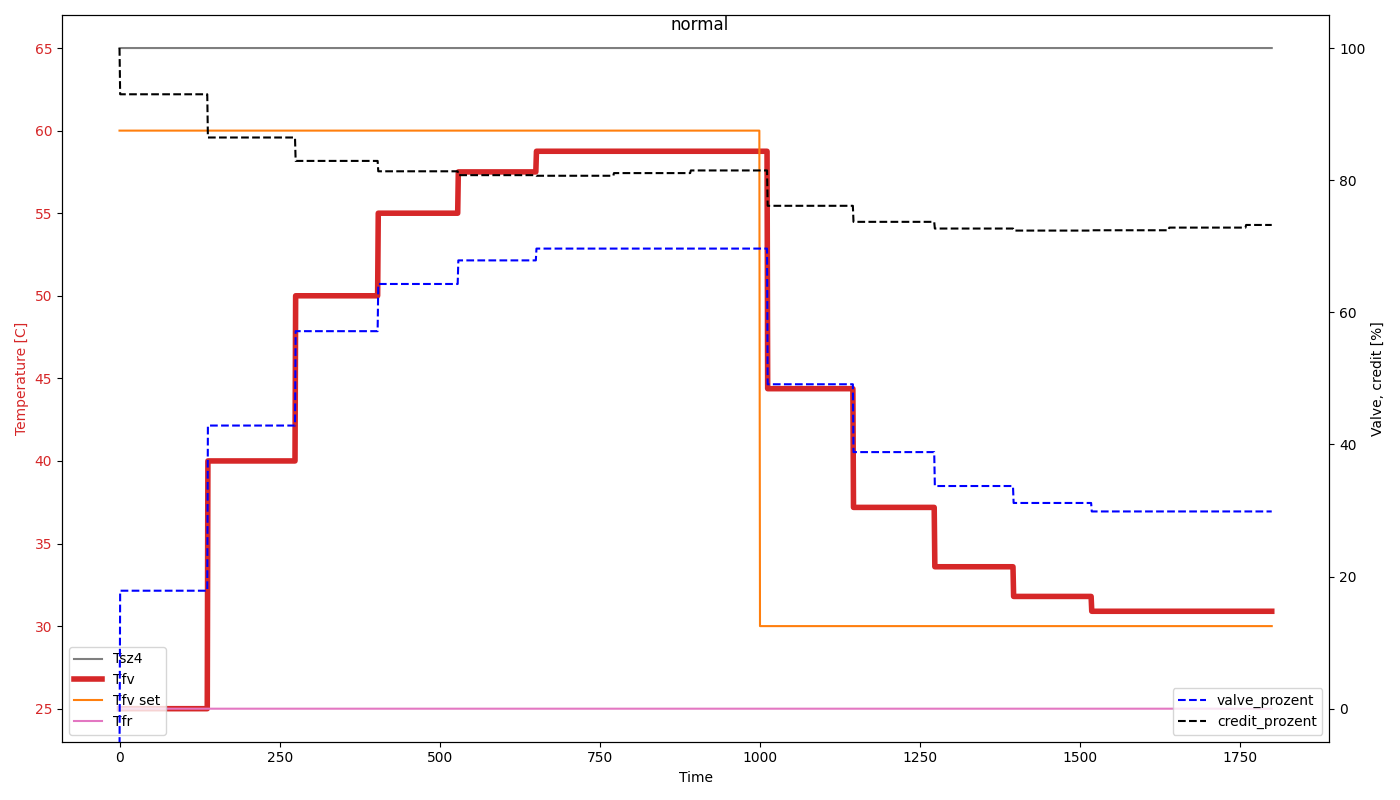
software/software-zentral/zentral/controller_mischventil_testresults/controller_mischventil_test_scenario_normal.png
