petermaerki/puenterswis_heizung_2023_git/software/software-zentral/zentral/controller_mischventil_testresults/controller_mischventil_test_scenario_Ruecklauf-waermer-als-zentraler-Speicher-daher-mischventil-inaktiv.png

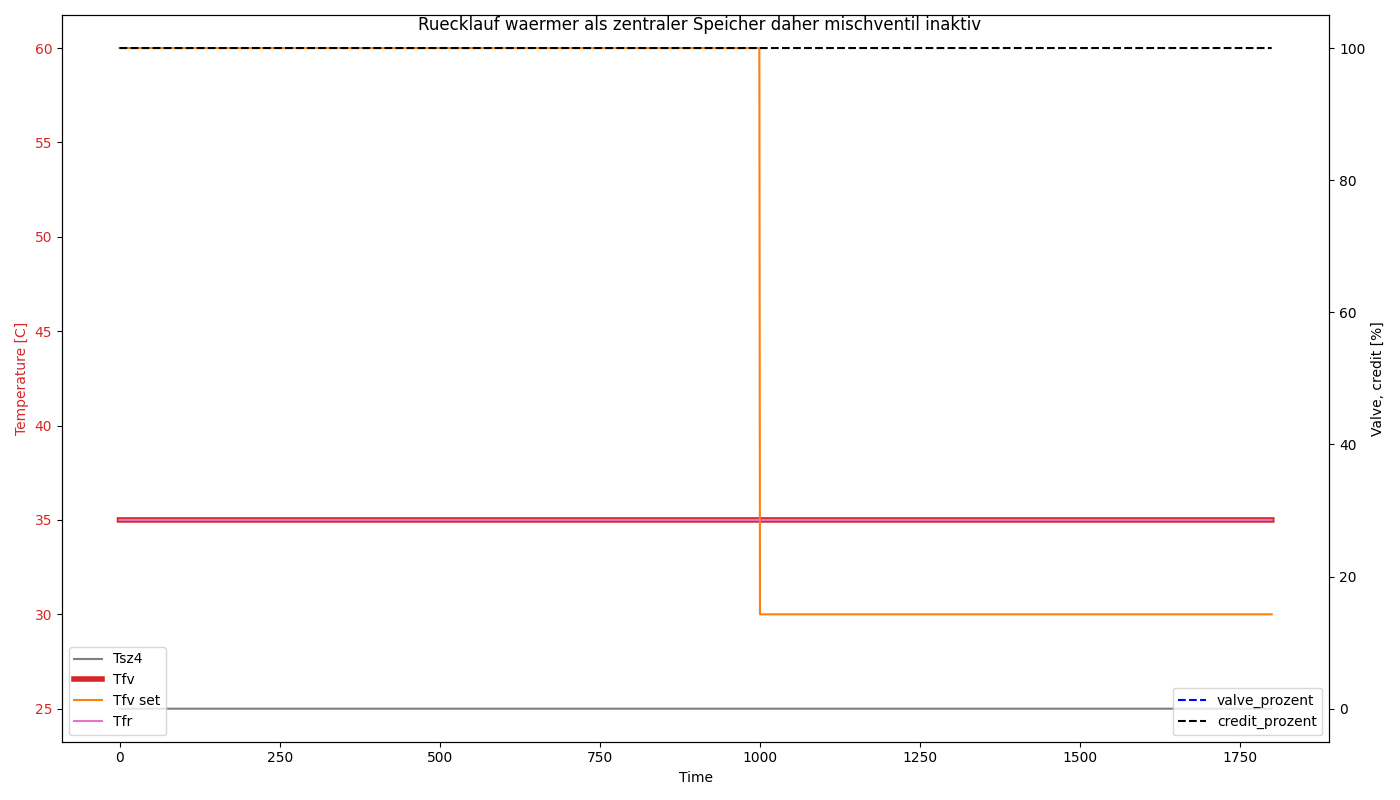
software/software-zentral/zentral/controller_mischventil_testresults/controller_mischventil_test_scenario_Ruecklauf-waermer-als-zentraler-Speicher-daher-mischventil-inaktiv.png
