petermaerki/puenterswis_heizung_2023_git/hardware_dezentral/dezentral_elfero/20241126a_dezentral_elfero_final.pdf

## Dezentral Übersicht Elfero

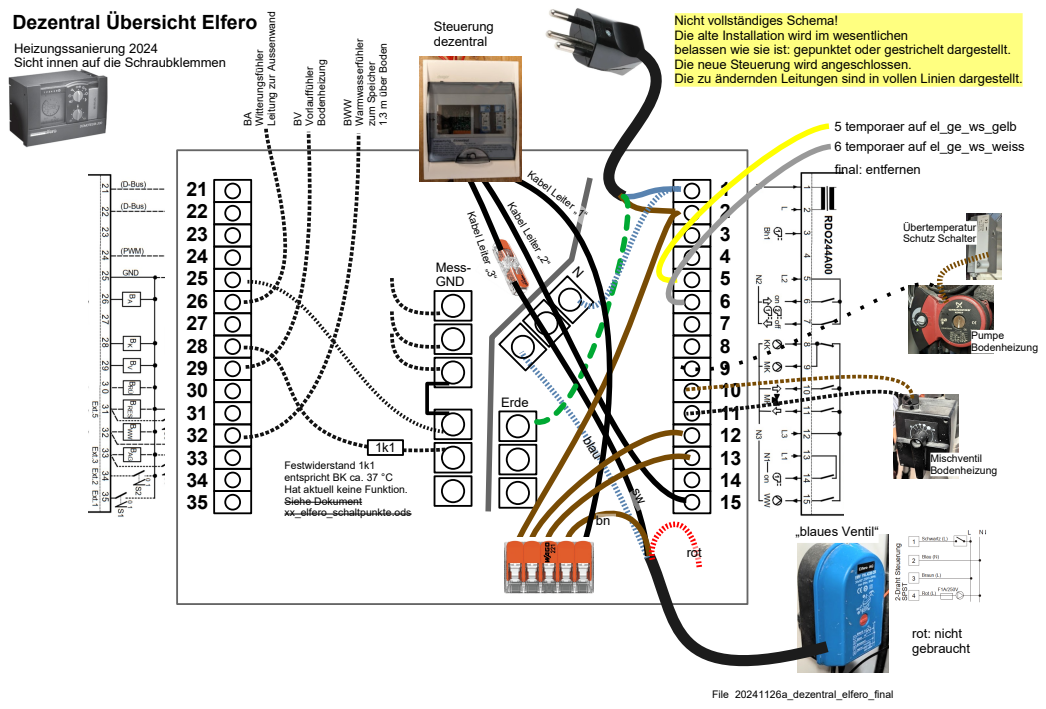
[picture p128: page 1]
File 20241126a_dezentral_elfero_final; Mess- GND; Witterungsfühler; Warm; wasserfühler; zum; Speicher; 1.3 m über Boden; Vorlauffühler; Bodenheizung; „blaues Ventil“; rot: nicht gebraucht; Erde; Mischventil Bodenheizung; Pumpe Bodenheizung; Übertemperatur Schutz Schalter; Steuerung dezentral; Kabel Leiter „1“; 5 temporaer auf el_ge_ws_gelb 6 temporaer auf el_ge_ws_weiss; final: entfernen; Kabel Leiter „2“; Kabel Leiter „3“; blau; rot

Leitung zur Aussenwand

Nicht vollständiges Schema!
Die alte Installation wird im wesentlichen
belassen wie sie ist: gepunktet oder gestrichelt dargestellt.
Die neue Steuerung wird angeschlossen.
Die zu ändernden Leitungen sind in vollen Linien dargestellt.

Heizungssanierung 2024
Sicht innen auf die Schraubklemmen

Festwiderstand 1k1
entspricht BK ca. 37 °C
Hat aktuell keine Funktion.
Siehe Dokument
xx_elfero_schaltpunkte.ods
