petermaerki/puenterswis_heizung_2023_git/hardware_zentral/zentral_schema/20240928a_zentral_schema.pdf

## steuerung_zentral Übersicht

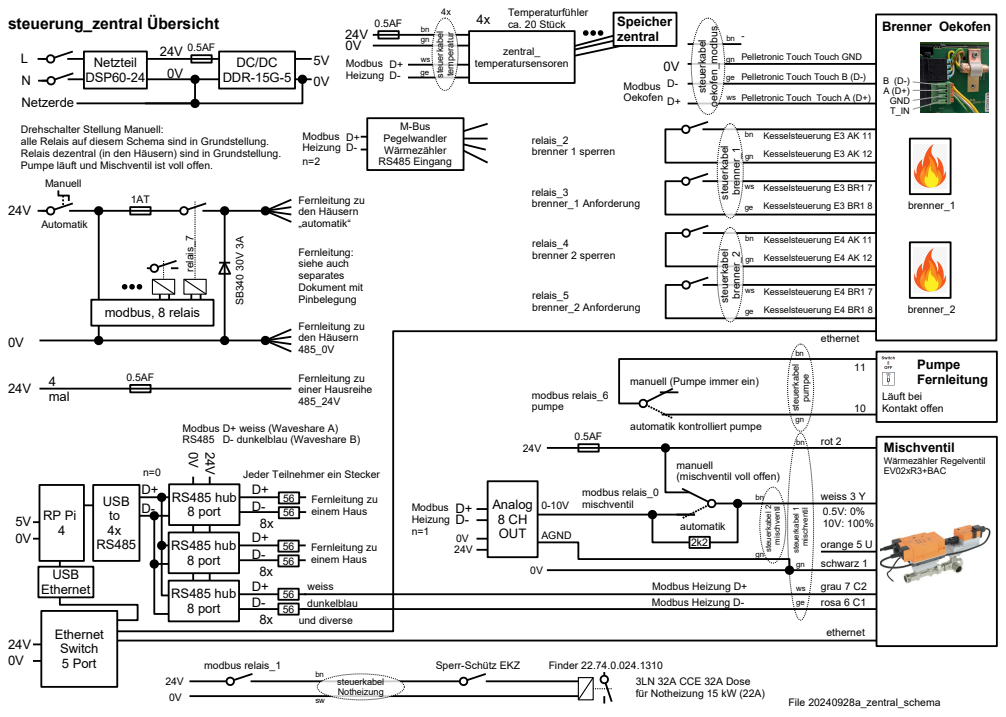
[picture p129: page 1]
Kesselsteuerung E4 BR1 7; ge Kesselsteuerung E4 BR1 8; Kesselsteuerung E4 AK 11; Kesselsteuerung E4 AK 12; steuerkabel pumpe; steuerkabel 2; mischventil; steuerkabel 1; File 20240928a_zentral_schema; schwarz 1; rot 2; weiss 3 Y; orange 5 U; Modbus Heizung D-; rosa 6 C1; Modbus Heizung D+; grau 7 C2; ethernet; modbus relais_0 mischventil; automatik; Mischventil Wärmezähler Regelventil EV02xR3+BAC; Pumpe Fernleitung; modbus relais_6 pumpe; modbus, 8 relais; Fernleitung zu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

Brenner Oekofen Speicher
zentral

modbus
Pelletronic Touch Touch GND
Pelletronic Touch Touch B (D-)
ws Pelletronic Touch Touch A (D+)

Drehschalter Stellung Manuell:
alle Relais auf diesem Schema sind in Grundstellung.
Relais dezentral (in den Häusern) sind in Grundstellung.
Pumpe läuft und Mischventil ist voll offen.
Manuell
Automatik

manuell (Pumpe immer ein)

automatik kontrolliert pumpe

manuell
(mischventil voll offen)

3LN 32A CCE 32A Dose
für Notheizung 15 kW (22A)
