petermaerki/puenterswis_heizung_2023_git/hardware_zentral/oekofen/20241015a_sp_zentral_level_hin_und_her.pdf

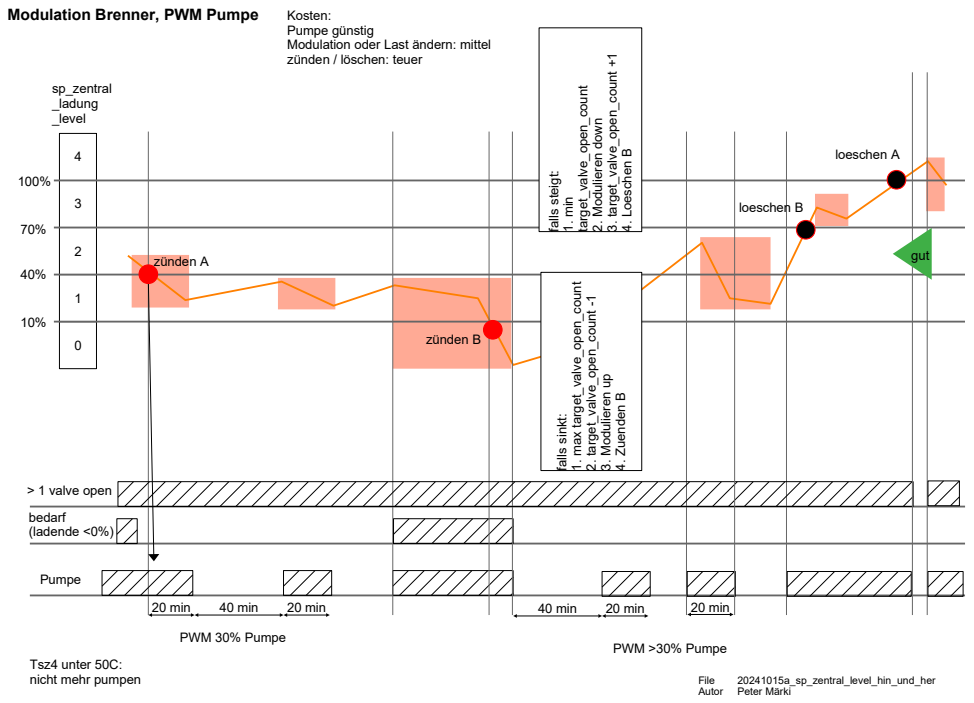
[picture p130: page 1]
File; 20241015a_sp_zentral_level_hin_und_her; Autor; Peter Märki; zünden B; sp_zentral _ladung _level; bedarf (ladende <0%); Pumpe; 20 min; 40 min; loeschen B; > 1 valve open; PWM 30% Pumpe; falls steigt:; 1. min; targ; alv; ount; dulieren d; 3. targ; ount +1; eschen B; gut; PWM >30% Pumpe; zünden A; falls sinkt:; x targ; 2. targ; ount -1; dulieren up; 4. Zuend; loeschen A

Modulation Brenner, PWM Pumpe

Kosten:
Pumpe günstig
Modulation oder Last ändern: mittel
zünden / löschen: teuer

Tsz4 unter 50C:
nicht mehr pumpen
