petermaerki/puenterswis_heizung_2023_git/hardware_zentral/raumeinteilung/20240728a_raumeinteilung_puent_bochs.pdf

# Raumeinteilung

Puenterswis | Bochslen

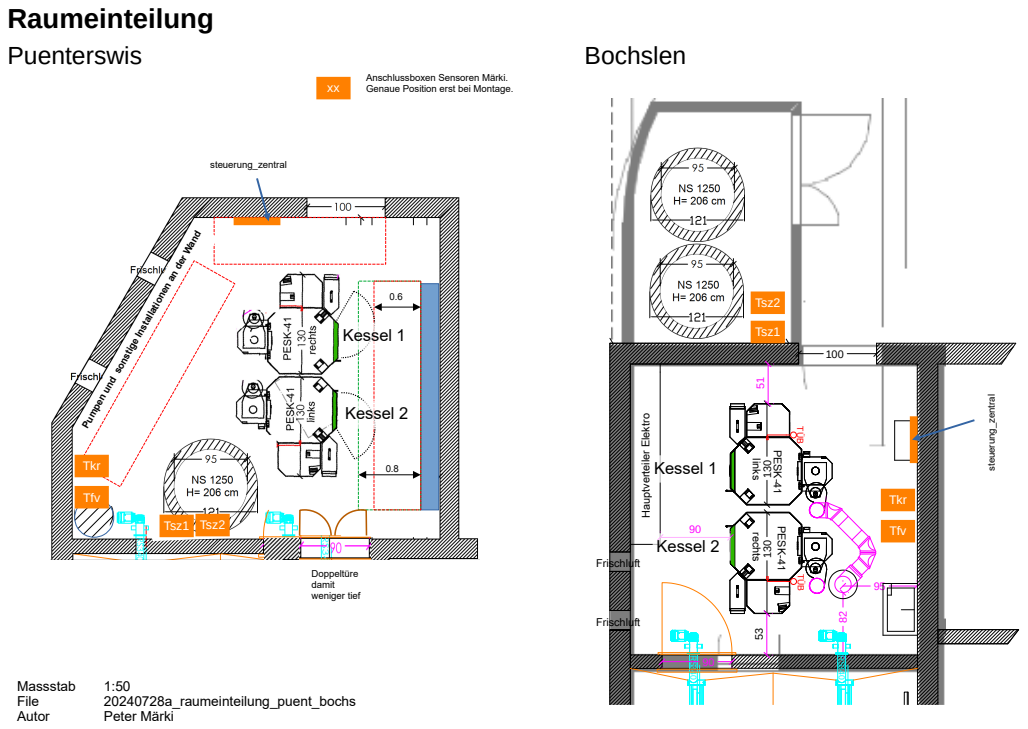
[picture p131: page 1]
Massstab; File; 20240728a_raumeinteilung_puent_bochs; Autor; Peter Märki; m-Schrägboden; Frischluft; estehend; Hauptverteiler Elektro; bestehend; PES; rechts; links 130; TÜB TÜB; steuerung_zentral; Tsz1; Tkr; Tfv; Tsz2; Kessel 1; Kessel 2; Doppeltüre damit weniger tief; Pumpen; und; sonstige Installationen; der Wand

Anschlussboxen Sensoren Märki.

Genaue Position erst bei Montage.
