petermaerki/puenterswis_heizung_2023_git/hardware_zentral/raumeinteilung/20231211_Steuerungskaesten-Anordnung_schaer.pdf

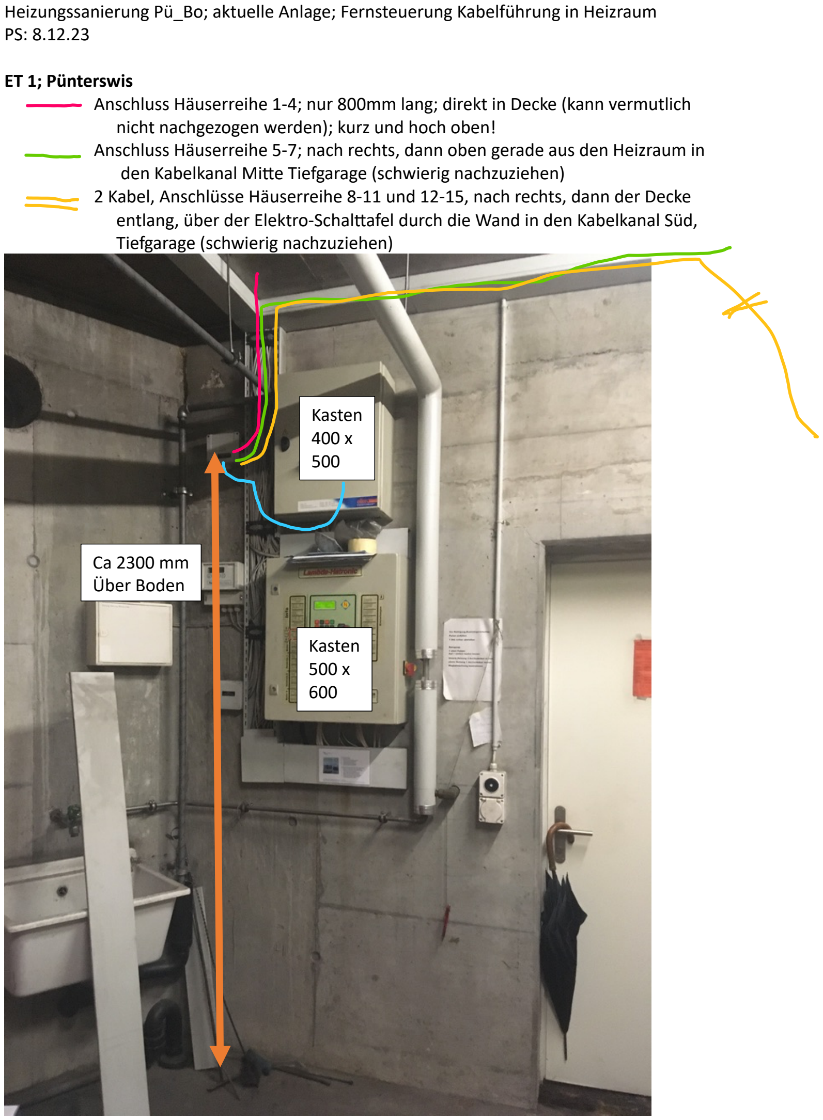
[picture p132: page 1]

Heizungssanierung Pü_Bo; aktuelle Anlage; Fernsteuerung Kabelführung in Heizraum PS: 8.12.23

ET 1; Pünterswis
Anschluss Häuserreihe 1-4; nur 800mm lang; direkt in Decke (kann vermutlich nicht nachgezogen werden); kurz und hoch oben!
Anschluss Häuserreihe 5-7; nach rechts, dann oben gerade aus den Heizraum in den Kabelkanal MiSe Tiefgarage (schwierig nachzuziehen)
2 Kabel, Anschlüsse Häuserreihe 8-11 und 12-15, nach rechts, dann der Decke entlang, über der Elektro-SchalSafel durch die Wand in den Kabelkanal Süd, Tiefgarage (schwierig nachzuziehen)

Ca 2300 mm
Über Boden

Kasten
400 x
500

Kasten
500 x
600

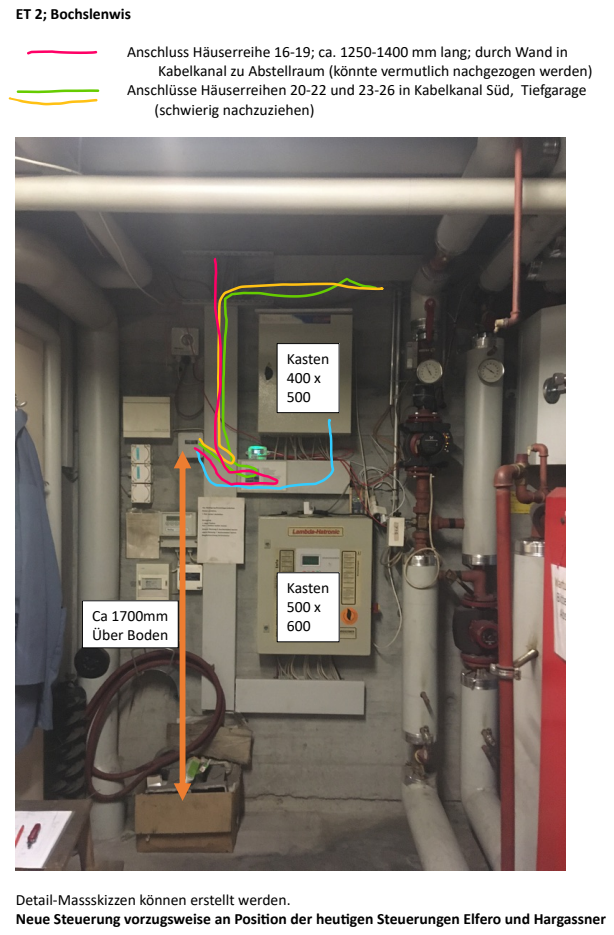
[picture p133: page 2]
ET 2; Bochslenwis; Ca 1700mm Über Boden; Kasten 400 x 500; Kasten 500 x 600

Anschluss Häuserreihe 16-19; ca. 1250-1400 mm lang; durch Wand in
Kabelkanal zu Abstellraum (könnte vermutlich nachgezogen werden)
Anschlüsse Häuserreihen 20-22 und 23-26 in Kabelkanal Süd, Tiefgarage
(schwierig nachzuziehen)

Detail-Massskizzen können erstellt werden.
Neue Steuerung vorzugsweise an Posi<on der heu<gen Steuerungen Elfero und Hargassner
