petermaerki/puenterswis_heizung_2023_git/hardware_dezentral/pcb_kicad/production_v1.0/doku/pcb_dezentral-cpu_page_2_v1.0.pdf

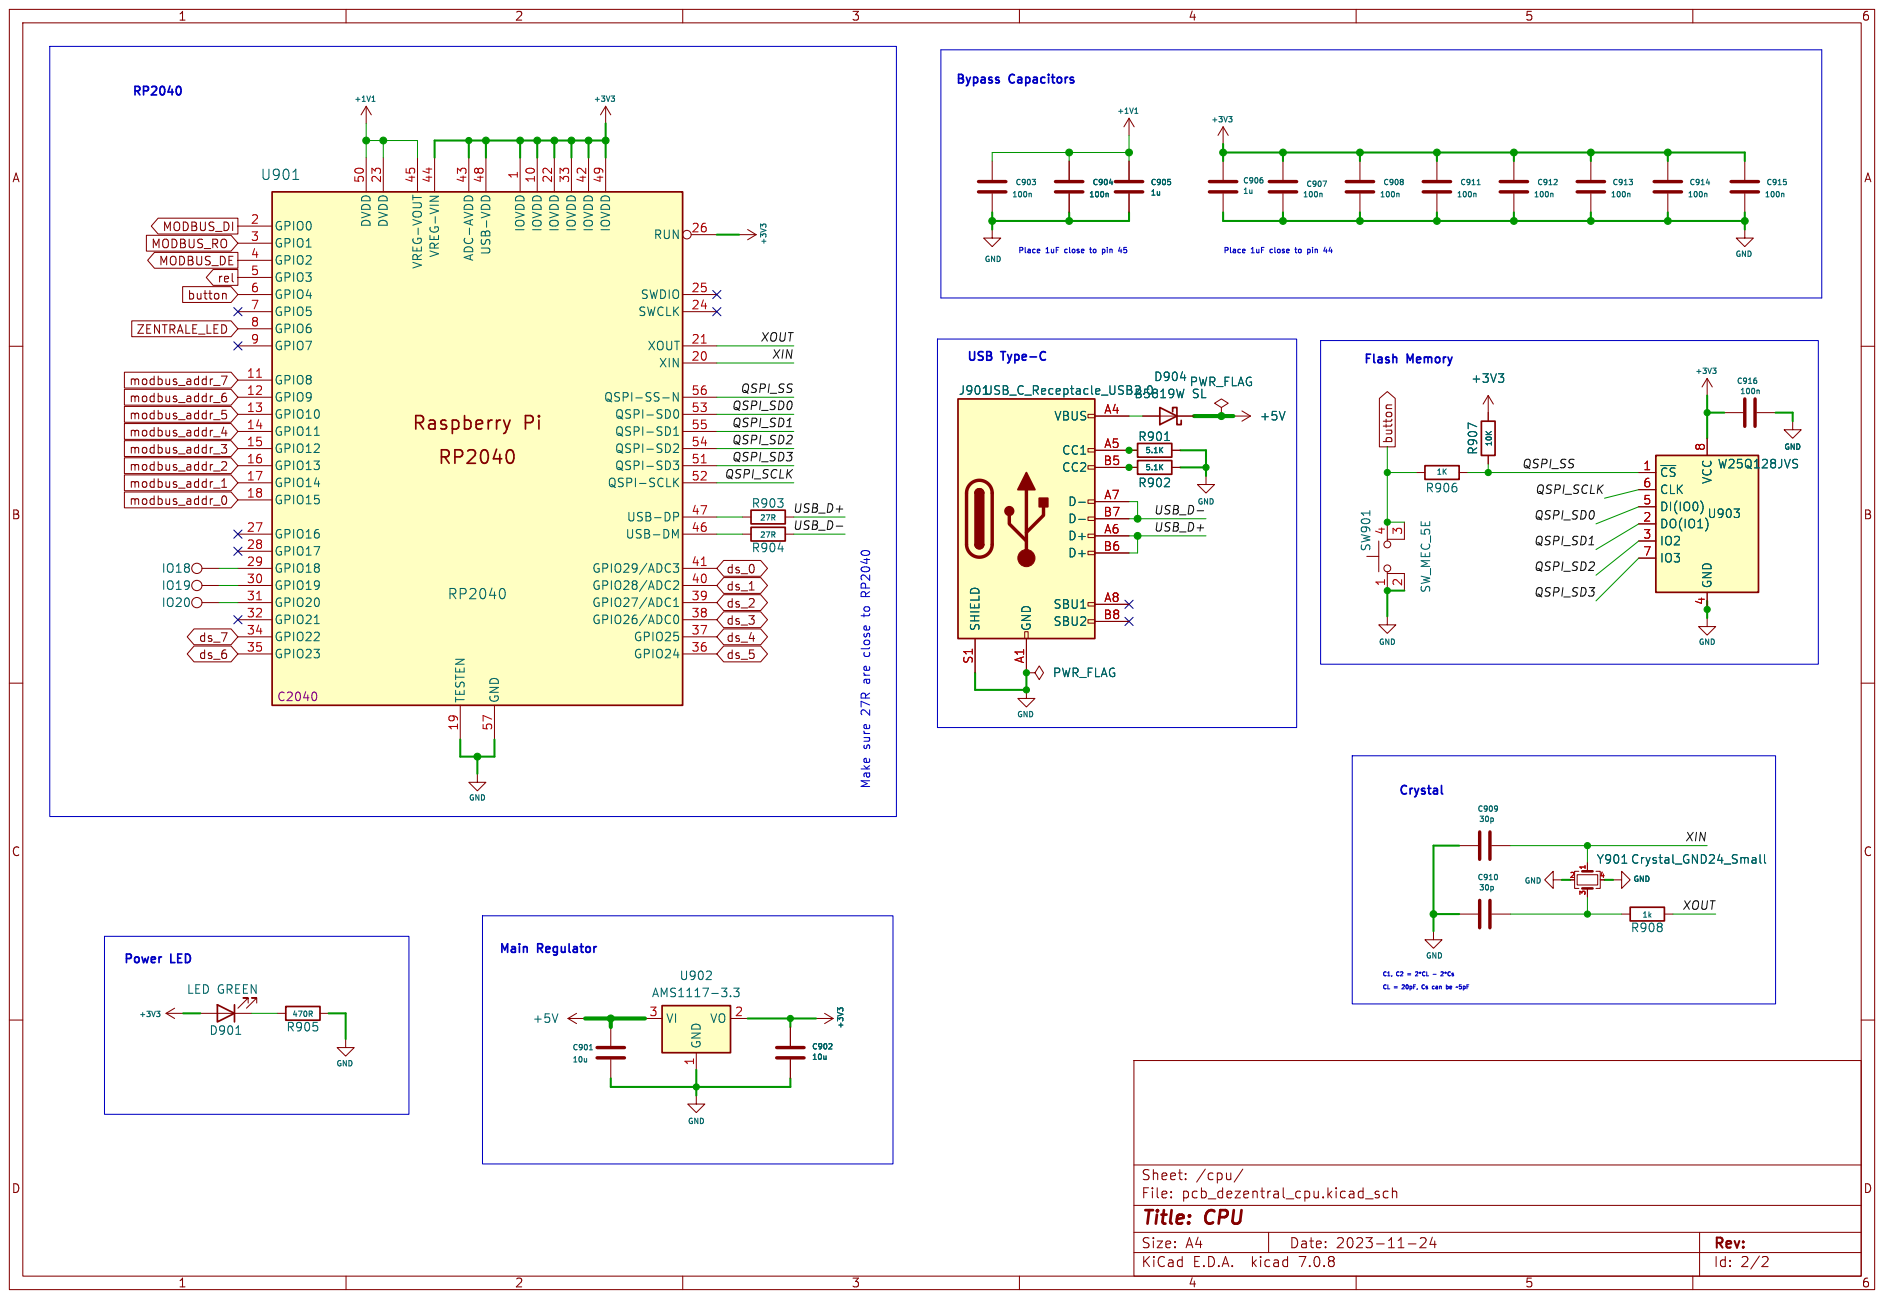
[picture p134: page 1]

1 IOVDD 10 GPIO8 11 GPIO9 12 GPIO10 13 GPIO11 14 GPIO12 15 GPIO13 16 GPIO14 17 GPIO15 18 TESTEN 19 GPIO0 2 XIN 20 XOUT 21 IOVDD 22 DVDD 23 SWCLK 24 SWDIO 25 RUN 26 GPIO16 27 GPIO17 28 GPIO18 29 GPIO1 3 GPIO19 30 GPIO20 31 GPIO21 32 IOVDD 33 GPIO22 34 GPIO23 35 GPIO24 36 GPIO25 37 GPIO26/ADC0 38 GPIO27/ADC1 39 GPIO2 4 GPIO28/ADC2 40 GPIO29/ADC3 41 IOVDD 42 ADC-AVDD 43 VREG-VIN 44 VREG-VOUT 45 USB-DM 46 USB-DP 47 USB-VDD 48 IOVDD 49 GPIO3 5 DVDD 50 QSPI-SD3 51 QSPI-SCLK 52 QSPI-SD0 53 QSPI-SD2 54 QSPI-SD1 55 QSPI-SS-N 56 GND 57 GPIO4 6 GPIO5 7 GPIO6 8 GPIO7 9 U901 RP2040 C2040

1 VO 2 VI 3 U902 AMS1117-3.3 GND A1 VBUS A4 CC1 A5 D+ A6 D- A7 SBU1 A8 CC2 B5 D+ B6 D- B7 SBU2 B8 SHIELD S1
