petermaerki/puenterswis_heizung_2023_git/hardware_dezentral/dezentral_schema_relais/20241126a_dezentral_schema_relais.pdf

## Steuerung dezentral Übersicht

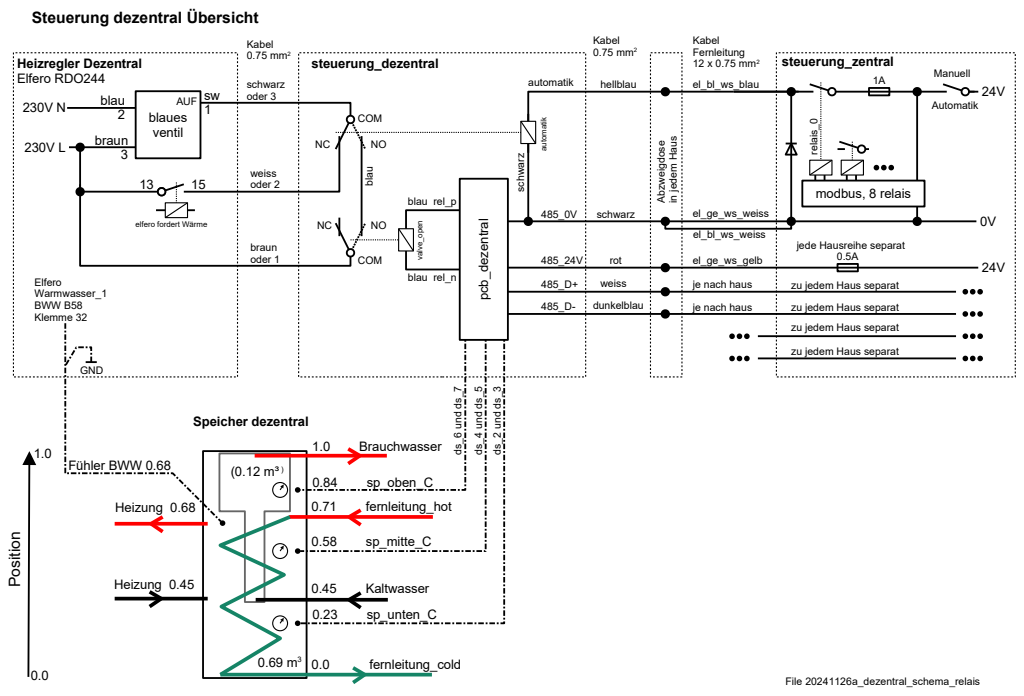
[picture p137: page 1]
File 20241126a_dezentral_schema_relais; Heizregler Dezentral Elfero RDO244; braun oder 1; weiss oder 2; braun 3; blau 2; schwarz oder 3; COM; automatik; blau rel_p; steuerung_dezentral; Speicher dezentral; Heizung 0.45; Kaltwasser; fernleitung_hot; fernleitung_cold; Heizung 0.68; Brauchwasser; sitio; Elfero Warmwasser_1 BWW B58 Klemme 32; Fühler BWW 0.68; sp_oben_C; sp_unten_C; sp_mitte_C; Manuell; Automatik; steuerung_zentral; el_bl_ws_blau; el_ge_ws_weiss; el_ge_ws_gelb; el_bl_ws_weiss; rot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

in jedem Haus

elfero fordert Wärme

jede Hausreihe separat

je nach haus

zu jedem Haus separat
