petermaerki/puenterswis_heizung_2023_git/hardware_zentral/zentral_hydraulik/20241108a_hydraulik_puent_bochs.pdf

## Heizung Hydraulik Puent

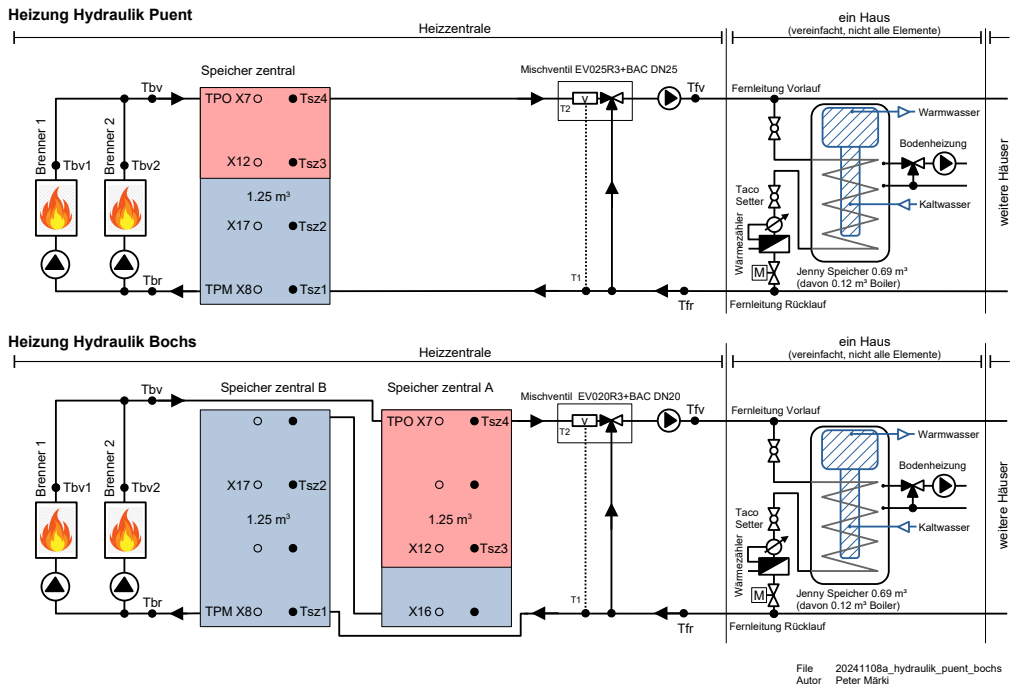
[picture p138: page 1]
File; 20241108a_hydraulik_puent_bochs; Autor; Peter Märki; Tfv; Tfr; Heizzentrale; ärmezähler; Taco Setter; Warmwasser; Kaltwasser; Bodenheizung; ein Haus; Fernleitung Rücklauf; Fernleitung Vorlauf; eitere; äuser; Mischventil EV025R3+BAC DN25; Mischventil EV020R3+BAC DN20; Jenny Speicher 0.69 m³; Speicher zentral; Tbv; Tbr; Brenner 1; Brenner 2; Tbv1; Tbv2; Tsz4; Tsz1; Tsz2; TPO X7; TPM X8; Tsz3; Speicher zentral B; Speicher zentral A

(vereinfacht, nicht alle Elemente)

Jenny Speicher 0.69 m³
(davon 0.12 m³ Boiler)

Heizung Hydraulik Bochs
