petermaerki/puenterswis_heizung_2023_git/hardware_dezentral/speicher/20240327a_dezentral_speicher.pdf

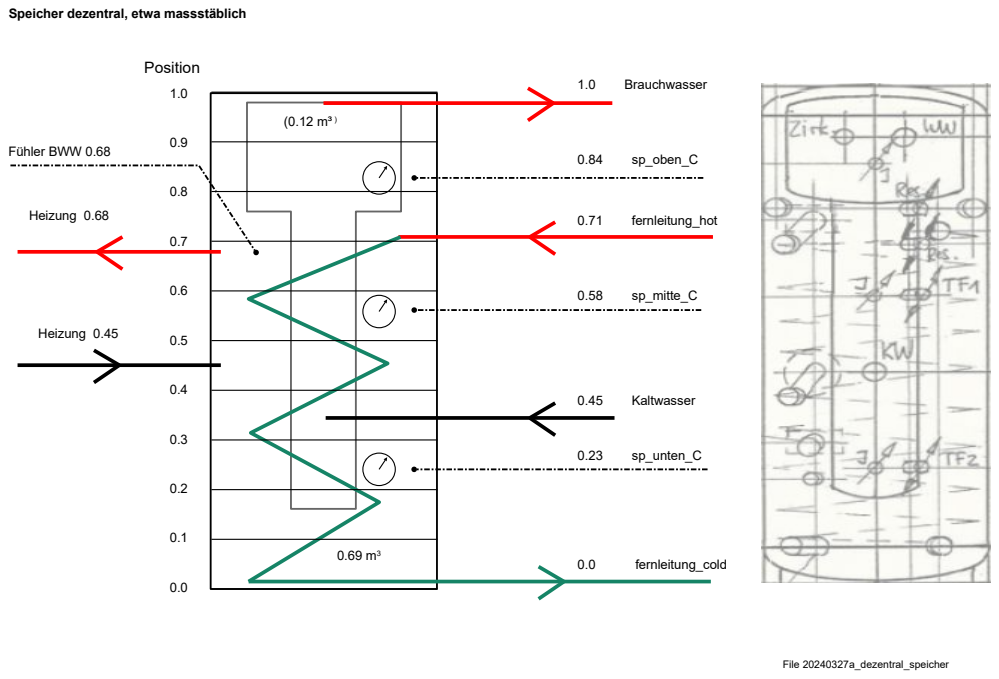
[picture p139: page 1]
File 20240327a_dezentral_speicher; Heizung 0.45; Kaltwasser; fernleitung_hot; fernleitung_cold; Heizung 0.68; Brauchwasser; Position; Fühler BWW 0.68; sp_oben_C; sp_unten_C; sp_mitte_C

Speicher dezentral, etwa massstäblich
