petermaerki/puenterswis_heizung_2023_git/hardware_dezentral/haeuser_spezial/13/20040315_revisionsplan_haus13_falsch.pdf

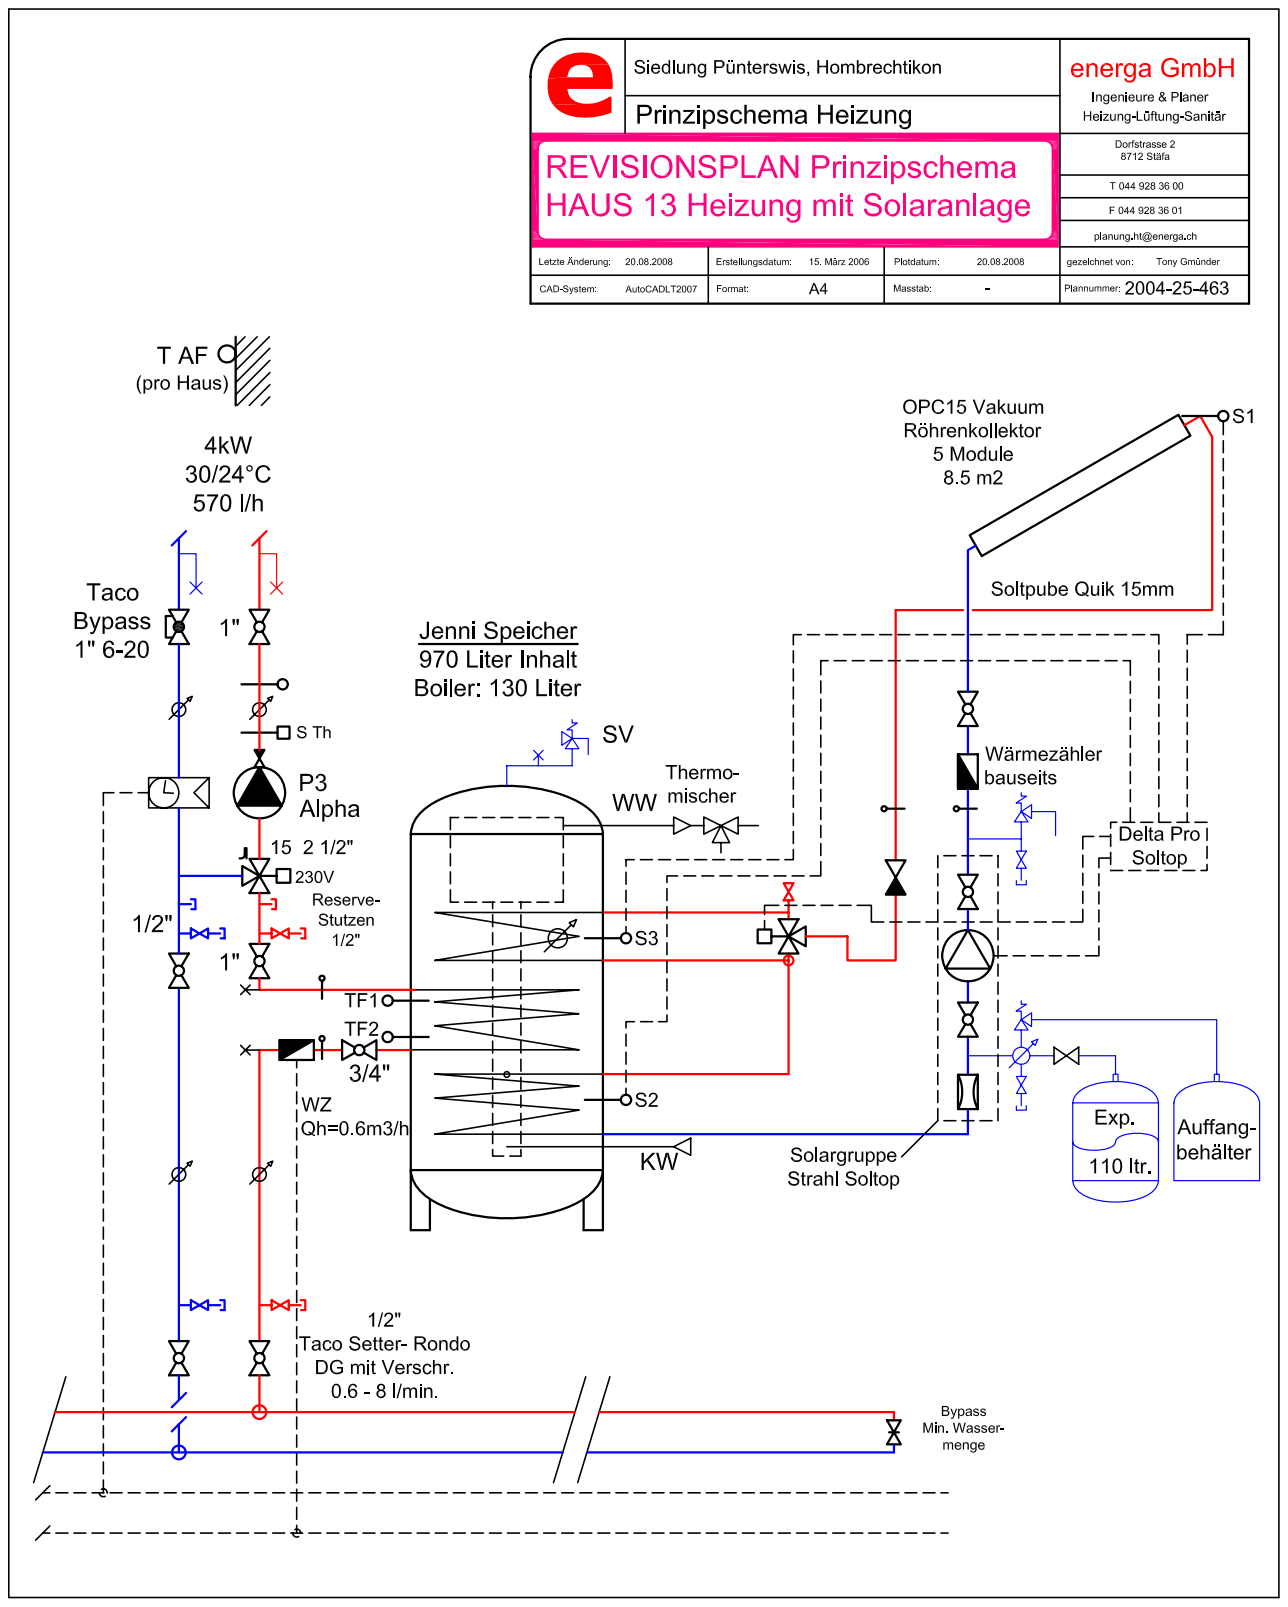
[picture p140: page 1]
