petermaerki/puenterswis_heizung_2023_git/hardware_dezentral/pcb_kicad/pcb_dezentral.kicad_pcb

## KiCad design hardware_dezentral/pcb_kicad/pcb_dezentral.kicad_pcb (2024-01-20)

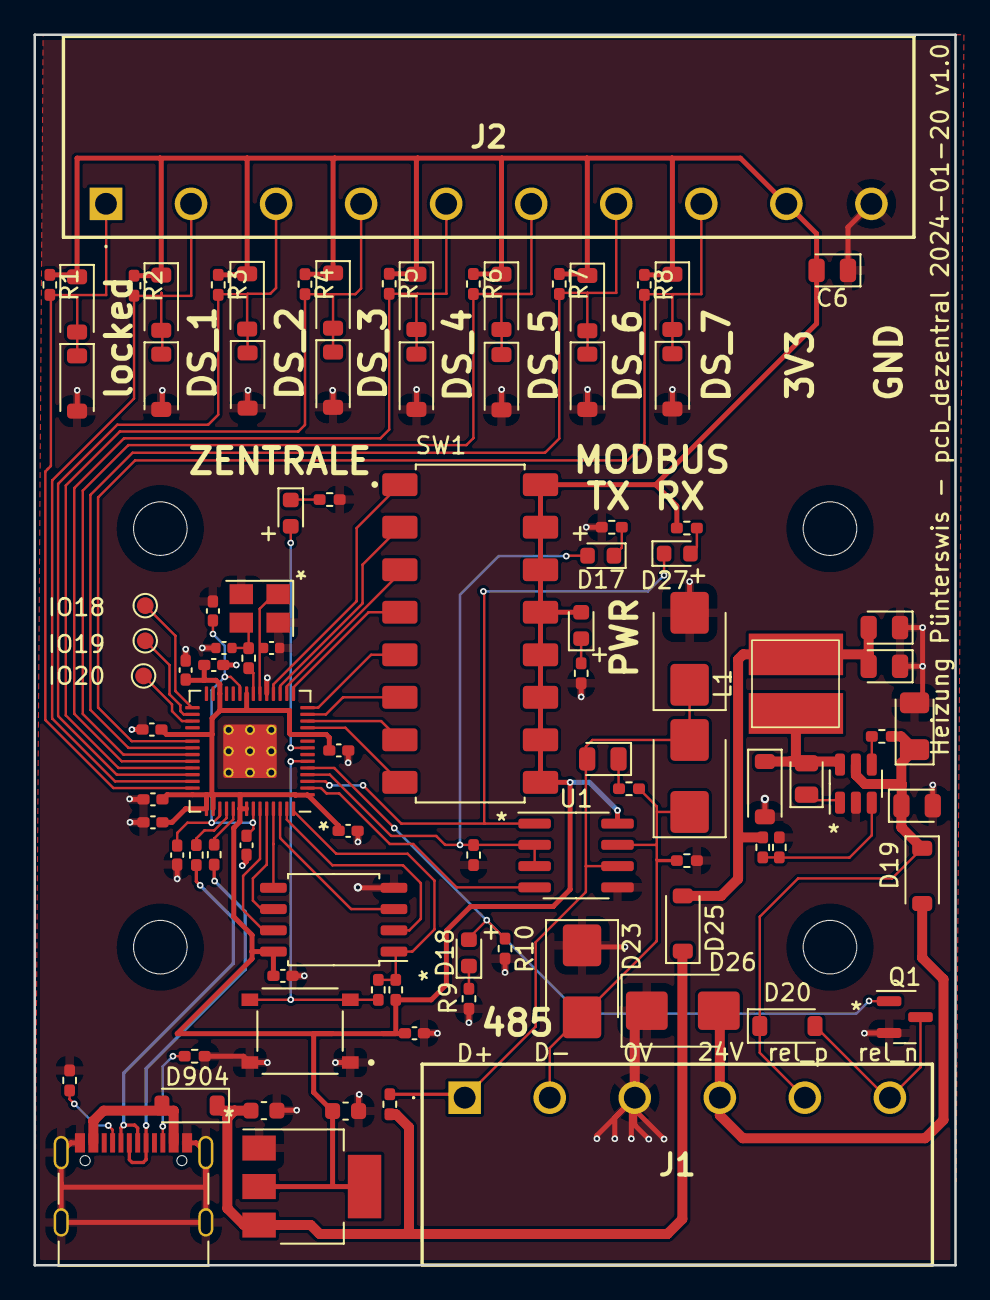
[picture p141: board pcb_dezentral.kicad_pcb from above]

Board: 2 copper layers, 55.0 x 73.5 mm, 98 parts (0 on the bottom side), 61 nets.

Parts:
C1: 4u7 50V; D_1206_3216Metric
C2, C3, C5, C6, C7: 100n 50V; D_0805_2012Metric
C4: 10u 25V; D_0805_2012Metric
C901, C902: 10u; C_0603_1608Metric
C903, C904, C907, C908, C911, C912, C913, C914, C915, C916: 100n; C_0402_1005Metric_Pad0.74x0.62mm_HandSolder
C905, C906: 1u; C_0402_1005Metric_Pad0.74x0.62mm_HandSolder
C909, C910: 30p; C_0402_1005Metric
D1, D2, D3, D4, D5, D6, D7, D8, D9, D10, D11, D12, D13, D14, D15, D16, D19, D20, D24, D25, D904: B5819W SL; D_SOD-123
D17: LED RED; LED_0603_1608Metric
D18, D28: LED WHITE; LED_0603_1608Metric
D21, D22, D23: SMBJ6.5CA; D_SMB
D26: SMBJ30CA; D_SMB
D27: LED BLUE; LED_0603_1608Metric
D901: LED GREEN; LED_0603_1608Metric
HOLDER1: din_rail_pcb_holder
IO18, IO19, IO20: TestPoint; TestPoint_Pad_D1.0mm
J1: weidmueller_SL5.08HC-06-90
J2: weidmueller_SL5.08HC-10-90
J901: USB_C_Receptacle_USB2.0; USB_C_Receptacle_Palconn_UTC16-G
L1: 22uH; L_MODBUS
Q1: AO3400A; SOT-23
R1, R2, R3, R4, R5, R6, R7, R8, R14, R17: 4k7; R_0402_1005Metric_Pad0.72x0.64mm_HandSolder
R9: 470; R_0402_1005Metric_Pad0.72x0.64mm_HandSolder
R10, R13, R18, R19: 10k; R_0402_1005Metric_Pad0.72x0.64mm_HandSolder
R11: 100k; R_0402_1005Metric_Pad0.72x0.64mm_HandSolder
R12: 56k; R_0402_1005Metric_Pad0.72x0.64mm_HandSolder
R15, R16, R20, R905: 470R; R_0402_1005Metric_Pad0.72x0.64mm_HandSolder
R901, R902: 5.1K; R_0402_1005Metric_Pad0.72x0.64mm_HandSolder
R903, R904: 27R; R_0402_1005Metric_Pad0.72x0.64mm_HandSolder
R906: 1K; R_0402_1005Metric_Pad0.72x0.64mm_HandSolder
R907: 10K; R_0402_1005Metric_Pad0.72x0.64mm_HandSolder
R908: 1k; R_0402_1005Metric_Pad0.72x0.64mm_HandSolder
SW1: dip_switch_SPST16
SW901: SW_MEC_5E; SW_TS-1187A-B-A-B
U1: SP3485EN-L/TR; SOIC-8_3.9x4.9mm_P1.27mm
U2: AOZ1282CI; SOT-23-6
U901: RP2040; RP2040-QFN-56
U902: AMS1117-3.3; SOT-223-3_TabPin2
U903: W25Q128JVS; SOIC-8_5.23x5.23mm_P1.27mm
Y901: Crystal_GND24_Small; Crystal_SMD_3225-4Pin_3.2x2.5mm

Connections:
24Vp: C1.1, C2.1, D19.1 (K), D20.1 (K), J1.5, R11.1, U2.5 (VIN)
485_24V: D19.2 (A), D26.2 (A2), J1.4
485_D+: C7.2, D21.1 (A1), D22.2 (A2), J1.1, R18.2, U1.6 (A)
485_D-: D22.1 (A1), D23.2 (A2), J1.2, R17.2, R19.1, U1.7 (B)
+1V1: C903.1, C904.1, C905.1, U901.23 (DVDD), U901.45 (VREG-VOUT), U901.50 (DVDD)
+3V3: C6.2, C902.1, C906.1, C907.1, C908.1, C911.1, C912.1, C913.1, C914.1, C915.1, C916.1, D1.1 (K), D3.1 (K), D5.1 (K), D7.1 (K), D9.1 (K), D11.1 (K), D13.1 (K), D15.1 (K), D901.2 (A), J2.9, R1.1, R2.1, R3.1, R4.1, R5.1, R6.1, R7.1, R8.1, R15.1, R907.1, SW1.1-1, SW1.2-1, SW1.3-1, SW1.4-1, SW1.5-1, SW1.6-1, SW1.7-1, SW1.8-1, U1.8 (VCC), U901.1 (IOVDD), U901.10 (IOVDD), U901.22 (IOVDD), U901.26 (RUN), U901.33 (IOVDD), U901.42 (IOVDD), U901.43 (ADC-AVDD), U901.44 (VREG-VIN), U901.48 (USB-VDD), U901.49 (IOVDD), U902.2 (VO), U903.8 (VCC)
+5V: C901.1, D25.1 (K), D904.1 (K), R18.1, U902.3 (VI)
/cpu/QSPI_SCLK: U901.52 (QSPI-SCLK), U903.6 (CLK)
/cpu/QSPI_SD0: U901.53 (QSPI-SD0), U903.5 (DI(IO0))
/cpu/QSPI_SD1: U901.55 (QSPI-SD1), U903.2 (DO(IO1))
/cpu/QSPI_SD2: U901.54 (QSPI-SD2), U903.3 (IO2)
/cpu/QSPI_SD3: U901.51 (QSPI-SD3), U903.7 (IO3)
/cpu/QSPI_SS: R906.2, R907.2, U901.56 (QSPI-SS-N), U903.1 (~CS)
/cpu/USB_D+: J901.A6 (D+), J901.B6 (D+), R903.1
/cpu/USB_D-: J901.A7 (D-), J901.B7 (D-), R904.1
/cpu/XIN: C909.1, U901.20 (XIN), Y901.1
/cpu/XOUT: R908.1, U901.21 (XOUT)
GND: C1.2, C2.2, C4.1, C5.1, C6.1, C901.2, C902.2, C903.2, C904.2, C905.2, C906.2, C907.2, C908.2, C909.2, C910.2, C911.2, C912.2, C913.2, C914.2, C915.2, C916.2, D2.2 (A), D4.2 (A), D6.2 (A), D8.2 (A), D10.2 (A), D12.2 (A), D14.2 (A), D16.2 (A), D21.2 (A2), D23.1 (A1), D24.2 (A), D26.1 (A1), J1.3, J2.10, J901.A1 (GND), J901.A12 (GND), J901.B1 (GND), J901.B12 (GND), J901.S1 (SHIELD), Q1.2 (S), R9.2, R10.2, R13.2, R14.2, R16.2, R19.2, R20.1, R901.2, R902.2, R905.1, SW901.1, SW901.2, U1.5 (GND), U2.2 (GND), U901.19 (TESTEN), U901.57 (GND), U902.1 (GND), U903.4 (GND), Y901.2, Y901.4
MODBUS_DE: D17.2 (A), R14.1, U1.2 (~RE), U1.3 (DE), U901.4 (GPIO2)
MODBUS_DI: U1.4 (DI), U901.2 (GPIO0)
MODBUS_RO: D27.1 (K), U1.1 (RO), U901.3 (GPIO1)
unnamed: C7.1, R17.1
unnamed: C910.1, R908.2, Y901.3
unnamed: D17.1 (K), R16.1
unnamed: D18.1 (K), R9.1
unnamed: C3.2, D24.1 (K), L1.1, U2.6 (LX)
unnamed: C4.2, C5.2, D25.2 (A), L1.2, R12.2
unnamed: D27.2 (A), R15.2
unnamed: D28.1 (K), R20.2
unnamed: D901.1 (K), R905.2
unnamed: D904.2 (A), J901.A4 (VBUS), J901.A9 (VBUS), J901.B4 (VBUS), J901.B9 (VBUS)
unnamed: J901.A5 (CC1), R901.1
unnamed: J901.B5 (CC2), R902.1
unnamed: C3.1, U2.1 (BST)
unnamed: R11.2, U2.4 (EN)
unnamed: R12.1, R13.1, U2.3 (FB)
unnamed: IO18.1, U901.29 (GPIO18)
unnamed: IO19.1, U901.30 (GPIO19)
unnamed: IO20.1, U901.31 (GPIO20)
unnamed: R904.2, U901.46 (USB-DM)
unnamed: R903.2, U901.47 (USB-DP)
ZENTRALE_LED: D28.2 (A), U901.8 (GPIO6)
button: R906.1, SW901.3 (K), SW901.4 (A), U901.6 (GPIO4)
ds_0: D1.2 (A), D2.1 (K), J2.1, R1.2, U901.41 (GPIO29/ADC3)
ds_1: D3.2 (A), D4.1 (K), J2.2, R2.2, U901.40 (GPIO28/ADC2)
ds_2: D5.2 (A), D6.1 (K), J2.3, R3.2, U901.39 (GPIO27/ADC1)
ds_3: D7.2 (A), D8.1 (K), J2.4, R4.2, U901.38 (GPIO26/ADC0)
ds_4: D9.2 (A), D10.1 (K), J2.5, R5.2, U901.37 (GPIO25)
ds_5: D11.2 (A), D12.1 (K), J2.6, R6.2, U901.36 (GPIO24)
ds_6: D13.2 (A), D14.1 (K), J2.7, R7.2, U901.35 (GPIO23)
ds_7: D15.2 (A), D16.1 (K), J2.8, R8.2, U901.34 (GPIO22)
modbus_addr_0: SW1.1, U901.18 (GPIO15)
modbus_addr_1: SW1.2, U901.17 (GPIO14)
modbus_addr_2: SW1.3, U901.16 (GPIO13)
modbus_addr_3: SW1.4, U901.15 (GPIO12)
modbus_addr_4: SW1.5, U901.14 (GPIO11)
modbus_addr_5: SW1.6, U901.13 (GPIO10)
modbus_addr_6: SW1.7, U901.12 (GPIO9)
modbus_addr_7: SW1.8, U901.11 (GPIO8)
rel: D18.2 (A), Q1.1 (G), R10.1, U901.5 (GPIO3)
rel_n: D20.2 (A), J1.6, Q1.3 (D)
