petermaerki/puenterswis_heizung_2023_git/software/software-zentral/zentral/context.py

import asyncio
import logging
import os
import signal
import time
import typing

from zentral import util_ssh_repl
from zentral.config_base import ConfigEtappe, Haus
from zentral.constants import DIRECTORY_LOG, Waveshare_4RS232
from zentral.hsm_zentral import HsmZentral
from zentral.util_history_verbrauch_haus import INTERVAL_VERBRAUCH_HAUS_S
from zentral.util_influx import HsmDezentralInfluxLogger, HsmZentralInfluxLogger, Influx
from zentral.util_mbus import MBus
from zentral.util_modbus import get_serial_port2
from zentral.util_modbus_communication import ModbusCommunication
from zentral.util_modbus_exception import exception_handler_and_exit
from zentral.util_persistence_legionellen import LEGIONELLEN_KILLED_C, PersistenceLegionellen
from zentral.util_persistence_mischventil import PersistenceMischventil
from zentral.util_scenarios import SCENARIOS, ScenarioInfluxWriteCrazy, ScenarioMBusReadInterval, ssh_repl_update_scenarios

logger = logging.getLogger(__name__)


ASYNCIO_TASK_HSM_DEZENTRAL_S = 60.0


class Context:
    def __init__(self, config_etappe: ConfigEtappe):
        self.config_etappe = config_etappe
        self.modbus_communication = self._factory_modbus_communication()
        self.mbus = self._factory_mbus_communication()
        self.influx = Influx()
        self.hsm_zentral = HsmZentral(ctx=self)
        self.hsm_zentral.init()
        self.hsm_zentral.write_mermaid_md(DIRECTORY_LOG / f"statemachine_{self.hsm_zentral.__class__.__name__}.md")
        influx_logger = HsmZentralInfluxLogger(influx=self.influx, ctx=self)
        self.hsm_zentral.add_logger(hsm_logger=influx_logger)
        self._persistence_legionellen = PersistenceLegionellen()
        self.vorladen_aktiv = False

        def sigterm_handler(_signo, _stack_frame) -> typing.NoReturn:
            logger.warning("Received SIGTERM. Cleaning up...")
            self.close_and_flush_influx()
            logger.warning("...done")
            os._exit(0)

        signal.signal(signal.SIGTERM, sigterm_handler)

    def _factory_modbus_communication(self) -> ModbusCommunication:
        return ModbusCommunication(self)

    def _factory_mbus_communication(self) -> None | MBus:
        port = get_serial_port2(n=Waveshare_4RS232.MBUS_WAERMEZAEHLER)
        return MBus(port=port)

    @property
    def is_winter(self) -> bool:
        TaussenU_C = self.modbus_communication.pcbs_dezentral_heizzentrale.TaussenU_C
        return TaussenU_C < 14.0

    @property
    def haeuser_ladung_avg_soll_prozent_min(self) -> float:
        '''Je kaelter es ist, desto eher wird gebadet und desto weniger kann ich grosse Schwankungen auffangen. Daher Reserve.'''
        TaussenU_C = self.modbus_communication.pcbs_dezentral_heizzentrale.TaussenU_C
        Taussen_C_kalt = -10.0
        Taussen_C_warm = 14.0
        Prozent_kalt = 50.0
        Prozent_warm = 16.0
        prozent = (TaussenU_C - Taussen_C_kalt) * (Prozent_warm - Prozent_kalt) / (
            Taussen_C_warm - Taussen_C_kalt
        ) + Prozent_kalt
        prozent = min(prozent, Prozent_kalt)
        prozent = max(prozent, Prozent_warm)
        return prozent

    @property
    def is_sommer(self) -> bool:
        return not self.is_winter

    @property
    def is_vorladen_aktiv(self) -> bool:
        return self.vorladen_aktiv

    @property
    def is_mock(self) -> bool:
        return False

    def sp_verbrauch_median_W(self, time_s: float) -> float:
        """
        Angenommen time_s ist 6 Uhr am Morgen.
        So wird der verbrauch_W um 6 Uhr zurückgegeben.
        Dabei wird der Median um 6 Uhr für alle Häuser angewendet.
        """
        list_verbrauch_W: list[float] = []
        for haus in self.config_etappe.haeuser:
            for verbrauch_W in haus.status_haus.hsm_dezentral.verbrauch.history.iter_verbrauch(time_s=time_s):
                list_verbrauch_W.append(verbrauch_W)
        if len(list_verbrauch_W) == 0:
            return 0.0
        list_verbrauch_W.sort()
        median_W = list_verbrauch_W[len(list_verbrauch_W) // 2]
        return median_W

    def sp_verbrauch_W(self, time_s: float) -> float:
        return self.sp_verbrauch_median_W(time_s=time_s) * len(self.config_etappe.haeuser)

    def close_and_flush_influx(self) -> None:
        self.influx.close_and_flush()
        for haus in self.config_etappe.haeuser:
            if haus.status_haus_or_None is not None:
                haus.status_haus_or_None.hsm_dezentral.save_persistence(why="Exiting app")

        self._persistence_legionellen.save(force=True, why="Exiting app")
        PersistenceMischventil.save(self.hsm_zentral.mischventil_stellwert_100)

    async def init(self) -> None:
        self.config_etappe.init()

        for haus in self.config_etappe.haeuser:
            haus.status_haus.hsm_dezentral._context = self
            haus.status_haus.hsm_dezentral.init()

        # Add influx logger
        for haus in self.config_etappe.haeuser:
            influx_logger = HsmDezentralInfluxLogger(influx=self.influx, ctx=self, haus=haus)
            haus.status_haus.hsm_dezentral.add_logger(hsm_logger=influx_logger)

        # Start the statemachine.
        # This will already send message to influx
        self.hsm_zentral.start()
        for haus in self.config_etappe.haeuser:
            haus.status_haus.hsm_dezentral.start()

    async def create_ssh_repl(self) -> None:
        def influx_delete_bucket_virgin():
            _task = asyncio.create_task(self.influx.delete_bucket_virgin())

        repl_globals = dict(
            ctx=self,
            influx_delete_bucket_virgin=influx_delete_bucket_virgin,
        )
        hausnummern = self.config_etappe.hausnummern
        ssh_repl_update_scenarios(repl_globals=repl_globals, hausnummern=hausnummern)
        await util_ssh_repl.create(repl_globals=repl_globals, hausnummern=hausnummern)

    async def task_hsm(self) -> None:
        async def sleep(duration_s: float):
            # Sleep duration_s
            while duration_s > 0.0:
                await asyncio.sleep(10.0)
                duration_s -= 10.0
                if SCENARIOS.is_present(ScenarioInfluxWriteCrazy):
                    #  Sleep only 2s when a ScenarioInfluxWriteCrazy is active
                    return

        async with exception_handler_and_exit(ctx=self, task_name="hsm", exit_code=45):
            while True:
                for haus in self.config_etappe.haeuser:
                    await self.influx.send_hsm_dezental(ctx=self, haus=haus)

                def update() -> None:
                    """
                    Find all hauses 'with > LEGIONELLEN_KILLED_C'
                    and update '_haueser_last_legionenellen_killed'.
                    """
                    for haus in self.config_etappe.haeuser:
                        sp_temperatur = haus.get_sp_temperatur()
                        if sp_temperatur is None:
                            continue
                        if sp_temperatur.mitte_C > LEGIONELLEN_KILLED_C:
                            self._persistence_legionellen.set_last_legionellen_killed_s(haus.influx_tag)

                    self._persistence_legionellen.save(force=False, why="...")

                update()

                await self.influx.send_hsm_zentral(ctx=self)

                await sleep(duration_s=ASYNCIO_TASK_HSM_DEZENTRAL_S)

    async def task_verbrauch(self) -> None:
        async with exception_handler_and_exit(ctx=self, task_name="verbrauch", exit_code=46):
            while True:
                for haus in self.config_etappe.haeuser:
                    await haus.status_haus.hsm_dezentral.handle_history_verbrauch()

                await asyncio.sleep(INTERVAL_VERBRAUCH_HAUS_S / 100.0)

    async def task_mbus(self) -> None:
        async with exception_handler_and_exit(ctx=self, task_name="mbus", exit_code=46):

            async def read(haus: Haus) -> None:
                if haus.status_haus_or_None is None:
                    relais_valve_open = False
                else:
                    relais_valve_open = haus.status_haus_or_None.hsm_dezentral.dezentral_gpio.relais_valve_open
                max_retries = 5
                for _ in range(max_retries):
                    if self.mbus is None:
                        continue
                    measurement = await self.mbus.read_mulical303_or_None(
                        address=haus.config_haus.mbus_address,
                        relais_valve_open=relais_valve_open,
                    )
                    if measurement is None:
                        continue
                    if haus.status_haus.hsm_dezentral is None:
                        continue
                    haus.status_haus.hsm_dezentral.mbus_measurement = measurement
                    await self.influx.send_mbus_haus(haus=haus, mbus_measurement=measurement)
                    return

                logger.warning(f"Haus {haus.config_haus.nummer}: Failed to read from mbus address {haus.config_haus.mbus_address}")

            async def scenario_sleep(sleep_s: float):
                """
                Sleeps 'sleep_s' seconds.
                However, `ScenarioMBusReadInterval` may reduce this time.
                """
                begin_s = time.monotonic()
                while True:
                    if self.hsm_zentral.is_controller_master_valve_iterator:
                        # Measure often while we iterate over the valves
                        await asyncio.sleep(10.0)
                        return
                    scenario = SCENARIOS.find(ScenarioMBusReadInterval)
                    if scenario is not None:
                        await asyncio.sleep(scenario.sleep_s)
                        return
                    duration_s = time.monotonic() - begin_s
                    if duration_s > sleep_s:
                        return
                    await asyncio.sleep(10.0)

            while True:
                for haus in self.config_etappe.haeuser:
                    await read(haus)
                await self.influx.send_mbus_sum(ctx=self)

                await scenario_sleep(sleep_s=3000.0 / 2)

    async def __aenter__(self):
        await self.modbus_communication.connect()
        return self

    async def __aexit__(self, *exc):
        await self.modbus_communication.close()
        self.close_and_flush_influx()
        return False
