petermaerki/puenterswis_heizung_2023_git/software/software-zentral/doc/readme_experiment_m-bus/mbus-serial-scan-secondary.py

# Copied from
# https://github.com/ganehag/pyMeterBus/blob/master/tools/mbus-serial-scan-secondary.py
import argparse
import pathlib
import time

DIRECTORY_OF_THIS_FILE = pathlib.Path(__file__).parent
DIRECTORY_MBUS = DIRECTORY_OF_THIS_FILE / "mbus"

import serial

try:
    import meterbus
except ImportError:
    import sys

    sys.path.append("../")
    import meterbus


def ping_address(ser, address, retries=5, read_echo=False):
    for i in range(0, retries + 1):
        meterbus.send_ping_frame(ser, address, read_echo)
        try:
            frame = meterbus.load(meterbus.recv_frame(ser, 1))
            if isinstance(frame, meterbus.TelegramACK):
                return True
        except meterbus.MBusFrameDecodeError:
            pass

        time.sleep(0.5)

    return False


def init_slaves(ser, read_echo=False):
    if False == ping_address(ser, meterbus.ADDRESS_NETWORK_LAYER, 0, read_echo):
        return ping_address(ser, meterbus.ADDRESS_BROADCAST_NOREPLY, 0, read_echo)
    else:
        return True

    return False


def mbus_scan_secondary_address_range(ser, pos, mask, read_echo=False):
    # F character is a wildcard
    if mask[pos].upper() == "F":
        l_start, l_end = 0, 9
    else:
        if pos < 15:
            mbus_scan_secondary_address_range(ser, pos + 1, mask, read_echo)
        else:
            l_start = l_end = ord(mask[pos]) - ord("0")

    if mask[pos].upper() == "F" or pos == 15:
        for i in range(l_start, l_end + 1):  # l_end+1 is to include l_end val
            new_mask = (mask[:pos] + "{0:1X}".format(i) + mask[pos + 1 :]).upper()
            val, match, manufacturer = mbus_probe_secondary_address(ser, new_mask, read_echo)
            if val is True:
                print("Device found with id {0} ({1}), using mask {2}".format(match, manufacturer, new_mask))
            elif val is False:  # Collision
                mbus_scan_secondary_address_range(ser, pos + 1, new_mask, read_echo)


def mbus_probe_secondary_address(ser, mask, read_echo=False):
    # False -> Collison
    # None -> No reply
    # True -> Single reply
    meterbus.send_select_frame(ser, mask, read_echo)
    try:
        data = meterbus.recv_frame(ser, 1)
        frame = meterbus.load(data=data)
    except meterbus.MBusFrameDecodeError as e:
        frame = e.value

    if isinstance(frame, meterbus.TelegramACK):
        for retry in range(5):
            time.sleep(0.1)
            meterbus.send_request_frame(ser, meterbus.ADDRESS_NETWORK_LAYER, read_echo=read_echo)
            if meterbus.g.debug:
                print(f"ACK {retry}")

            frame = None
            try:
                data = meterbus.recv_frame(ser)
                frame = meterbus.load(data=data)
            except meterbus.MBusFrameDecodeError as e:
                if meterbus.g.debug:
                    print(f"meterbus.MBusFrameDecodeError: {e}")
                time.sleep(0.1)

            if isinstance(frame, meterbus.TelegramLong):
                # print(f"{frame.secondary_address}")
                # print(f"{frame.manufacturer}")
                # print(frame.to_JSON())
                DIRECTORY_MBUS.mkdir(parents=True, exist_ok=True)
                filename = DIRECTORY_MBUS / f"mbus-{frame.manufacturer}-{frame.secondary_address}.json"
                filename.write_text(frame.to_JSON())
                filename.with_suffix(".hex").write_text(frame.body.bodyPayload.body.decodeRAW)
                return True, frame.secondary_address, frame.manufacturer

        return None, None, None

    return frame, None, None


def main(args):
    try:
        with serial.serial_for_url(args.device, args.baudrate, 8, "E", 1, timeout=0.4) as ser:
            # Ensure we are at the beginning of the records
            init_slaves(ser, args.echofix)

            mbus_scan_secondary_address_range(ser, 0, args.address, args.echofix)

    except serial.serialutil.SerialException as e:
        print(e)


if __name__ == "__main__":

    def sec_addr_valid(string):
        if False == meterbus.is_secondary_address(string):
            raise argparse.ArgumentTypeError("Not a valid secondary address mask")
        return string

    parser = argparse.ArgumentParser(description="Scan serial M-Bus for devices.")
    parser.add_argument("-d", action="store_true", help="Enable verbose debug")
    parser.add_argument("--address", type=sec_addr_valid, default="FFFFFFFFFFFFFFFF", help="Secondary address mask")
    parser.add_argument("-b", "--baudrate", type=int, default=2400, help="Serial bus baudrate")
    # FIXME
    # parser.add_argument('-r', '--retries',
    #                     type=int, default=3,
    #                     help='Number of ping retries for each address')
    parser.add_argument("--echofix", action="store_true", help="Read and ignore echoed data from target")
    parser.add_argument("device", type=str, help="Serial device or URI")

    _args = ["-d", "-b", "2400", "--address", "FFFFFFFFFFFFFFFF", "/dev/ttyACM2"]
    _args = ["-d", "-b", "2400", "--address", "8FFFFFFFFFFFFFFF", "/dev/ttyACM2"]
    _args = ["-b", "2400", "--address", "8FFFFFFFFFFFFFFF", "/dev/ttyACM2"]
    args = parser.parse_args(args=_args)

    meterbus.debug(args.d)

    main(args)
