petermaerki/puenterswis_heizung_2023_git/(commit log)

2023-11-18 entwurf hardware
    [20231117a_kabel_fernleitung_uebersicht.ods, pinout.ods]
2023-11-19 Initial import from filamentdryer v0.6
    [110990030.stp, 114020164.stp, BOM_PCB_8X8 NEOPIXLE_2021-12-03.csv, IC57_RP2040.step, PKMCS0909E4000-R1--3DModel-STEP-56544.STEP, RP2040.step, SHT31.step, SS-52400-002--3DModel-STEP-56544.STEP]
2023-11-19 Rename directories '-obsolete'
    [110990030.stp, 114020164.stp, BOM_PCB_8X8 NEOPIXLE_2021-12-03.csv, IC57_RP2040.step, PKMCS0909E4000-R1--3DModel-STEP-56544.STEP, RP2040.step, SHT31.step, SS-52400-002--3DModel-STEP-56544.STEP]
2023-11-19 Update components
    [TS-1187A-B-A-B.step, TYPE-C-31-M-12--3DModel-STEP-56544.STEP, filament_dryer.kicad_pcb, filament_dryer.kicad_sch]
2023-11-19 rename folder
    [110990030.stp, 114020164.stp, BOM_PCB_8X8 NEOPIXLE_2021-12-03.csv, IC57_RP2040.step, PKMCS0909E4000-R1--3DModel-STEP-56544.STEP, RP2040.step, SHT31.step, SS-52400-002--3DModel-STEP-56544.STEP]
2023-11-19 Renamed to pcb_dezentral
    [filament_dryer.kicad_pcb, pcb_dezentral.kicad_pcb, pcb_dezentral.kicad_sch]
2023-11-19 Added footprints
    [1146380000.stp, 1146570000.stp, 1146770000.stp, 1146940000.stp, pcb_dezentral.kicad_pcb, pcb_dezentral.kicad_sch]
2023-11-19 Add pcb_zentral_pi
    [pcb_zentral_pi.kicad_pcb, pcb_zentral_pi.kicad_sch]
2023-11-19 Vor Review
    [RPi_Zero_pHat_Template.kicad_pcb, RPi_Zero_pHat_Template.sch, Raspberry Pi Zero W.kicad_pcb, Raspberry Pi Zero W.sch, Raspberry Pi Zero W.step, pcb_zentral_haus.kicad_sch, pcb_zentral_hausreihe.kicad_sch, pcb_zentral_pi.kicad_pcb]
2023-11-19 Nach Review
    [pcb_dezentral.kicad_pcb, pcb_dezentral.kicad_sch, pcb_zentral_haus.kicad_sch, pcb_zentral_hausreihe.kicad_sch, pcb_zentral_pi.kicad_pcb, pcb_zentral_pi.kicad_sch]
2023-11-22 Add 20231120a_pi5.ods
    [20231120a_pi5.ods]
2023-11-22 Add weidmueller and din_rail_pcb_holder footprints
    [1146810000.stp, 1146900000.stp, 20231122_din_rail_pcb_holder.FCStd, din_rail_pcb_holder-DIN-rail-clip-adjustable.dxf, din_rail_pcb_holder-DIN-rail-clip-adjustable.step, din_rail_pcb_holder.FCStd, pcb_dezentral.kicad_pcb, pcb_dezentral.kicad_sch]
2023-11-24 Neu weniger Kraft.
    [din_rail_pcb_holder.FCStd]
2023-11-25 Schema dezentral komplett
    [dip_switch_SPST16.step, pcb_dezentral.kicad_pcb, pcb_dezentral.kicad_sch, pcb_dezentral_cpu.kicad_sch]
2023-11-25 Kuerzere Haltelasche damit es nicht so streng geht.
    [din_rail_pcb_holder.FCStd]
2023-11-25 Fix J12
    [pcb_dezentral.kicad_pcb]
2023-11-25 Fix holder
    [din_rail_pcb_holder-DIN-rail-clip-adjustable.step]
2023-11-25 Fix holder 2
    [pcb_dezentral.kicad_pcb]
2023-11-26 Schema bereinigt
    [pcb_dezentral.kicad_sch]
2023-11-26 Schema bereinigt Peter
    [pcb_dezentral.kicad_sch]
2023-11-26 Anpassungen von Peter
    [pcb_dezentral.kicad_sch, pcb_dezentral_cpu.kicad_sch]
2023-11-26 pcb_dezentral v0.8
    [bom.csv, designators.csv, pcb_dezentral.kicad_pcb, pcb_dezentral.kicad_sch, pcb_dezentral_cpu.kicad_sch, pcb_zentral_haus.kicad_sch, pcb_zentral_hausreihe.kicad_sch, pcb_zentral_pi.kicad_pcb]
2023-11-26 pcb_dezentral, update J1/J2, v0.8
    [bom.csv, pcb_dezentral.kicad_pcb, pcb_dezentral.kicad_sch, pcb_dezentral_cpu.kicad_sch]
2023-11-27 Feedback JLCPCB, v0.81
    [bom.csv, designators.csv, pcb_dezentral.kicad_pcb, pcb_dezentral.kicad_sch, positions.csv]
2023-12-24 Bugfix: value from on_get_cb was swallowed
    [modbus.py]
2023-12-28 Optimize modbus error rate
    [main.py, serial.py, simple_rtu_client.py, util_uart_reader.py]
2024-01-17 cleaned up
    [20231119a_stromverbrauch.ods, 20231220a_fernleitung_wasser_in_leitung_maerki.ods, 20231222b_kabel_fernleitung_uebersicht.ods, 20231229a_beschriftung_temperatursensoren.ods, 20240117a_rs485_resistance_series_bias.ods, din_rail_pcb_holder-DIN-rail-clip-adjustable.dxf, din_rail_pcb_holder-DIN-rail-clip-adjustable.step, din_rail_pcb_holder.FCStd]
2024-01-20 pcb_dezentral v1.0
    [bom.csv, designators.csv, pcb_dezentral.kicad_pcb, pcb_dezentral.kicad_sch, pcb_dezentral_cpu.kicad_sch, positions.csv]
2024-01-22 Doku PCB
2024-01-25 Pi4 und Analog zu Mischventil
    [pinout.ods]
2024-02-04 BOM: C515689 -> C2897622
    [bom.csv]
2024-02-10 Beschriftung Durchgangsklemmen
    [20240125b_wago_durchgangsklemen_planung_beschriftung.ods, 20240127a_kabel_fernleitung_uebersicht.ods, 20240130a_wago_durchgangsklemen_beschriftung.ods, 20240202a_kabel_fernleitung_uebersicht.ods, 20240210a_modbus_adressen.ods]
2024-02-13 3D Modelle
    [20240212a_din_rail_pcb_holder.FCStd, 20240212a_din_rail_spacer_big_15.FCStd, 20240212a_din_rail_spacer_small_6.FCStd]
2024-03-09 Disable error history dezentral
    [example_modbus_dezentral_all.py, hardware.py, hsm_dezentral.py, portable_modbus_registers.py, util_DS18X20.py, util_constants.py, util_ds18_pairs.py, util_influx.py]
2024-03-10 Modbus Probleme.
    [20240302d_evaluation_typ.ods]
2024-03-29 Automatically load etappe. bucket 'heizung'.
2024-03-30 Gitignore angepasst, kosmetik.
    [20231220a_fernleitung_wasser_in_leitung_maerki.ods, 20240210a_modbus_adressen.ods, 20240218a_beschriftung_netzstecker.ods, 20240225a_beschriftung_.ods, 20240225a_beschriftung_steuerung_dezentral_kleber.ods, 20240329a_beschriftung_netzstecker.ods]
2024-04-20 Improved Modbus error handling
    [constants.py, context_mock.py, util_logger.py, util_modbus_communication.py, util_modbus_dac.py, util_modbus_gpio.py, util_modbus_haus.py, util_modbus_mischventil.py]
2024-05-04 dezentral v0.1.3 / Bugfix reading relais_valve_open / Bugfix changed()
    [portable_modbus_registers.py, util_constants.py, util_modbus.py]
2024-05-05 trigger scope on modbus errors
    [constants.py, util_gpio.py, util_influx.py, util_modbus_wrapper.py]
2024-05-19 Ausbaustufe E1
    [20240418a_kabel_fernleitung_uebersicht.ods, 20240519a_beschriftung_verteilerboxen_fernleitung.ods]
2024-05-21 controller mischventil
    [20240211a_elfero_schaltpunkte.ods, 20240520a_elfero_schaltpunkte.ods, 20240520b_elfero_bohrlehre_schraube_distanzbolzen_15.FCStd]
2024-06-05 Schaltpunkte Elfero hoeher
    [20240520a_elfero_schaltpunkte.ods, 20240605a_elfero_schaltpunkte.ods]
2024-07-07 Zentrale weiter ausgearbeitet, Umbenennungen
    [20240418_pulsieren.ods, 20240614c_elfero_winkel_halter.FCStd, 20240615a_elfero_winkel_halter_haus_12.FCStd, 20240707a_beschriftung_zentral_temperatursensoren.ods, 20240707a_verluste_fernleitung_einspeisung.ods]
2024-07-12 New: PcbsDezentralHeizzentrale
2024-07-18 mocked version fixed. Converted tests to pytest.
    [config_base.py, context_mock.py, controller_mischventil_test.py, util_modbus.py, util_modbus_mischventil.py, util_modbus_pcb_dezentral_heizzentrale.py, util_modbus_wrapper.py, util_persistence.py]
2024-07-18 modbus stability issued: increase TIMEOUT_AFTER_MODBUS_NO_RESPONSE_S
    [util_modbus_wrapper.py]
2024-07-19 Doku nachgefuehrt
    [20240707a_beschriftung_zentral_temperatursensoren.ods, 20240707a_vergleich_varianten.ods, 20240707a_verluste_fernleitung_einspeisung.ods]
2024-07-30 Switch to hsm_zentral.state_error in case of modbus errors
    [constants.py, hsm_zentral.py, hsm_zentral_signal.py, util_influx.py, util_modbus_communication.py, util_modbus_haus.py, util_scenarios.py, util_watchdog.py]
2024-07-30 hsm_dezentral: Fehlerverhalten implementiert und getestet
2024-07-30 Ordnerstruktur angepasst
    [1146380000.stp, 1146570000.stp, 1146770000.stp, 1146810000.stp, 1146900000.stp, 1146940000.stp, 20231119a_stromverbrauch.ods, 20231220a_fernleitung_wasser_in_leitung_maerki.ods]
2024-08-04 PCB_DEZENTRAL Temperatursensoren aktualisiert.
2024-08-11 HARGASSNER fuer puent und bochs
2024-08-13 Controller Haeuser
    [20240806a_diagramm_idee.ods]
2024-08-17 Elektro Heizsstab
    [20240812a_taco_setter_ronto_schluessel.FCStd, 20240812b_taco_setter_ronto_schluessel-body.3mf, 20240812b_taco_setter_ronto_schluessel.FCStd]
2024-09-05 Fix modbux register readings of Mischventil
    [util_influx.py, util_modbus.py, util_modbus_mischventil.py]
2024-09-06 Fix pumpe ein / gesperrt
    [controller_mischventil.py, controller_mischventil_simple.py, hsm_zentral.py, util_influx.py, util_modbus_communication.py]
2024-09-08 Neu: temperatur_aussen_C
2024-09-12 Documentation of windows tunnels
    [822_pc-template-ssh-config.txt]
2024-09-19 Peter: Tuning Temperaturen
2024-10-02 Fix tests for MBus
    [context.py, context_mock.py]
2024-10-04 Bugfix: pumpe_is_on
2024-10-05 Move code-workspace to software folder
    [822_pc-template-ssh-config-reverse-tunnel.txt]
2024-10-10 Improved: handle_brenner_mit_stoerung
    [error_analysis_2024-10-09b_oekofen.ods]
2024-10-10 Gewichtung der Hausreihen
2024-10-15 neue strategie valve open/close
2024-10-16 Fix endless loop in increase_valve_open_count()
    [handler_last.py]
2024-10-16 Do not crash if haus not reachable by mbus
    [util_mbus.py, util_scenarios.py]
2024-10-21 Notbehelf Brenner error zurück setzen falls alt
    [util_modulation_soll.py]
2024-10-27 Dokumentation, clean up
    [20240617a_eckdaten_heizung.ods]
2024-10-27 Dokumentation, cleanup
    [20240731a_tests_inbetriebnahme.ods, 20240802b_diagramm_idee.ods, 20240802c_diagramm_idee.ods, 20240804a_diagramm_idee.ods, 20240806a_diagramm_idee.ods]
2024-11-06 Test simplify valve count
2024-11-08 Bugfix legionellen-kill screw up
    [handler_last.py]
2024-11-08 neustart pico dezentral: hausreihe nicht sofort wärmen
2024-11-09 Neu: burnout für jeden Brenner
    [util_modulation_soll.py, util_scenarios.py]
2024-11-09 Logik controller_master: Action Last und Oekofen getrennt
2024-12-19 Bugfix: Brenner mit Störgung, anderer Brenner übernimmt
    [util_modbus_oekofen.py, util_oekofen_brenner_uebersicht.py]
2024-12-25 Fix: oekofen_AMBIENT_TEMP_C below 0C
    [util_modbus_oekofen.py]
