petermaerki/puenterswis_heizung_2023_git/(notices)

Notices in the files:
hardware_dezentral/pcb_kicad/00_project_parts/pi_zero/AchimPieters/Kicad Templates/Raspberry Pi Zero W/Raspberry Pi Zero W.kicad_pcb:
License: MIT - Copyright 2018 StudioPieters®
hardware_dezentral/pcb_kicad/pcb_dezentral.kicad_pcb:
Released under MIT Open-source License
parts and their libraries:
License: CC BY 4.0
